HedgehogsGX/e-ink-dap/hardware/renders/pcb_top.png

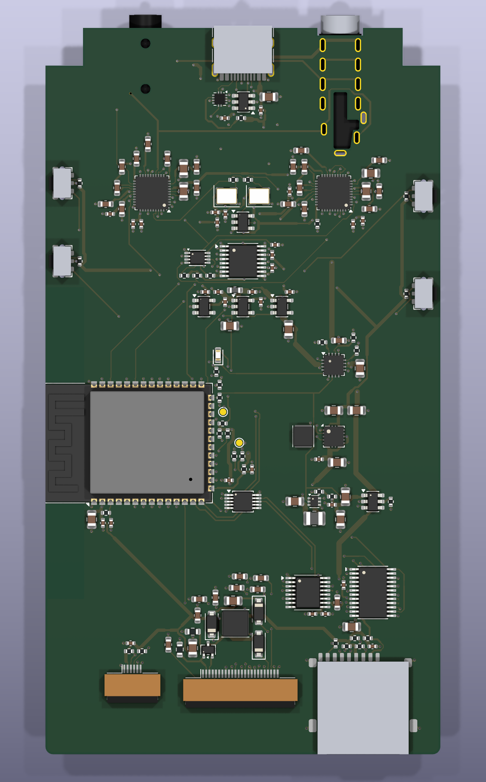
hardware/renders/pcb_top.png
