HedgehogsGX/e-ink-dap/hardware/renders/pcb_angle.png

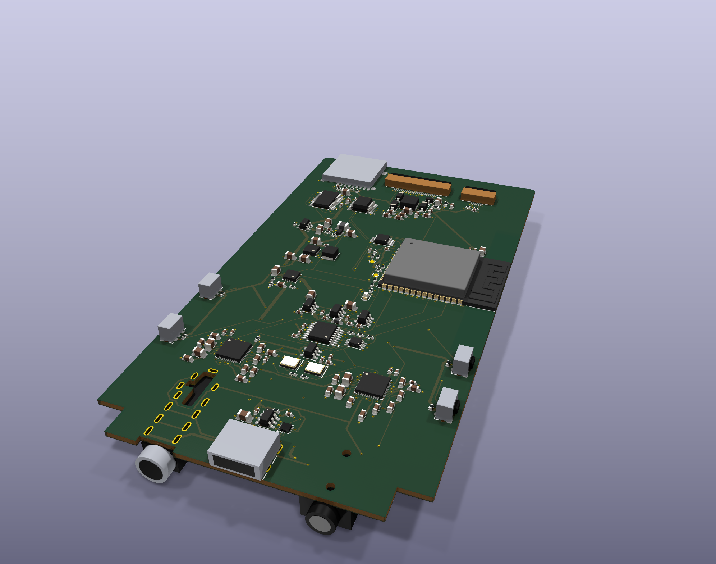
hardware/renders/pcb_angle.png
