HedgehogsGX/e-ink-dap/README.md

# e-ink-dap
DIY ESP32-S3 e-paper music player (DAP): firmware, bring-up tests and notes
