HedgehogsGX/e-ink-dap/case/renders/back.png

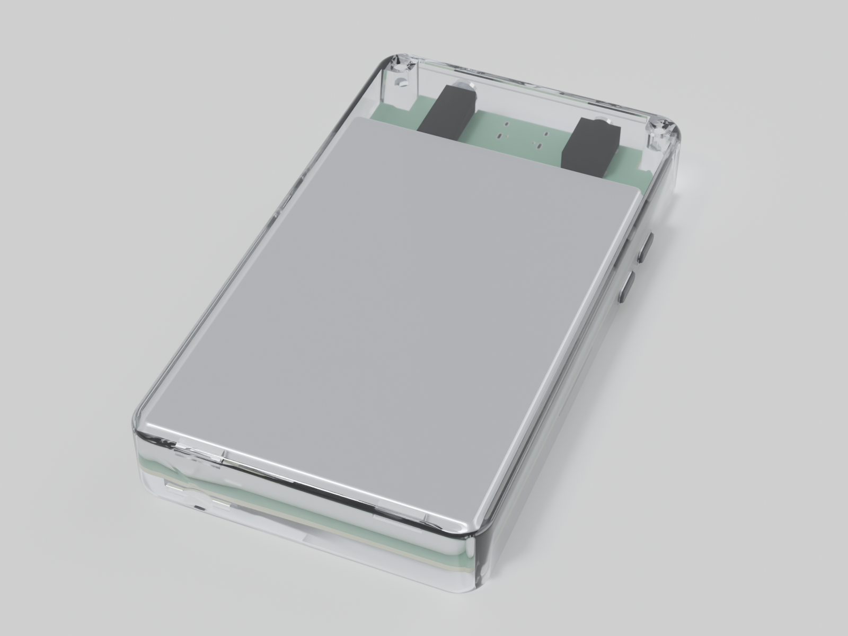
case/renders/back.png
