HedgehogsGX/e-ink-dap/case/renders/exploded.png

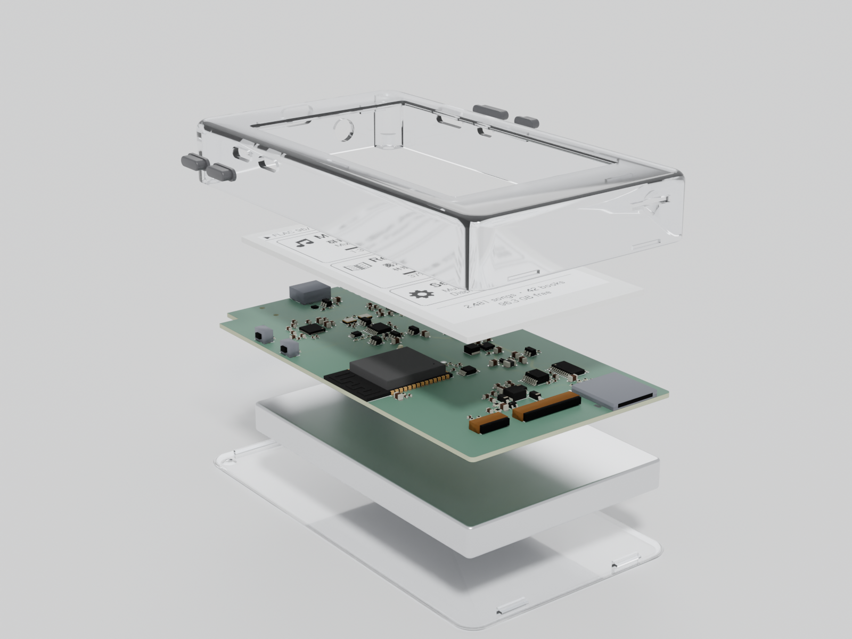
case/renders/exploded.png
