HedgehogsGX/e-ink-dap/case/renders/front.png

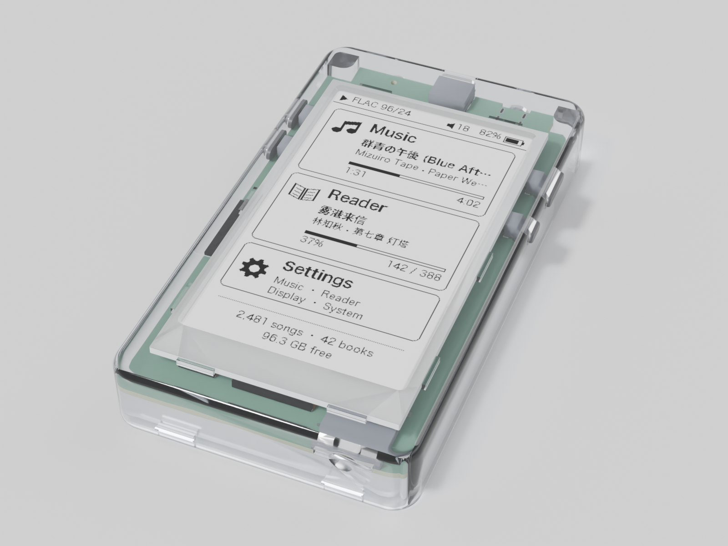
case/renders/front.png
