HedgehogsGX/e-ink-dap/case/renders/inside.png

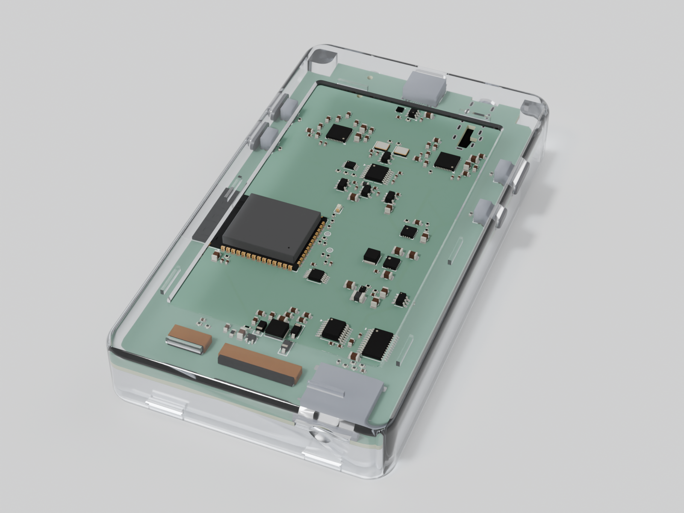
case/renders/inside.png
