HedgehogsGX/e-ink-dap/case/renders/ports.png

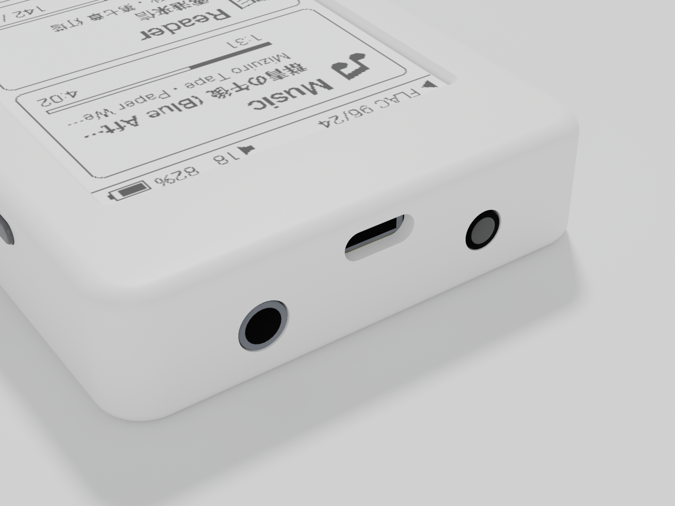
case/renders/ports.png
