HedgehogsGX/e-ink-dap/case/renders/side_left.png

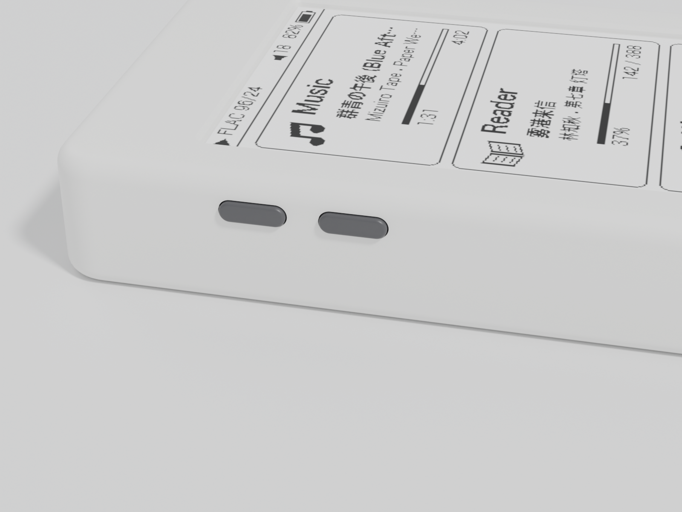
case/renders/side_left.png
