HedgehogsGX/e-ink-dap/case/renders/side_right.png

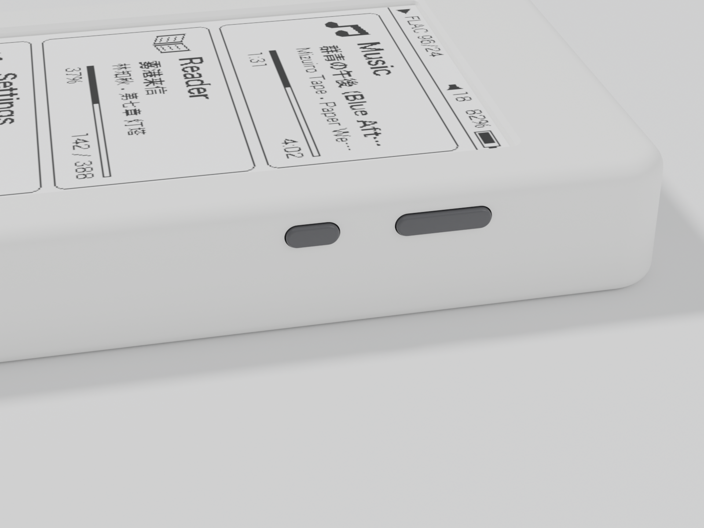
case/renders/side_right.png
