HedgehogsGX/e-ink-dap/docs/previews/eink_look.jpg

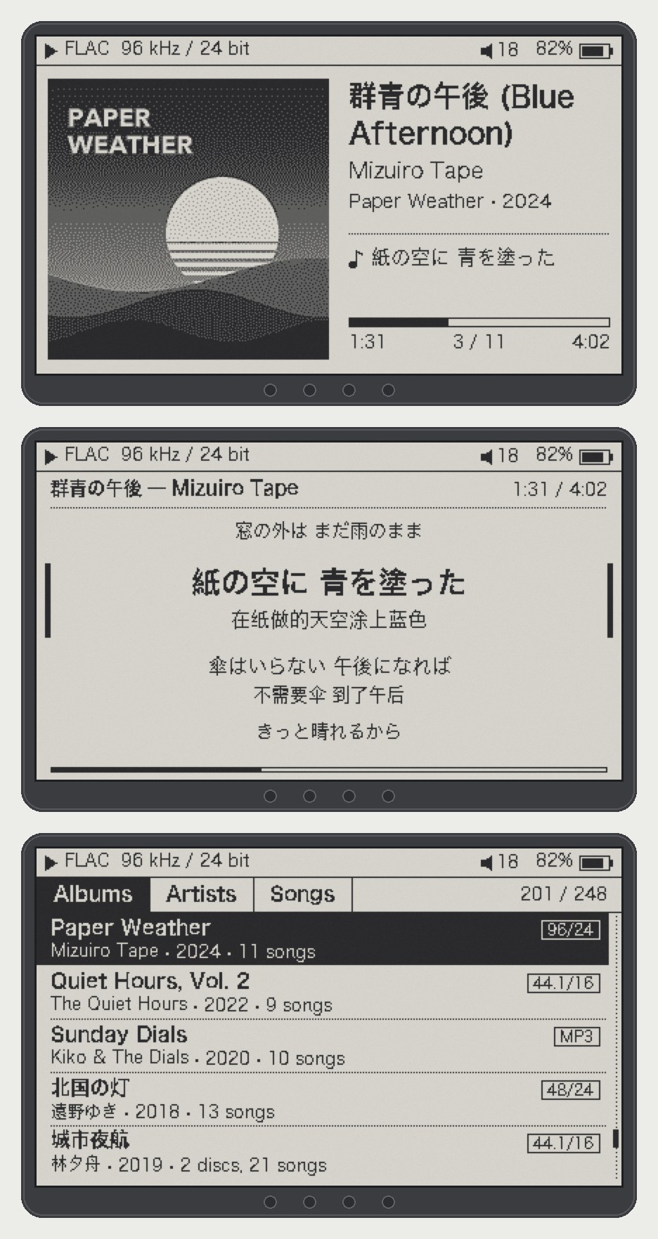
docs/previews/eink_look.jpg
