HedgehogsGX/e-ink-dap/docs/previews/eink_look_apps.jpg

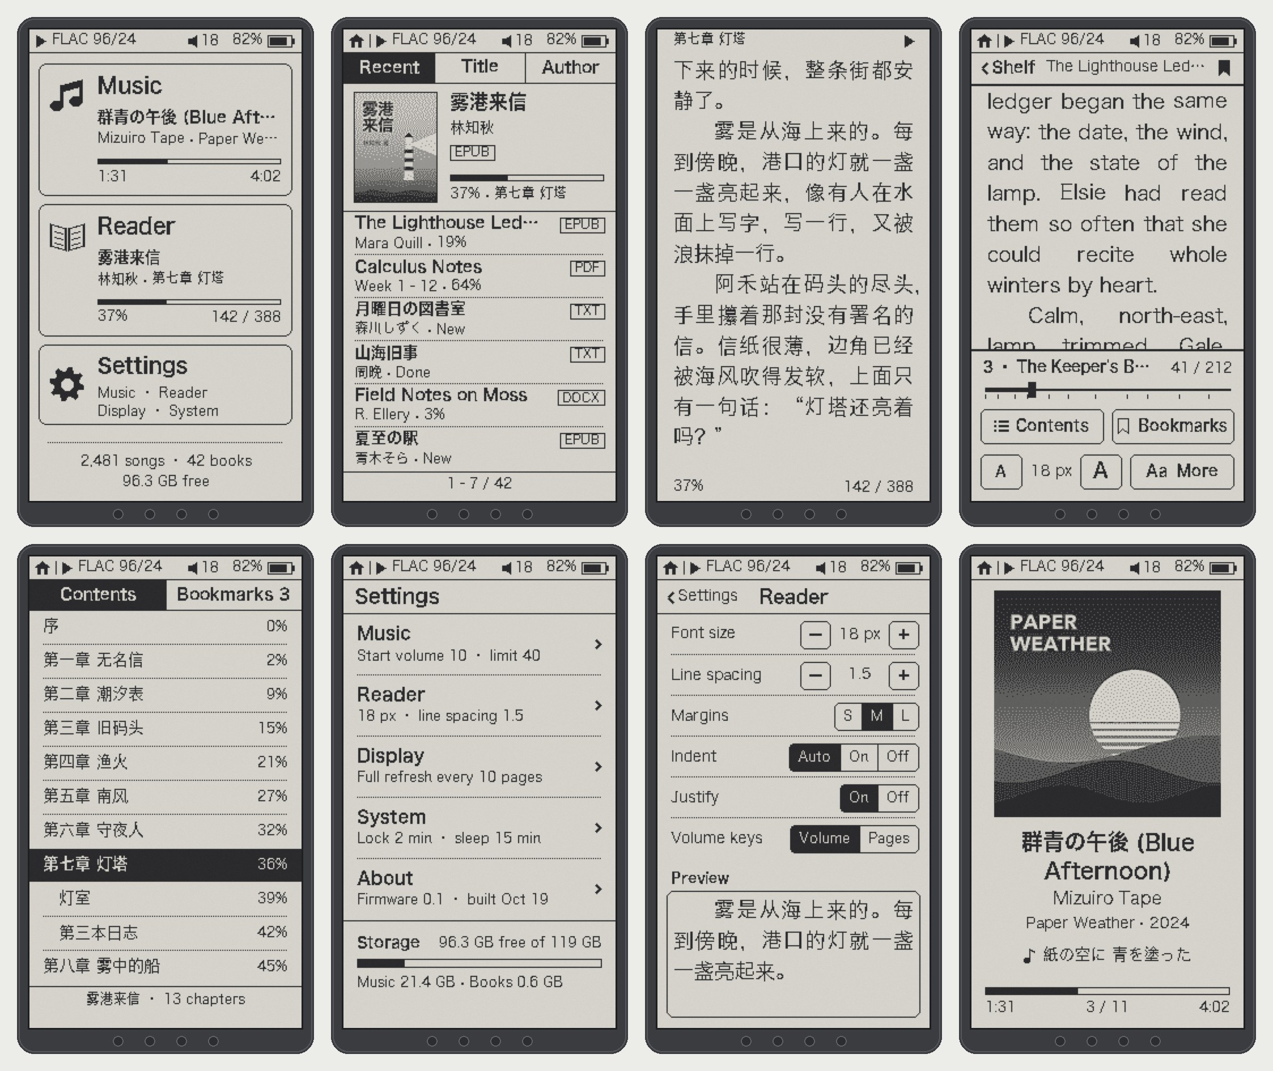
docs/previews/eink_look_apps.jpg
