HedgehogsGX/e-ink-dap/docs/previews/eink_look_portrait.jpg

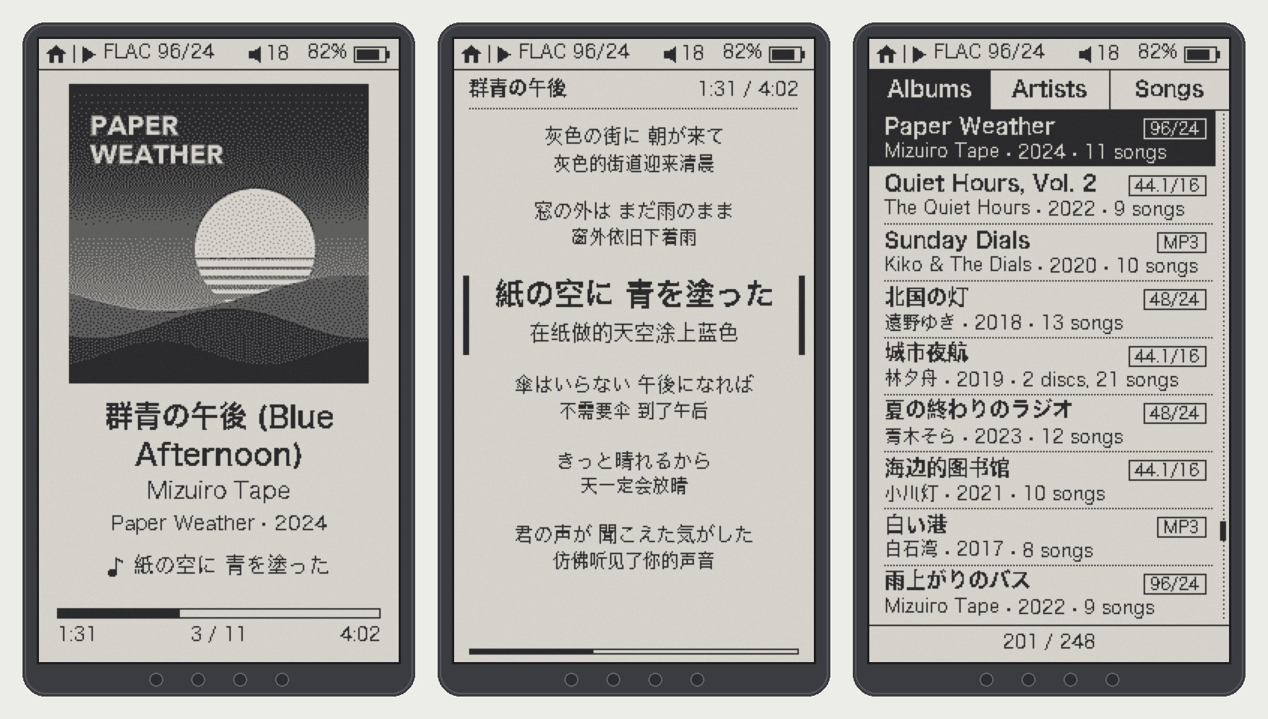
docs/previews/eink_look_portrait.jpg
