HedgehogsGX/e-ink-dap/docs/previews/home.png

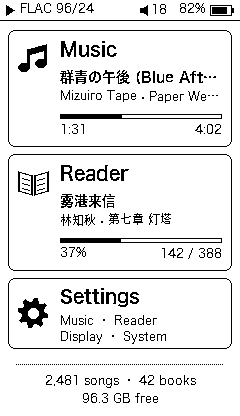
docs/previews/home.png
