HedgehogsGX/e-ink-dap/docs/previews/library.png

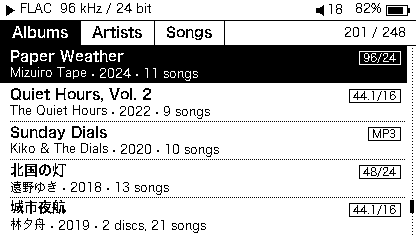
docs/previews/library.png
