HedgehogsGX/e-ink-dap/docs/previews/library_portrait.png

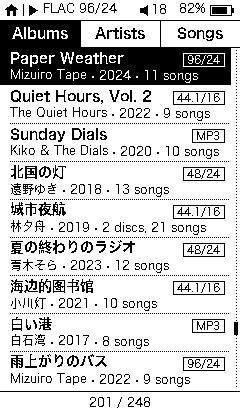
docs/previews/library_portrait.png
