HedgehogsGX/e-ink-dap/docs/previews/lyrics.png

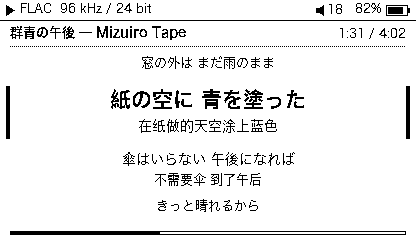
docs/previews/lyrics.png
