HedgehogsGX/e-ink-dap/docs/previews/lyrics_portrait.png

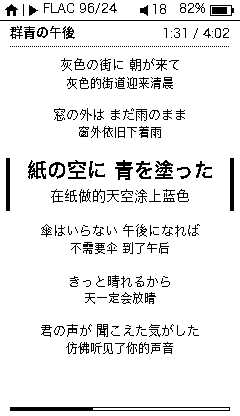
docs/previews/lyrics_portrait.png
