HedgehogsGX/e-ink-dap/docs/previews/now_playing.png

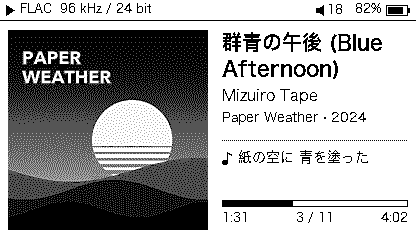
docs/previews/now_playing.png
