HedgehogsGX/e-ink-dap/docs/previews/now_playing_portrait.png

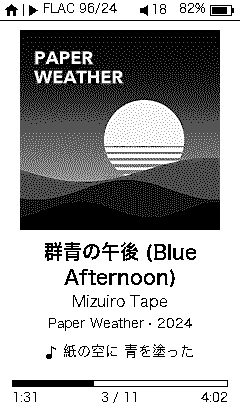
docs/previews/now_playing_portrait.png
