HedgehogsGX/e-ink-dap/docs/previews/orientations.jpg

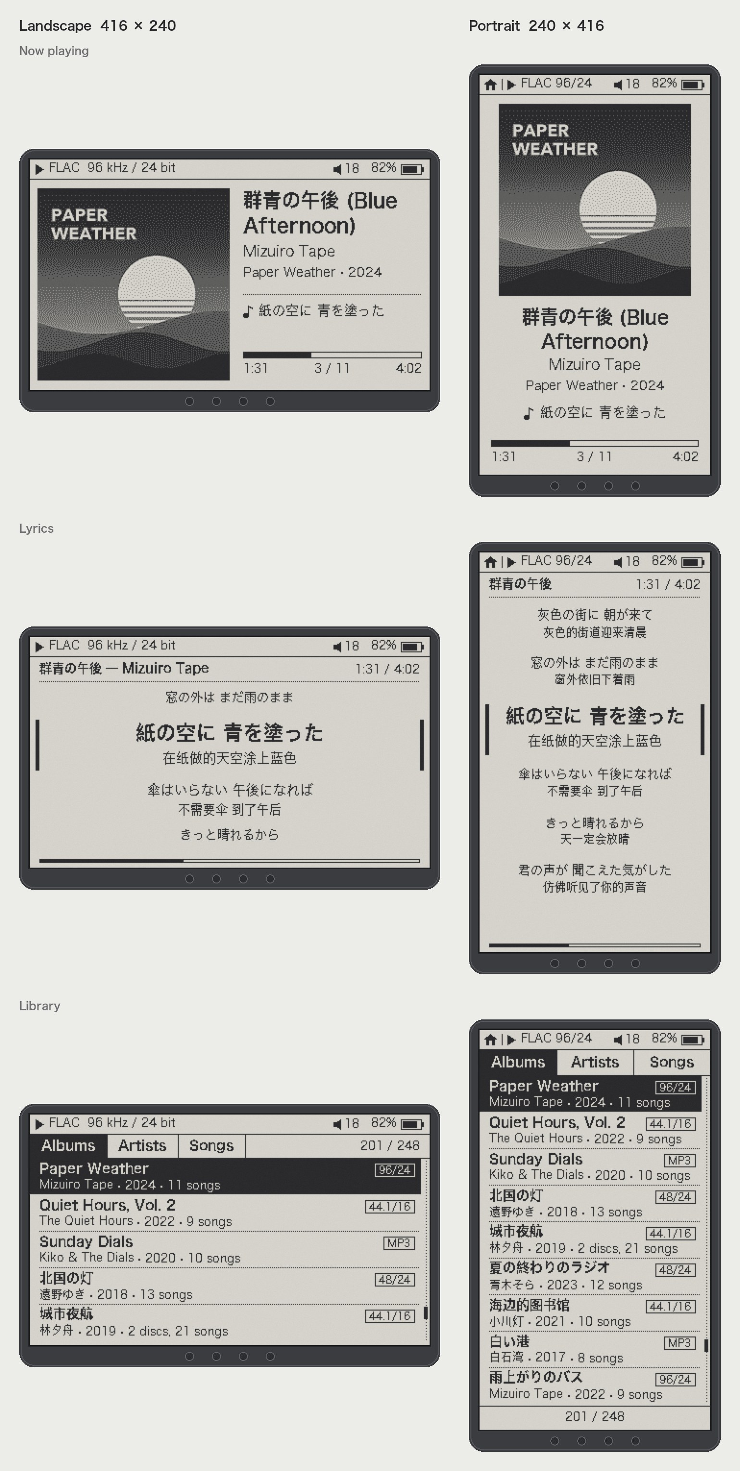
docs/previews/orientations.jpg
