HedgehogsGX/e-ink-dap/docs/previews/overview_x2.png

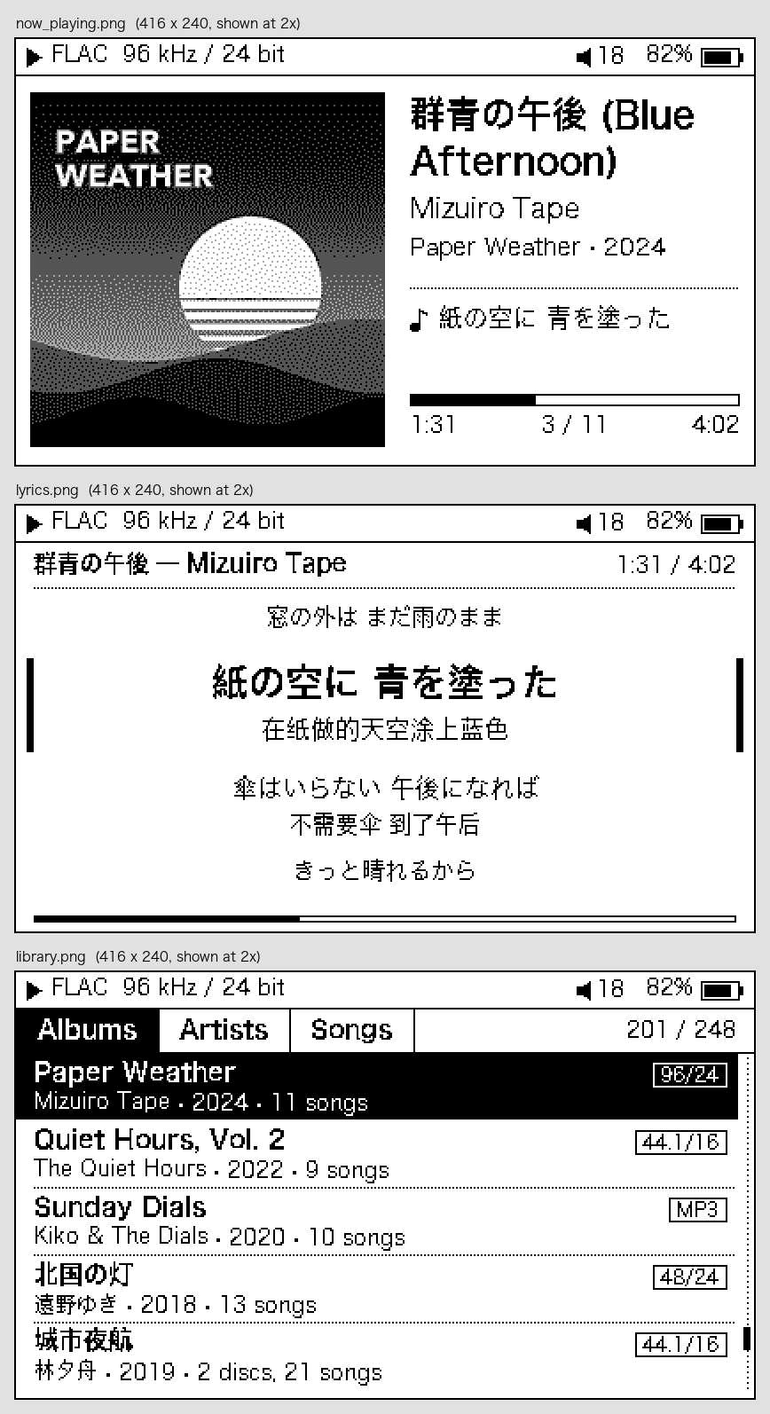
docs/previews/overview_x2.png
