HedgehogsGX/e-ink-dap/docs/previews/reader_contents.png

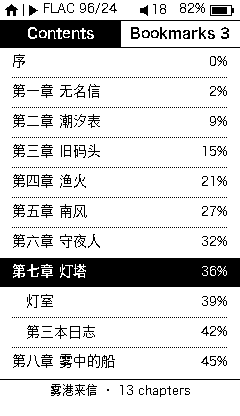
docs/previews/reader_contents.png
