HedgehogsGX/e-ink-dap/docs/previews/reader_menu.png

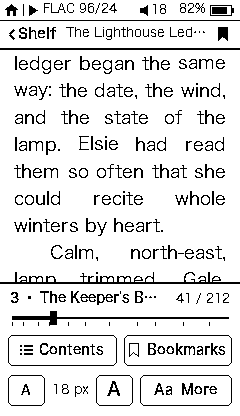
docs/previews/reader_menu.png
