HedgehogsGX/e-ink-dap/docs/previews/reader_page.png

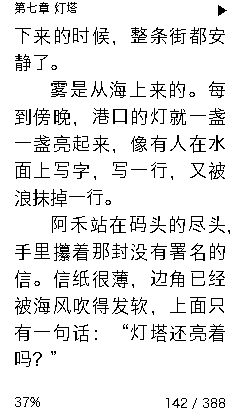
docs/previews/reader_page.png
