HedgehogsGX/e-ink-dap/docs/previews/settings.png

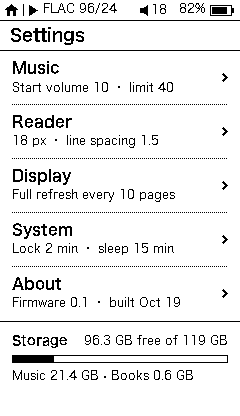
docs/previews/settings.png
