HedgehogsGX/e-ink-dap/docs/previews/settings_reader.png

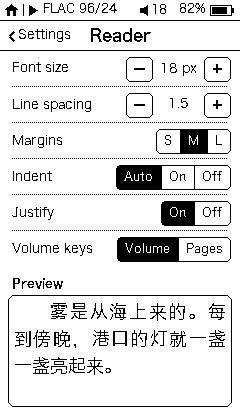
docs/previews/settings_reader.png
