HedgehogsGX/e-ink-dap/docs/previews/shelf.png

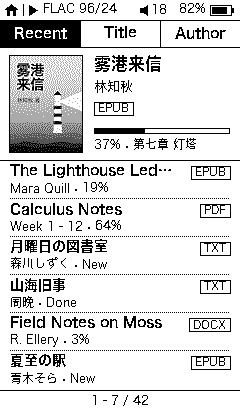
docs/previews/shelf.png
