HedgehogsGX/e-ink-dap/hardware/renders/pcb_bottom.png

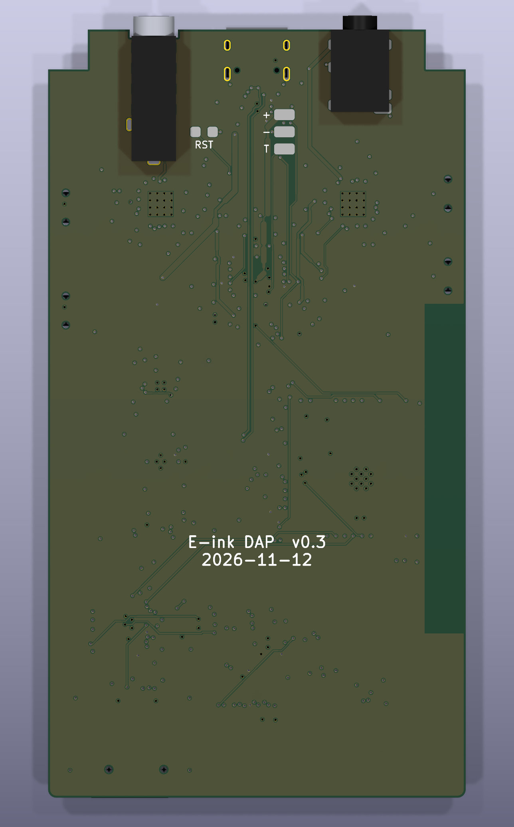
hardware/renders/pcb_bottom.png
