HedgehogsGX/e-ink-dap/hardware/jlcpcb/dap-bom-cn.csv

Comment | Designator | Footprint | 商品编号
1uF | C1 | 0603 | C15849
10uF | C2,C3,C4,C14,C15,C19,C34,C42 | 0805 | C15850
100nF | C5,C18,C20,C22,C35,C36,C37,C40,C41,C43,C44,C45,C46,C47,C48,C49,C50,C51,C52,C64,C65,C66 | 0402 | C1525
22uF | C6,C7,C16,C17,C55,C56,C69,C70 | 0805 | C45783
1uF | C8,C9,C10,C11,C12,C13,C21,C33,C39 | 0402 | C52923
4.7uF/50V | C23,C24 | 0805 | C98192
1uF/50V | C25,C26,C27,C28,C29,C30,C31,C32 | 0603 | C15849
4.7uF | C38,C53,C67 | 0603 | C19666
2.2uF | C54,C57,C58,C59,C60,C61,C62,C63,C68,C71,C72,C73,C74,C75,C76,C77 | 0603 | C23630
green | D1 | 0603 | C72043
MBR0530 | D2,D3,D4 | D_SOD-123 | C77336
600R@100MHz | FB1 | 0603 | C85833
E-paper FPC | J2 | Jushuo_AFC07-S24FCA-00_1x24-1MP_P0.50_Horizontal | C262567
Touch FPC | J3 | Jushuo_AFC07-S06FCA-00_1x6-1MP_P0.50_Horizontal | C262553
USB-C | J4 | USB_C_Receptacle_HRO_TYPE-C-31-M-12 | C165948
microSD | J5 | microSD_TF-01A | C91145
2.2uH | L1 | L_Cenker_CKCS3015 | C354563
1uH | L2 | 1008 | C435392
10uH | L3 | L_Changjiang_FNR4020S | C98364
Si1308EDL | Q1 | SOT-323_SC-70 | C469327
1.1k | R1 | 0402 | C25860
1.62k | R2 | 0402 | C61897
68k | R3 | 0402 | C36871
768k | R4 | 0402 | C27017
100k | R5,R8,R9,R10,R11,R13,R14,R15 | 0402 | C25741
47k | R6 | 0402 | C25792
10k | R7,R12,R23,R24,R26,R27,R28,R29,R30 | 0402 | C25744
1M | R16,R17 | 0402 | C26083
4.7k | R18,R19,R32,R33 | 0402 | C25900
1k | R20 | 0402 | C11702
1M | R21 | 0603 | C22935
0.47 | R22 | 0603 | C23411
887k | R25 | 0402 | C423127
200k | R31 | 0402 | C25764
22 | R34,R35 | 0402 | C25092
4.99k | R36 | 0402 | C25903
Play | SW1 | SW_Push_1P1T-MP_NO_Horizontal_Alps_SKRTLAE010 | C110293
Power | SW2 | SW_Push_1P1T-MP_NO_Horizontal_Alps_SKRTLAE010 | C110293
Vol+ | SW3 | SW_Push_1P1T-MP_NO_Horizontal_Alps_SKRTLAE010 | C110293
Vol- | SW4 | SW_Push_1P1T-MP_NO_Horizontal_Alps_SKRTLAE010 | C110293
BQ24073RGTR | U1 | VQFN-16-1EP_3x3mm_P0.5mm_EP1.6x1.6mm | C15220
TPS63001DRCR | U2 | Texas_DRC0010J_ThermalVias | C28060
LP5907MFX-1.8 | U3,U4,U5 | SOT-23-5 | C92498
TPS61023DRLR | U6 | SOT-563 | C919459
TPS2553DBVR | U7 | SOT-23-6 | C55266
ESP32-S3-WROOM-1-N16R8 | U8 | ESP32-S3-WROOM-1 | C2913202
USBLC6-2SC6 | U9 | SOT-23-6 | C7519
TUSB320LIRWBR | U10 | Texas_X2QFN-12_1.6x1.6mm_P0.4mm | C2836598
FSUSB42MUX | U11 | MSOP-10_3x3mm_P0.5mm | C11355
GL823K-HCY04 | U12 | SSOP-16_3.9x4.9mm_P0.635mm | C284879
TS3A27518EPWR | U13 | TSSOP-24_4.4x7.8mm_P0.65mm | C443721
SN74AVC4T774PWR | U14 | TSSOP-16_4.4x5mm_P0.65mm | C129363
PCA9306DCUR | U15 | VSSOP-8_2.3x2mm_P0.5mm | C33196
74LVC1G04 | U16 | SOT-23-5 | C33962550
CS43131-CNZR | U17,U18 | QFN-40-1EP_5x5mm_P0.4mm_EP3.6x3.6mm_ThermalVias | C965907
22.5792MHz | Y1 | Oscillator_SMD_Abracon_ASE-4Pin_3.2x2.5mm | C2901572
24.576MHz | Y2 | Oscillator_SMD_Abracon_ASE-4Pin_3.2x2.5mm | C2901574
