HedgehogsGX/e-ink-dap/case/stl/volume_key.stl

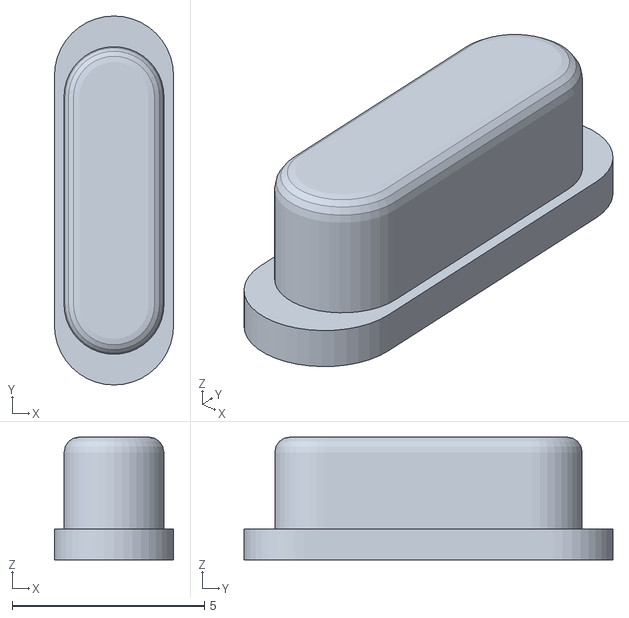
[picture p31: CAD file, 2026-10-31]
case/stl/volume_key.stl
3.10 x 9.60 x 3.20
