HedgehogsGX/e-ink-dap/case/stl/back_cover.stl

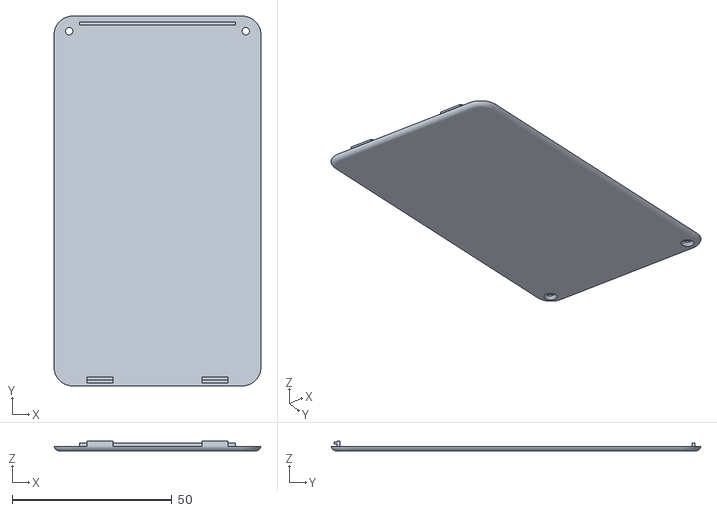
[picture p32: CAD file, 2026-10-31]
case/stl/back_cover.stl
64.8 x 115.8 x 3.20
