HedgehogsGX/e-ink-dap/case/stl/front_shell.stl

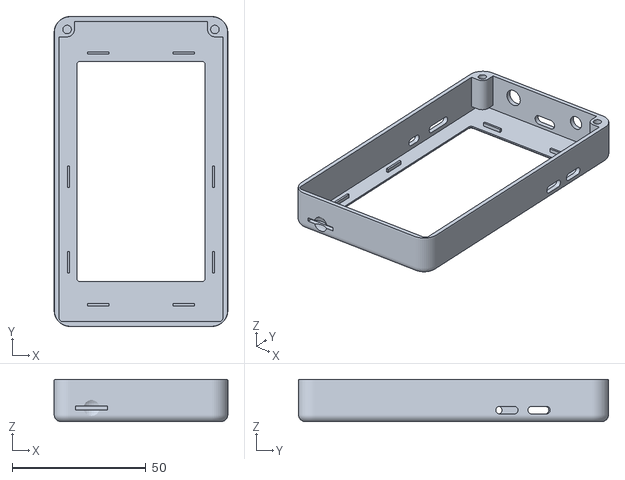
[picture p33: CAD file, 2026-10-31]
case/stl/front_shell.stl
65.0 x 116.0 x 15.8
