HedgehogsGX/e-ink-dap/case/stl/play_key.stl

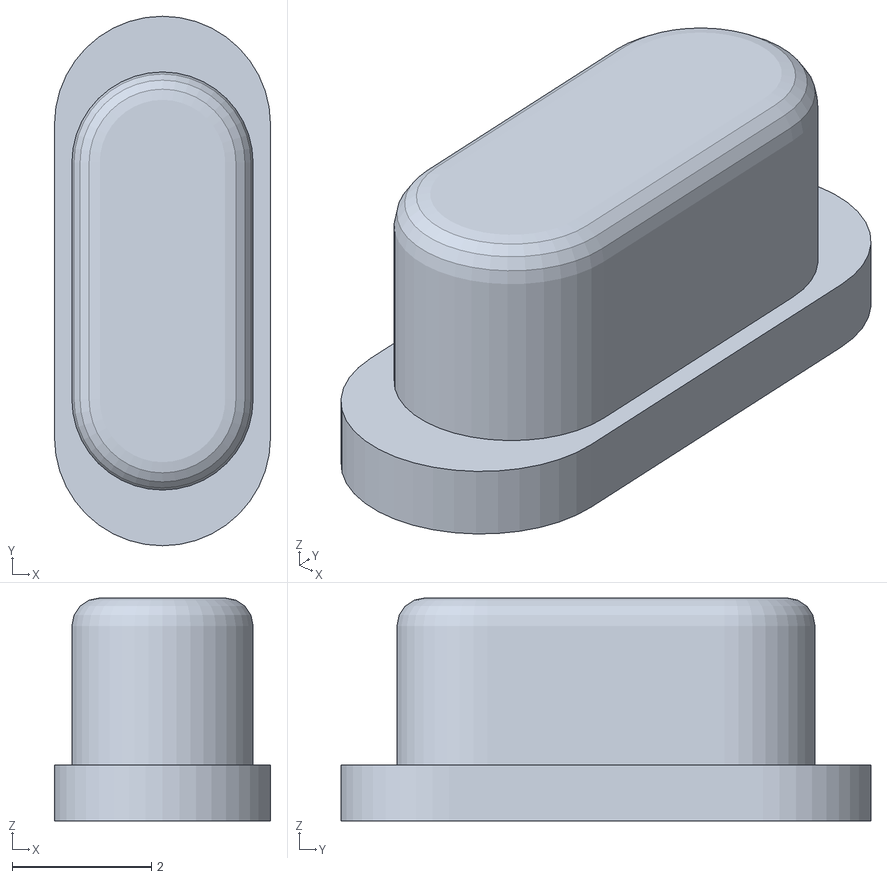
[picture p34: CAD file, 2026-10-24]
case/stl/play_key.stl
3.10 x 7.60 x 3.20
