HedgehogsGX/e-ink-dap/case/stl/power_key.stl

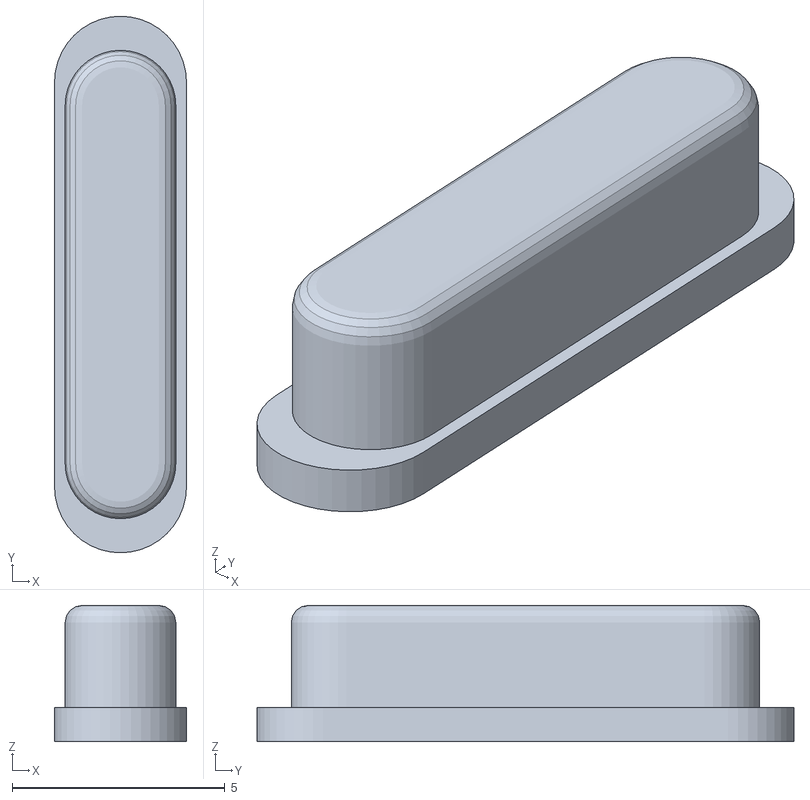
[picture p35: CAD file, 2026-10-24]
case/stl/power_key.stl
3.10 x 12.6 x 3.20
