HedgehogsGX/e-ink-dap/(list of files, cad)

Other CAD files:
case/dap_case.blend
