HedgehogsGX/e-ink-dap/hardware/dap.kicad_pcb

## KiCad design hardware/dap.kicad_pcb (2026-11-13)

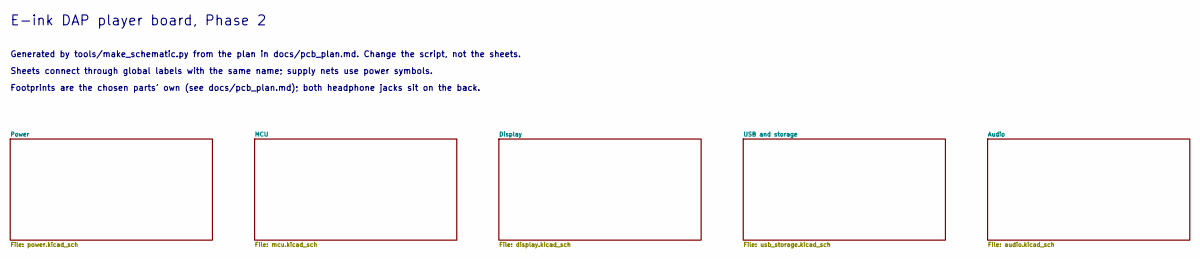
[picture p42: schematic dap.kicad_sch]

Notes on the sheet:
E-ink DAP player board, Phase 2
Generated by tools/make_schematic.py from the plan in docs/pcb_plan.md. Change the script, not the sheets.
Sheets connect through global labels with the same name; supply nets use power symbols.
Footprints are the chosen parts' own (see docs/pcb_plan.md); both headphone jacks sit on the back.

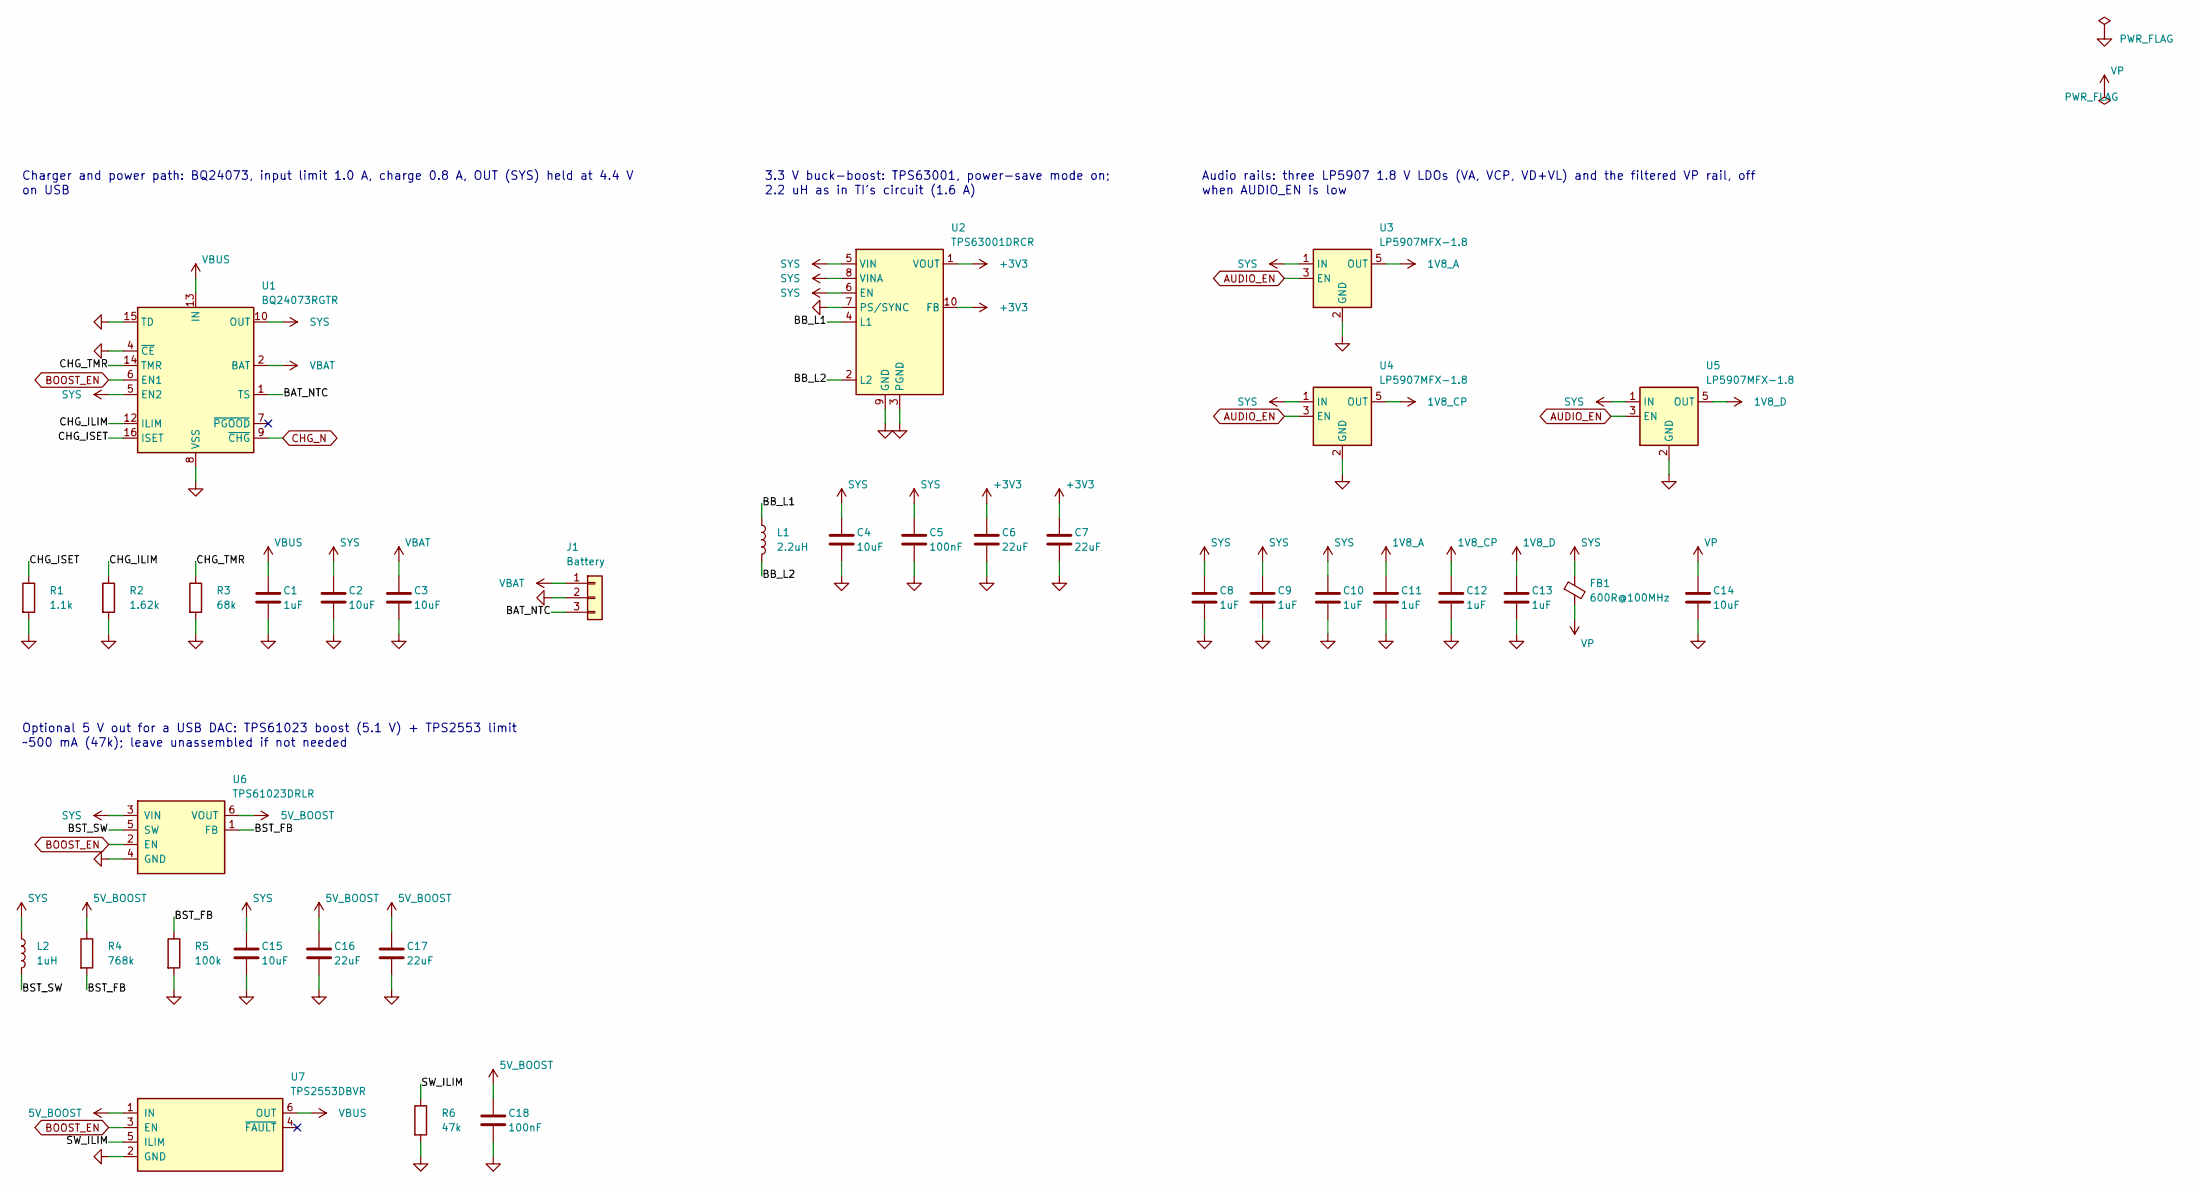
[picture p43: schematic power.kicad_sch]

Parts:
C1: 1uF; C_0603_1608Metric; LCSC C15849
C2, C3, C4, C14, C15: 10uF; C_0805_2012Metric; LCSC C15850
C5, C18: 100nF; C_0402_1005Metric; LCSC C1525
C6, C7, C16, C17: 22uF; C_0805_2012Metric; LCSC C45783
C8, C9, C10, C11, C12, C13: 1uF; C_0402_1005Metric; LCSC C52923
FB1: 600R@100MHz; L_0603_1608Metric; LCSC C85833
J1: Battery; Battery_Pads_1x03
L1: 2.2uH; L_Cenker_CKCS3015; LCSC C354563
L2: 1uH; L_1008_2520Metric; LCSC C435392
R1: 1.1k; R_0402_1005Metric; LCSC C25860
R2: 1.62k; R_0402_1005Metric; LCSC C61897
R3: 68k; R_0402_1005Metric; LCSC C36871
R4: 768k; R_0402_1005Metric; LCSC C27017
R5: 100k; R_0402_1005Metric; LCSC C25741
R6: 47k; R_0402_1005Metric; LCSC C25792
U1: BQ24073RGTR; VQFN-16-1EP_3x3mm_P0.5mm_EP1.6x1.6mm; LCSC C15220
U2: TPS63001DRCR; Texas_DRC0010J_ThermalVias; LCSC C28060
U3, U4, U5: LP5907MFX-1.8; SOT-23-5; LCSC C92498
U6: TPS61023DRLR; SOT-563; LCSC C919459
U7: TPS2553DBVR; SOT-23-6; LCSC C55266

Connections:
1V8_A: C11.1, U3.5 (OUT); also elsewhere on the board
1V8_CP: C12.1, U4.5 (OUT); also elsewhere on the board
1V8_D: C13.1, U5.5 (OUT); also elsewhere on the board
5V_BOOST: C16.1, C17.1, C18.1, R4.1, U6.6 (VOUT), U7.1 (IN)
+3V3: C6.1, C7.1, U2.1 (VOUT), U2.10 (FB); also elsewhere on the board
/Power/BAT_NTC: J1.3, U1.1 (TS)
/Power/BB_L1: L1.1, U2.4 (L1)
/Power/BB_L2: L1.2, U2.2 (L2)
/Power/BST_FB: R4.2, R5.1, U6.1 (FB)
/Power/BST_SW: L2.2, U6.5 (SW)
/Power/CHG_ILIM: R2.1, U1.12 (ILIM)
/Power/CHG_ISET: R1.1, U1.16 (ISET)
/Power/CHG_TMR: R3.1, U1.14 (TMR)
/Power/SW_ILIM: R6.1, U7.5 (ILIM)
AUDIO_EN: U3.3 (EN), U4.3 (EN), U5.3 (EN); also elsewhere on the board
BOOST_EN: U1.6 (EN1), U6.2 (EN), U7.3 (EN); also elsewhere on the board
CHG_N: U1.9 (~CHG); also elsewhere on the board
GND: C1.2, C2.2, C3.2, C4.2, C5.2, C6.2, C7.2, C8.2, C9.2, C10.2, C11.2, C12.2, C13.2, C14.2, C15.2, C16.2, C17.2, C18.2, J1.2, R1.2, R2.2, R3.2, R5.2, R6.2, U1.4 (~CE), U1.8 (VSS), U1.15 (TD), U1.17 (VSS), U2.3 (PGND), U2.7 (PS/SYNC), U2.9 (GND), U2.11 (PGND), U3.2 (GND), U4.2 (GND), U5.2 (GND), U6.4 (GND), U7.2 (GND); also elsewhere on the board
SYS: C2.1, C4.1, C5.1, C8.1, C9.1, C10.1, C15.1, FB1.1, L2.1, U1.5 (EN2), U1.10 (OUT), U1.11 (OUT), U2.5 (VIN), U2.6 (EN), U2.8 (VINA), U3.1 (IN), U4.1 (IN), U5.1 (IN), U6.3 (VIN)
VBAT: C3.1, J1.1, U1.2 (BAT), U1.3 (BAT); also elsewhere on the board
VBUS: C1.1, U1.13 (IN), U7.6 (OUT); also elsewhere on the board
VP: C14.1, FB1.2; also elsewhere on the board

Notes on the sheet:
Charger and power path: BQ24073, input limit 1.0 A, charge 0.8 A, OUT (SYS) held at 4.4 V
on USB
3.3 V buck-boost: TPS63001, power-save mode on;
2.2 uH as in TI's circuit (1.6 A)
Audio rails: three LP5907 1.8 V LDOs (VA, VCP, VD+VL) and the filtered VP rail, off
when AUDIO_EN is low
Optional 5 V out for a USB DAC: TPS61023 boost (5.1 V) + TPS2553 limit
~500 mA (47k); leave unassembled if not needed

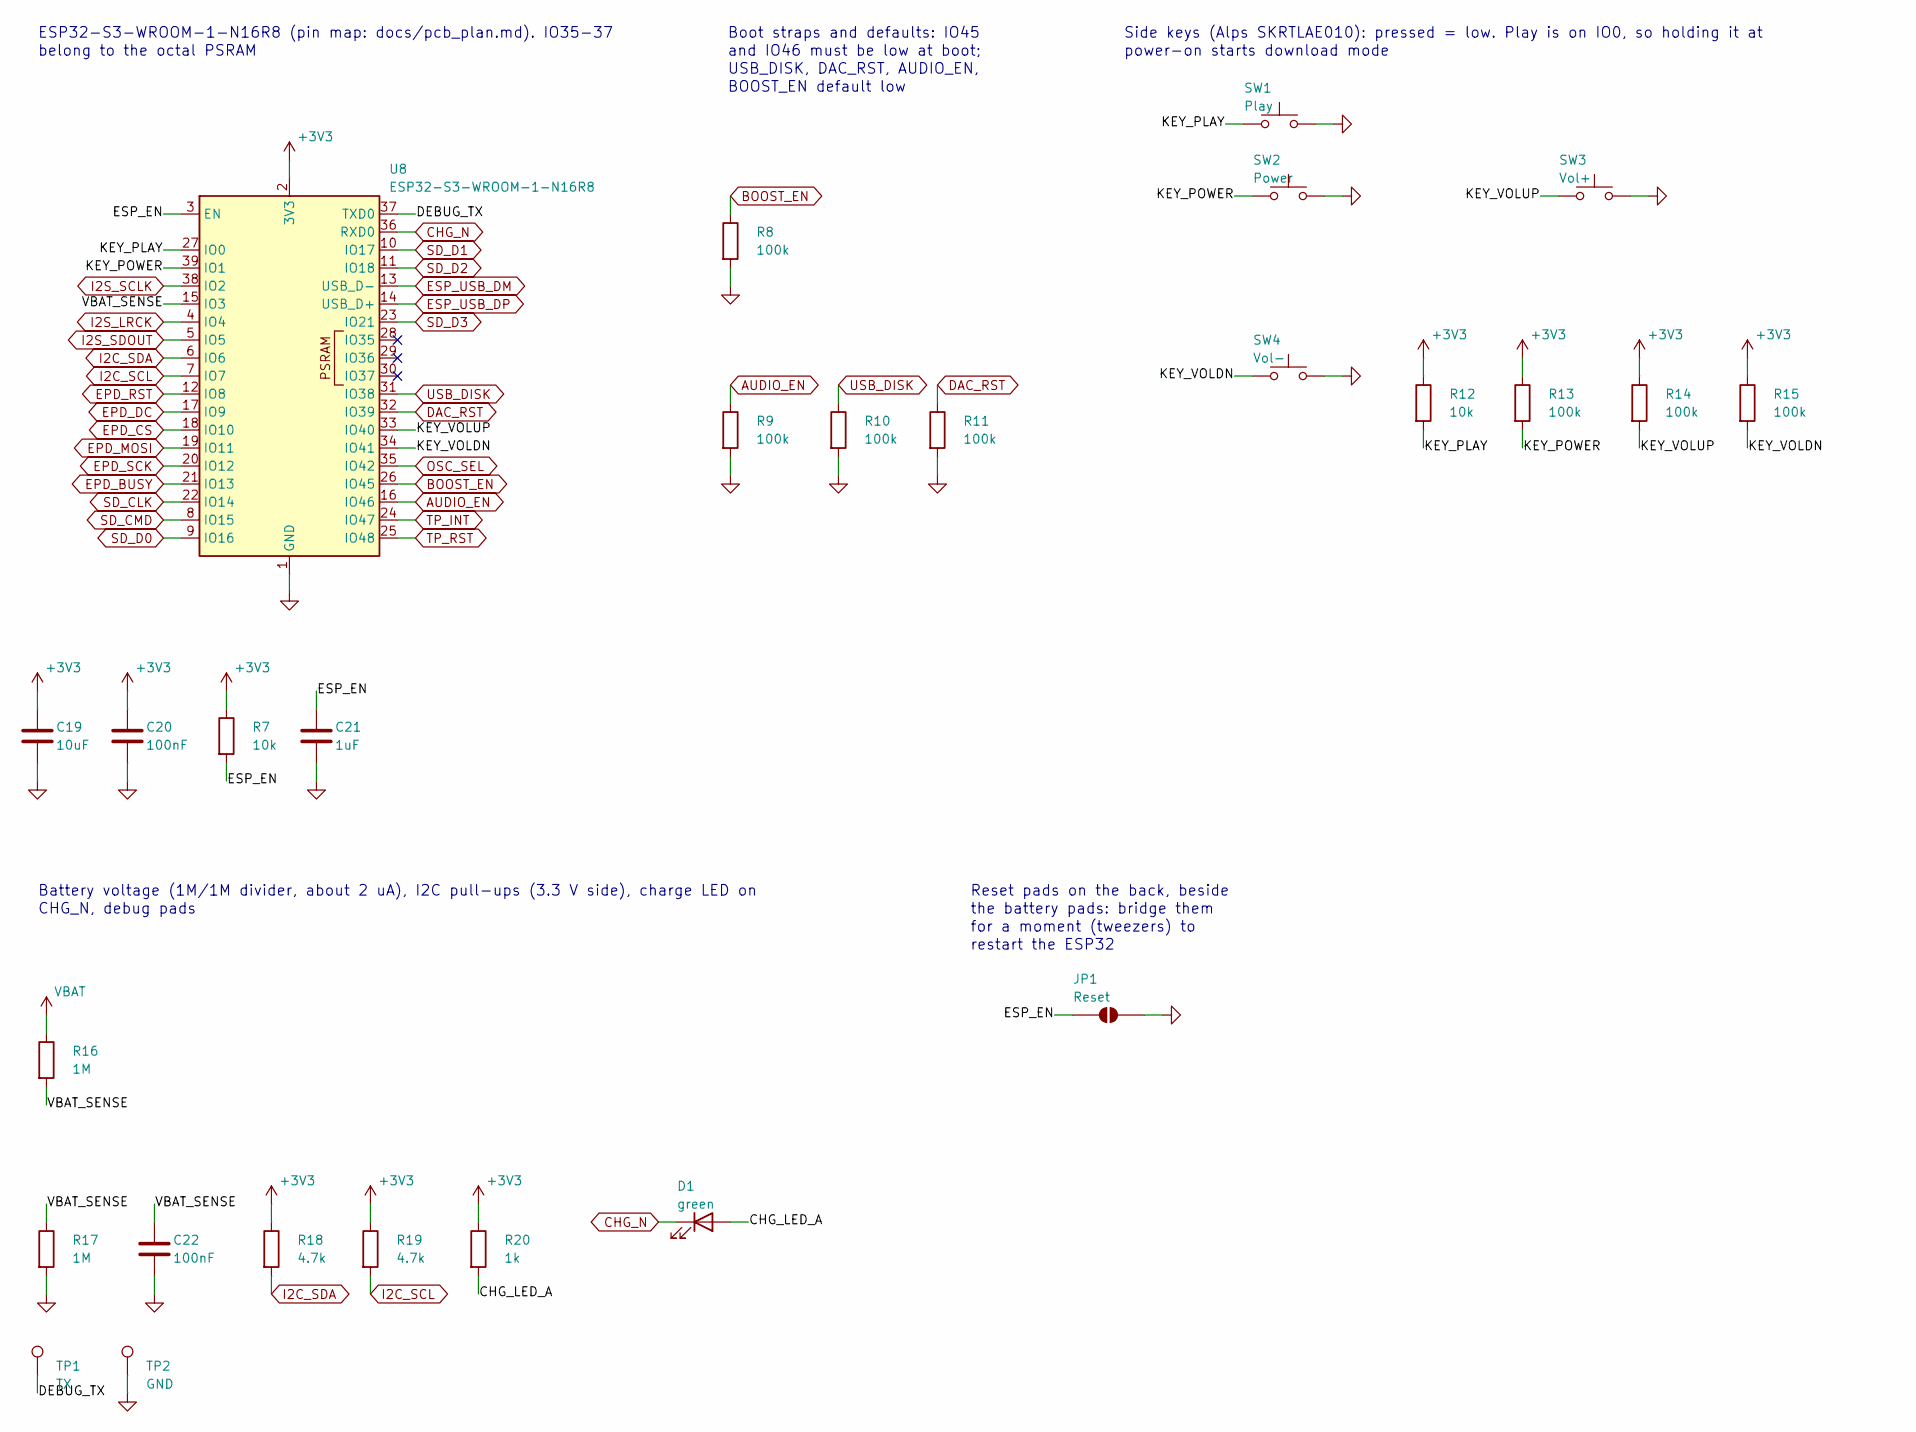
[picture p44: schematic mcu.kicad_sch]

Parts:
C19: 10uF; C_0805_2012Metric; LCSC C15850
C20, C22: 100nF; C_0402_1005Metric; LCSC C1525
C21: 1uF; C_0402_1005Metric; LCSC C52923
D1: green; LED_0603_1608Metric; LCSC C72043
JP1: Reset; Reset_Pads_1x02
R7, R12: 10k; R_0402_1005Metric; LCSC C25744
R8, R9, R10, R11, R13, R14, R15: 100k; R_0402_1005Metric; LCSC C25741
R16, R17: 1M; R_0402_1005Metric; LCSC C26083
R18, R19: 4.7k; R_0402_1005Metric; LCSC C25900
R20: 1k; R_0402_1005Metric; LCSC C11702
SW1: Play; SW_Push_1P1T-MP_NO_Horizontal_Alps_SKRTLAE010; LCSC C110293
SW2: Power; SW_Push_1P1T-MP_NO_Horizontal_Alps_SKRTLAE010; LCSC C110293
SW3: Vol+; SW_Push_1P1T-MP_NO_Horizontal_Alps_SKRTLAE010; LCSC C110293
SW4: Vol-; SW_Push_1P1T-MP_NO_Horizontal_Alps_SKRTLAE010; LCSC C110293
TP1: TX; TestPoint_Pad_D1.0mm
TP2: GND; TestPoint_Pad_D1.0mm
U8: ESP32-S3-WROOM-1-N16R8; ESP32-S3-WROOM-1; LCSC C2913202

Connections:
+3V3: C19.1, C20.1, R7.1, R12.1, R13.1, R14.1, R15.1, R18.1, R19.1, R20.1, U8.2 (3V3); also elsewhere on the board
/MCU/CHG_LED_A: D1.2 (A), R20.2
/MCU/DEBUG_TX: TP1.1, U8.37 (TXD0)
/MCU/ESP_EN: C21.1, JP1.1 (A), R7.2, U8.3 (EN)
/MCU/KEY_PLAY: R12.2, SW1.1, U8.27 (IO0)
/MCU/KEY_POWER: R13.2, SW2.1, U8.39 (IO1)
/MCU/KEY_VOLDN: R15.2, SW4.1, U8.34 (IO41)
/MCU/KEY_VOLUP: R14.2, SW3.1, U8.33 (IO40)
/MCU/VBAT_SENSE: C22.1, R16.2, R17.1, U8.15 (IO3)
AUDIO_EN: R9.1, U8.16 (IO46); also elsewhere on the board
BOOST_EN: R8.1, U8.26 (IO45); also elsewhere on the board
CHG_N: D1.1 (K), U8.36 (RXD0); also elsewhere on the board
DAC_RST: R11.1, U8.32 (IO39); also elsewhere on the board
EPD_BUSY: U8.21 (IO13); also elsewhere on the board
EPD_CS: U8.18 (IO10); also elsewhere on the board
EPD_DC: U8.17 (IO9); also elsewhere on the board
EPD_MOSI: U8.19 (IO11); also elsewhere on the board
EPD_RST: U8.12 (IO8); also elsewhere on the board
EPD_SCK: U8.20 (IO12); also elsewhere on the board
ESP_USB_DM: U8.13 (USB_D-); also elsewhere on the board
ESP_USB_DP: U8.14 (USB_D+); also elsewhere on the board
GND: C19.2, C20.2, C21.2, C22.2, JP1.2 (B), R8.2, R9.2, R10.2, R11.2, R17.2, SW1.2, SW2.2, SW3.2, SW4.2, TP2.1, U8.1 (GND), U8.40 (GND), U8.41 (GND); also elsewhere on the board
I2C_SCL: R19.2, U8.7 (IO7); also elsewhere on the board
I2C_SDA: R18.2, U8.6 (IO6); also elsewhere on the board
I2S_LRCK: U8.4 (IO4); also elsewhere on the board
I2S_SCLK: U8.38 (IO2); also elsewhere on the board
I2S_SDOUT: U8.5 (IO5); also elsewhere on the board
OSC_SEL: U8.35 (IO42); also elsewhere on the board
SD_CLK: U8.22 (IO14); also elsewhere on the board
SD_CMD: U8.8 (IO15); also elsewhere on the board
SD_D0: U8.9 (IO16); also elsewhere on the board
SD_D1: U8.10 (IO17); also elsewhere on the board
SD_D2: U8.11 (IO18); also elsewhere on the board
SD_D3: U8.23 (IO21); also elsewhere on the board
TP_INT: U8.24 (IO47); also elsewhere on the board
TP_RST: U8.25 (IO48); also elsewhere on the board
USB_DISK: R10.1, U8.31 (IO38); also elsewhere on the board
VBAT: R16.1; also elsewhere on the board

Notes on the sheet:
ESP32-S3-WROOM-1-N16R8 (pin map: docs/pcb_plan.md). IO35-37
belong to the octal PSRAM
Boot straps and defaults: IO45
and IO46 must be low at boot;
USB_DISK, DAC_RST, AUDIO_EN,
BOOST_EN default low
Side keys (Alps SKRTLAE010): pressed = low. Play is on IO0, so holding it at
power-on starts download mode
Battery voltage (1M/1M divider, about 2 uA), I2C pull-ups (3.3 V side), charge LED on
CHG_N, debug pads
Reset pads on the back, beside
the battery pads: bridge them
for a moment (tweezers) to
restart the ESP32

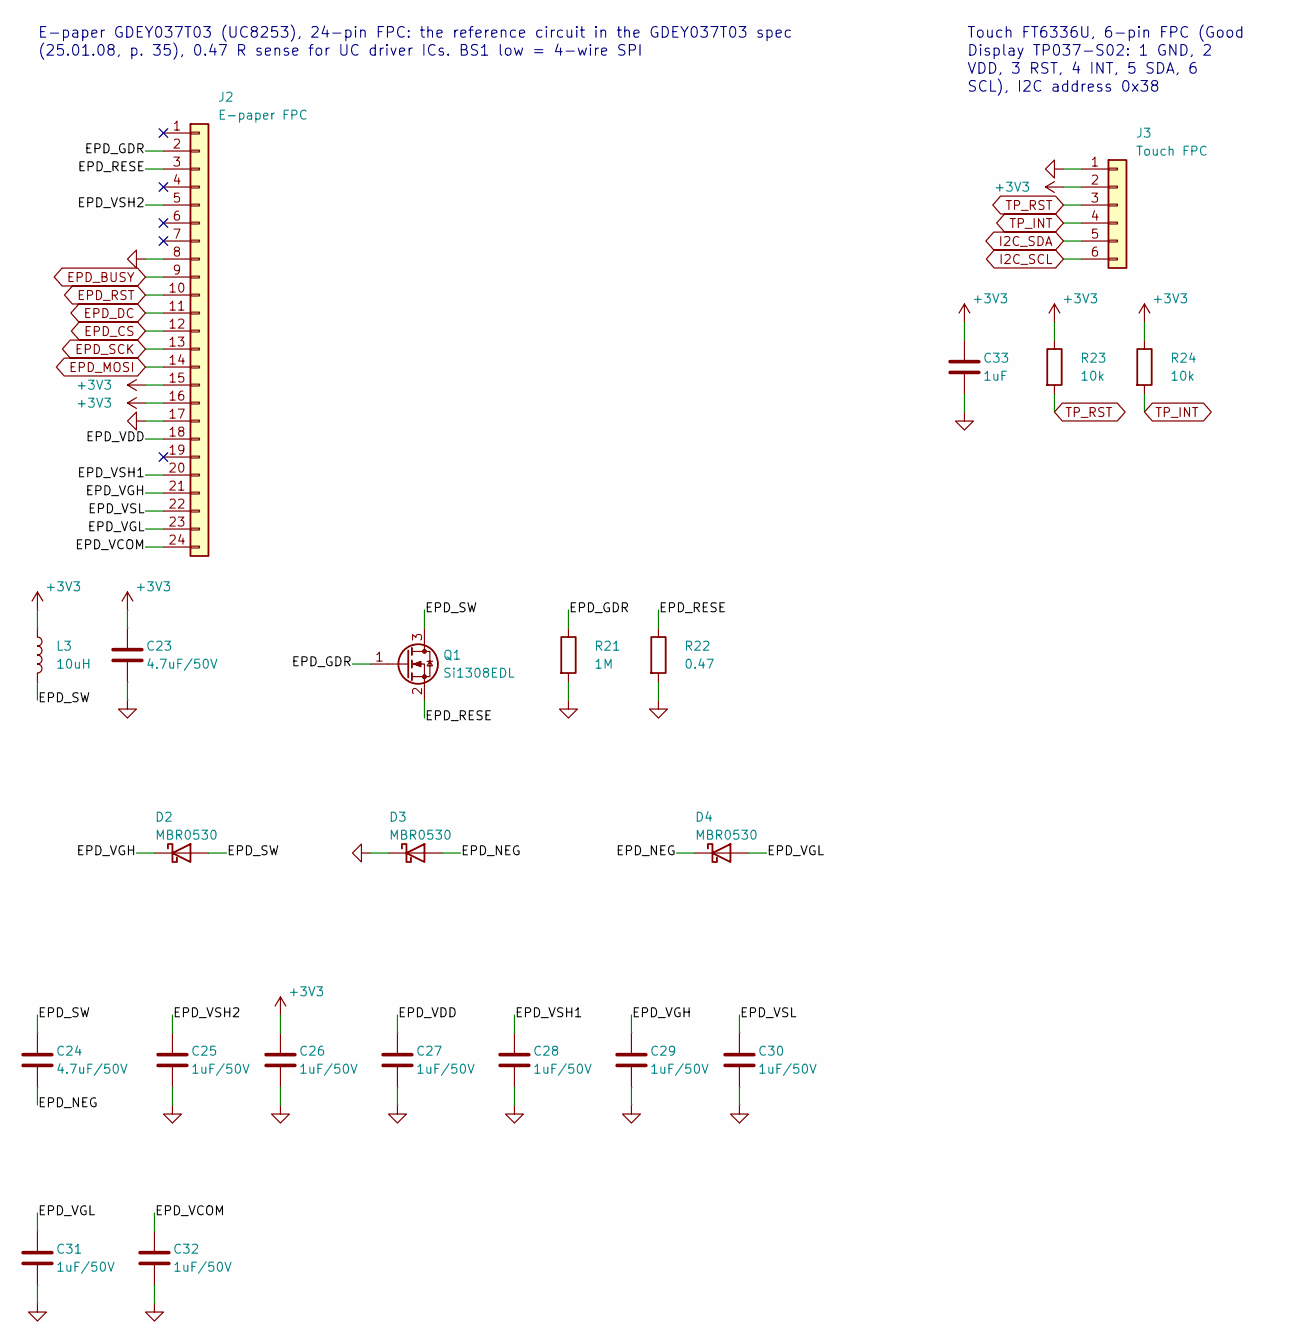
[picture p45: schematic display.kicad_sch]

Parts:
C23, C24: 4.7uF/50V; C_0805_2012Metric; LCSC C98192
C25, C26, C27, C28, C29, C30, C31, C32: 1uF/50V; C_0603_1608Metric; LCSC C15849
C33: 1uF; C_0402_1005Metric; LCSC C52923
D2, D3, D4: MBR0530; D_SOD-123; LCSC C77336
J2: E-paper FPC; Jushuo_AFC07-S24FCA-00_1x24-1MP_P0.50_Horizontal; LCSC C262567
J3: Touch FPC; Jushuo_AFC07-S06FCA-00_1x6-1MP_P0.50_Horizontal; LCSC C262553
L3: 10uH; L_Changjiang_FNR4020S; LCSC C98364
Q1: Si1308EDL; SOT-323_SC-70; LCSC C469327
R21: 1M; R_0603_1608Metric; LCSC C22935
R22: 0.47; R_0603_1608Metric; LCSC C23411
R23, R24: 10k; R_0402_1005Metric; LCSC C25744

Connections:
+3V3: C23.1, C26.1, C33.1, J2.15, J2.16, J3.2, L3.1, R23.1, R24.1; also elsewhere on the board
/Display/EPD_GDR: J2.2, Q1.1 (G), R21.1
/Display/EPD_NEG: C24.2, D3.2 (A), D4.1 (K)
/Display/EPD_RESE: J2.3, Q1.2 (S), R22.1
/Display/EPD_SW: C24.1, D2.2 (A), L3.2, Q1.3 (D)
/Display/EPD_VCOM: C32.1, J2.24
/Display/EPD_VDD: C27.1, J2.18
/Display/EPD_VGH: C29.1, D2.1 (K), J2.21
/Display/EPD_VGL: C31.1, D4.2 (A), J2.23
/Display/EPD_VSH1: C28.1, J2.20
/Display/EPD_VSH2: C25.1, J2.5
/Display/EPD_VSL: C30.1, J2.22
EPD_BUSY: J2.9; also elsewhere on the board
EPD_CS: J2.12; also elsewhere on the board
EPD_DC: J2.11; also elsewhere on the board
EPD_MOSI: J2.14; also elsewhere on the board
EPD_RST: J2.10; also elsewhere on the board
EPD_SCK: J2.13; also elsewhere on the board
GND: C23.2, C25.2, C26.2, C27.2, C28.2, C29.2, C30.2, C31.2, C32.2, C33.2, D3.1 (K), J2.8, J2.17, J3.1, R21.2, R22.2; also elsewhere on the board
I2C_SCL: J3.6; also elsewhere on the board
I2C_SDA: J3.5; also elsewhere on the board
TP_INT: J3.4, R24.2; also elsewhere on the board
TP_RST: J3.3, R23.2; also elsewhere on the board

Notes on the sheet:
E-paper GDEY037T03 (UC8253), 24-pin FPC: the reference circuit in the GDEY037T03 spec
(25.01.08, p. 35), 0.47 R sense for UC driver ICs. BS1 low = 4-wire SPI
Touch FT6336U, 6-pin FPC (Good
Display TP037-S02: 1 GND, 2
VDD, 3 RST, 4 INT, 5 SDA, 6
SCL), I2C address 0x38

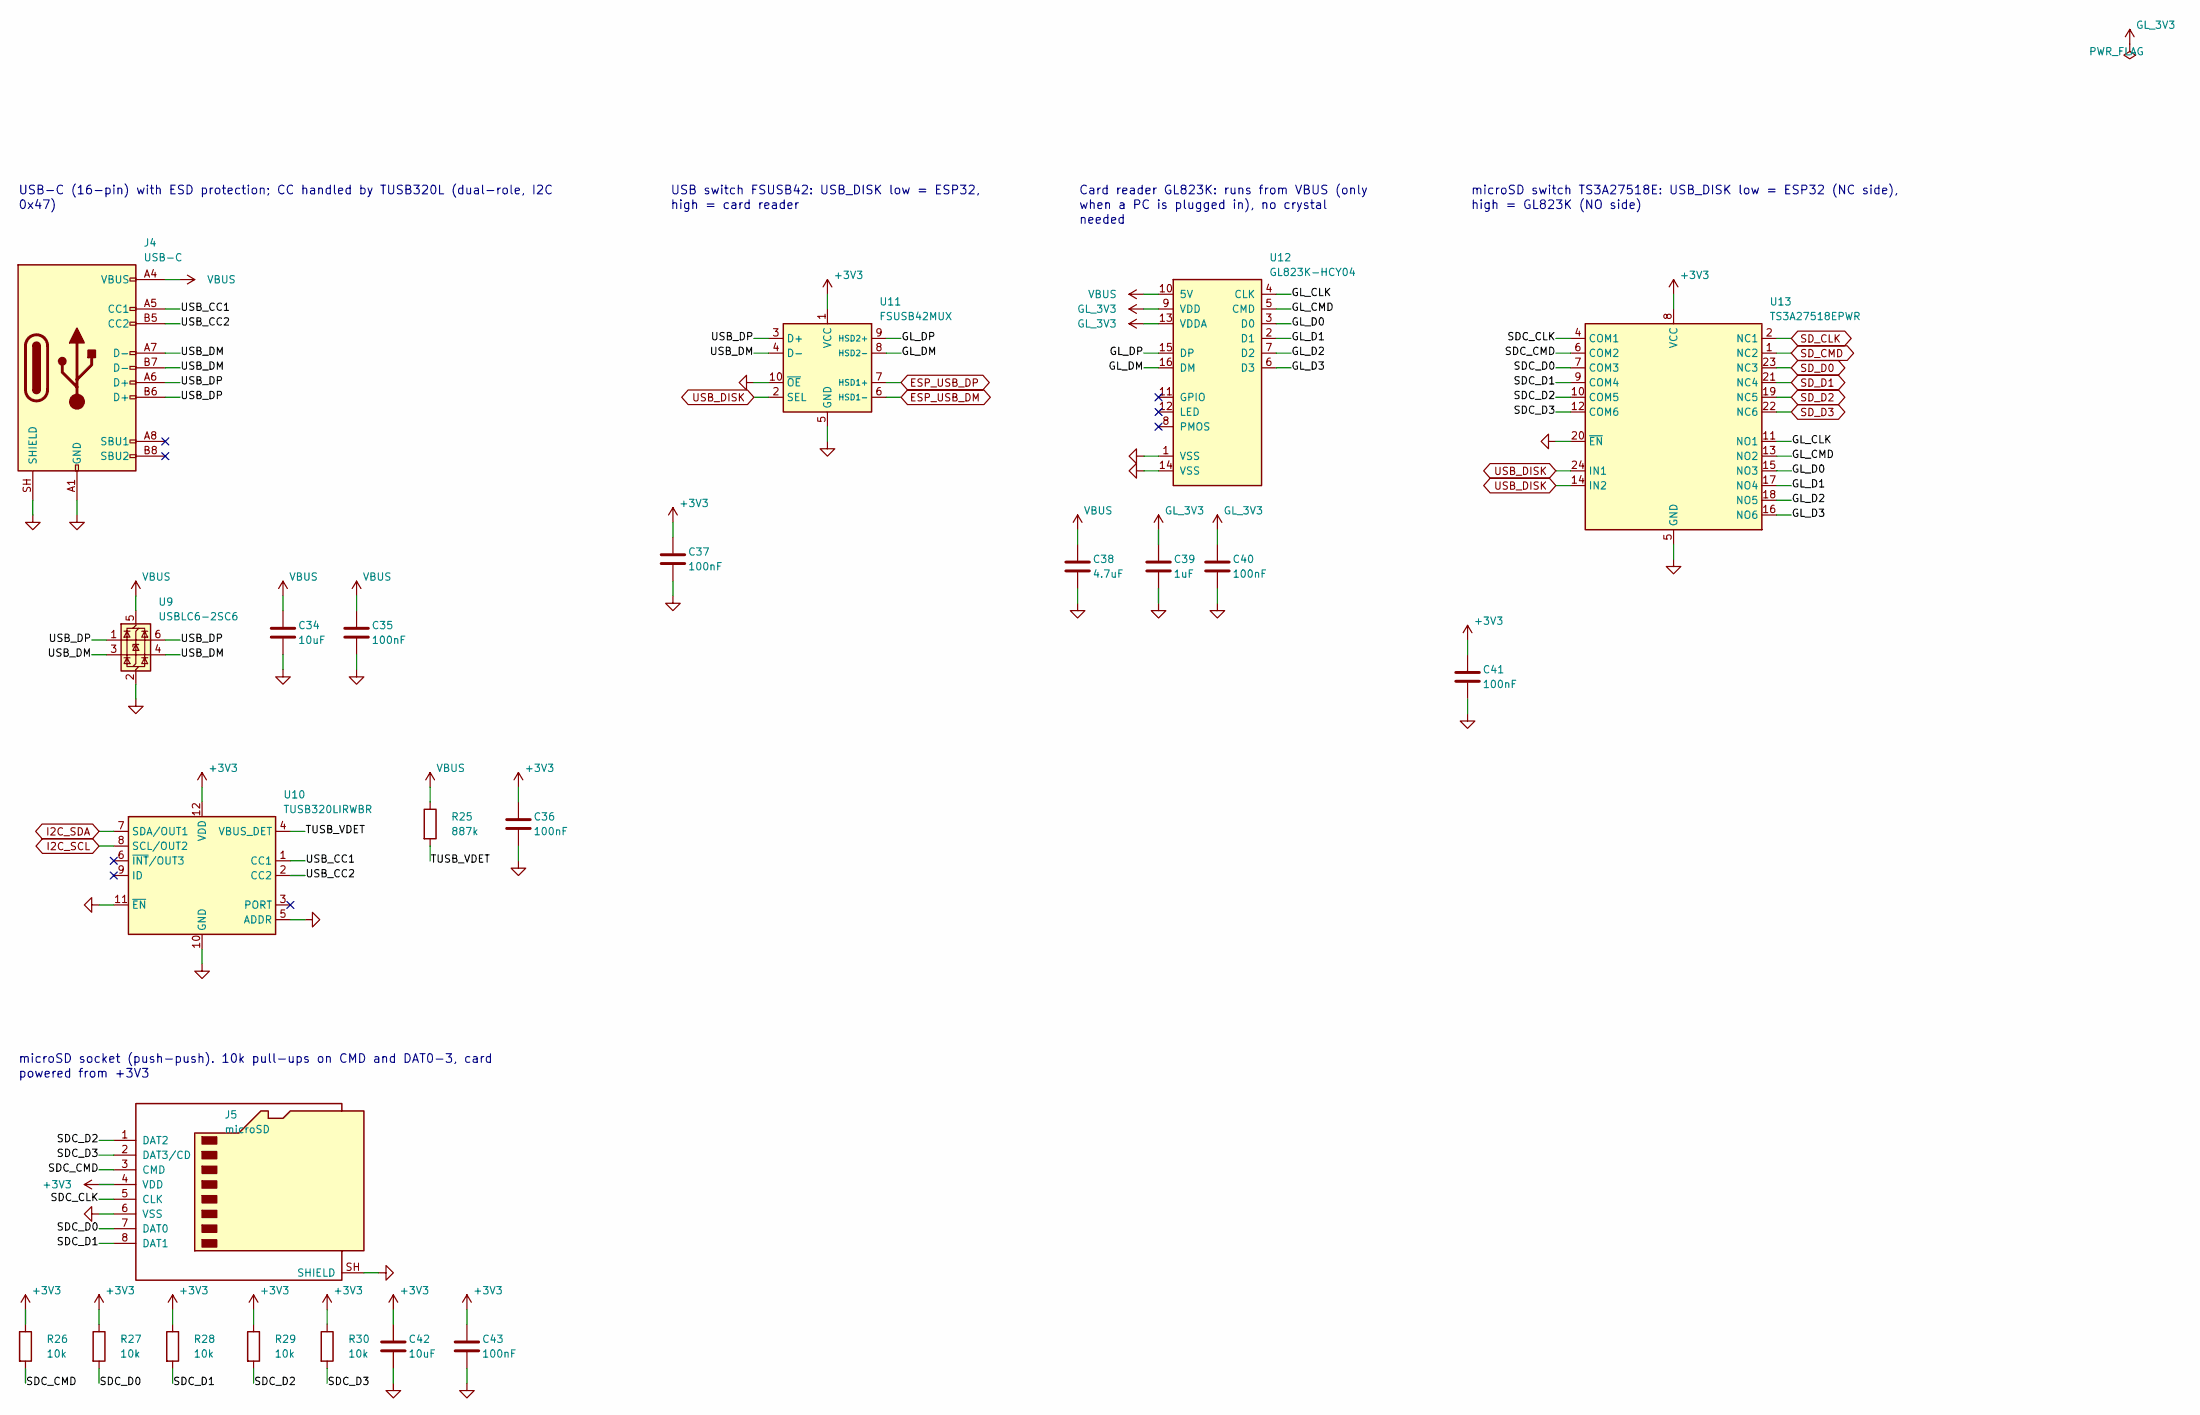
[picture p46: schematic usb_storage.kicad_sch]

Parts:
C34, C42: 10uF; C_0805_2012Metric; LCSC C15850
C35, C36, C37, C40, C41, C43: 100nF; C_0402_1005Metric; LCSC C1525
C38: 4.7uF; C_0603_1608Metric; LCSC C19666
C39: 1uF; C_0402_1005Metric; LCSC C52923
J4: USB-C; USB_C_Receptacle_HRO_TYPE-C-31-M-12; LCSC C165948
J5: microSD; microSD_TF-01A; LCSC C91145
R25: 887k; R_0402_1005Metric; LCSC C423127
R26, R27, R28, R29, R30: 10k; R_0402_1005Metric; LCSC C25744
U9: USBLC6-2SC6; SOT-23-6; LCSC C7519
U10: TUSB320LIRWBR; Texas_X2QFN-12_1.6x1.6mm_P0.4mm; LCSC C2836598
U11: FSUSB42MUX; MSOP-10_3x3mm_P0.5mm; LCSC C11355
U12: GL823K-HCY04; SSOP-16_3.9x4.9mm_P0.635mm; LCSC C284879
U13: TS3A27518EPWR; TSSOP-24_4.4x7.8mm_P0.65mm; LCSC C443721

Connections:
+3V3: C36.1, C37.1, C41.1, C42.1, C43.1, J5.4 (VDD), R26.1, R27.1, R28.1, R29.1, R30.1, U10.12 (VDD), U11.1 (VCC), U13.8 (VCC); also elsewhere on the board
/USB and storage/GL_CLK: U12.4 (CLK), U13.11 (NO1)
/USB and storage/GL_CMD: U12.5 (CMD), U13.13 (NO2)
/USB and storage/GL_D0: U12.3 (D0), U13.15 (NO3)
/USB and storage/GL_D1: U12.2 (D1), U13.17 (NO4)
/USB and storage/GL_D2: U12.7 (D2), U13.18 (NO5)
/USB and storage/GL_D3: U12.6 (D3), U13.16 (NO6)
/USB and storage/GL_DM: U11.8 (HSD2-), U12.16 (DM)
/USB and storage/GL_DP: U11.9 (HSD2+), U12.15 (DP)
/USB and storage/SDC_CLK: J5.5 (CLK), U13.4 (COM1)
/USB and storage/SDC_CMD: J5.3 (CMD), R26.2, U13.6 (COM2)
/USB and storage/SDC_D0: J5.7 (DAT0), R27.2, U13.7 (COM3)
/USB and storage/SDC_D1: J5.8 (DAT1), R28.2, U13.9 (COM4)
/USB and storage/SDC_D2: J5.1 (DAT2), R29.2, U13.10 (COM5)
/USB and storage/SDC_D3: J5.2 (DAT3/CD), R30.2, U13.12 (COM6)
/USB and storage/TUSB_VDET: R25.2, U10.4 (VBUS_DET)
/USB and storage/USB_CC1: J4.A5 (CC1), U10.1 (CC1)
/USB and storage/USB_CC2: J4.B5 (CC2), U10.2 (CC2)
/USB and storage/USB_DM: J4.A7 (D-), J4.B7 (D-), U9.3 (I/O2), U9.4 (I/O2), U11.4 (D-)
/USB and storage/USB_DP: J4.A6 (D+), J4.B6 (D+), U9.1 (I/O1), U9.6 (I/O1), U11.3 (D+)
ESP_USB_DM: U11.6 (HSD1-); also elsewhere on the board
ESP_USB_DP: U11.7 (HSD1+); also elsewhere on the board
GL_3V3: C39.1, C40.1, U12.9 (VDD), U12.13 (VDDA)
GND: C34.2, C35.2, C36.2, C37.2, C38.2, C39.2, C40.2, C41.2, C42.2, C43.2, J4.A1 (GND), J4.A12 (GND), J4.B1 (GND), J4.B12 (GND), J4.SH (SHIELD), J5.6 (VSS), J5.SH (SHIELD), U9.2 (GND), U10.5 (ADDR), U10.10 (GND), U10.11 (~EN), U11.5 (GND), U11.10 (~OE), U12.1 (VSS), U12.14 (VSS), U13.5 (GND), U13.20 (~EN); also elsewhere on the board
I2C_SCL: U10.8 (SCL/OUT2); also elsewhere on the board
I2C_SDA: U10.7 (SDA/OUT1); also elsewhere on the board
SD_CLK: U13.2 (NC1); also elsewhere on the board
SD_CMD: U13.1 (NC2); also elsewhere on the board
SD_D0: U13.23 (NC3); also elsewhere on the board
SD_D1: U13.21 (NC4); also elsewhere on the board
SD_D2: U13.19 (NC5); also elsewhere on the board
SD_D3: U13.22 (NC6); also elsewhere on the board
USB_DISK: U11.2 (SEL), U13.14 (IN2), U13.24 (IN1); also elsewhere on the board
VBUS: C34.1, C35.1, C38.1, J4.A4 (VBUS), J4.A9 (VBUS), J4.B4 (VBUS), J4.B9 (VBUS), R25.1, U9.5 (VBUS), U12.10 (5V); also elsewhere on the board

Notes on the sheet:
USB-C (16-pin) with ESD protection; CC handled by TUSB320L (dual-role, I2C
0x47)
USB switch FSUSB42: USB_DISK low = ESP32,
high = card reader
Card reader GL823K: runs from VBUS (only
when a PC is plugged in), no crystal
needed
microSD switch TS3A27518E: USB_DISK low = ESP32 (NC side),
high = GL823K (NO side)
microSD socket (push-push). 10k pull-ups on CMD and DAT0-3, card
powered from +3V3
