HedgehogsGX/e-ink-dap/hardware/dap.kicad_pcb

## KiCad design hardware/dap.kicad_pcb (continued)

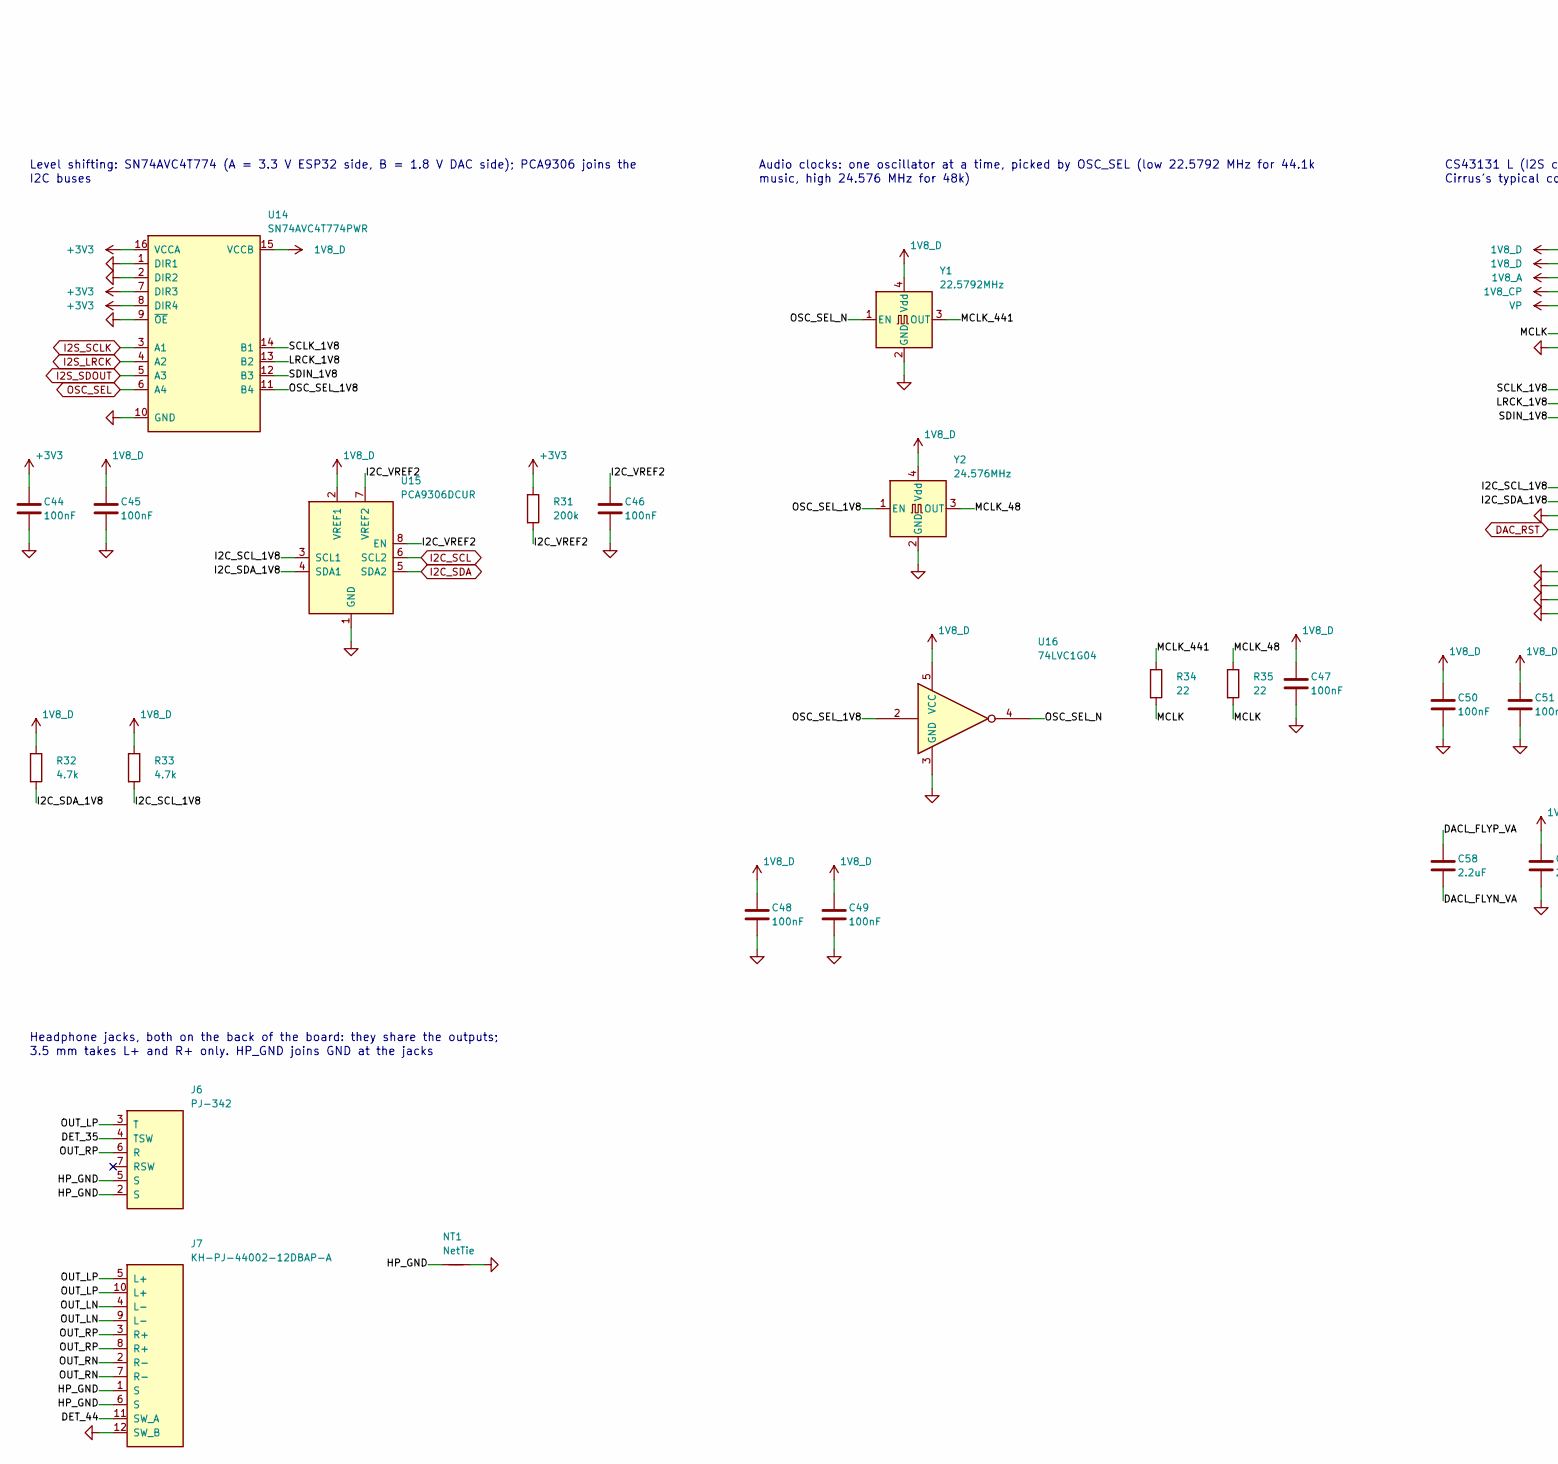
[picture p47: schematic audio.kicad_sch, part in row 1, column 1]

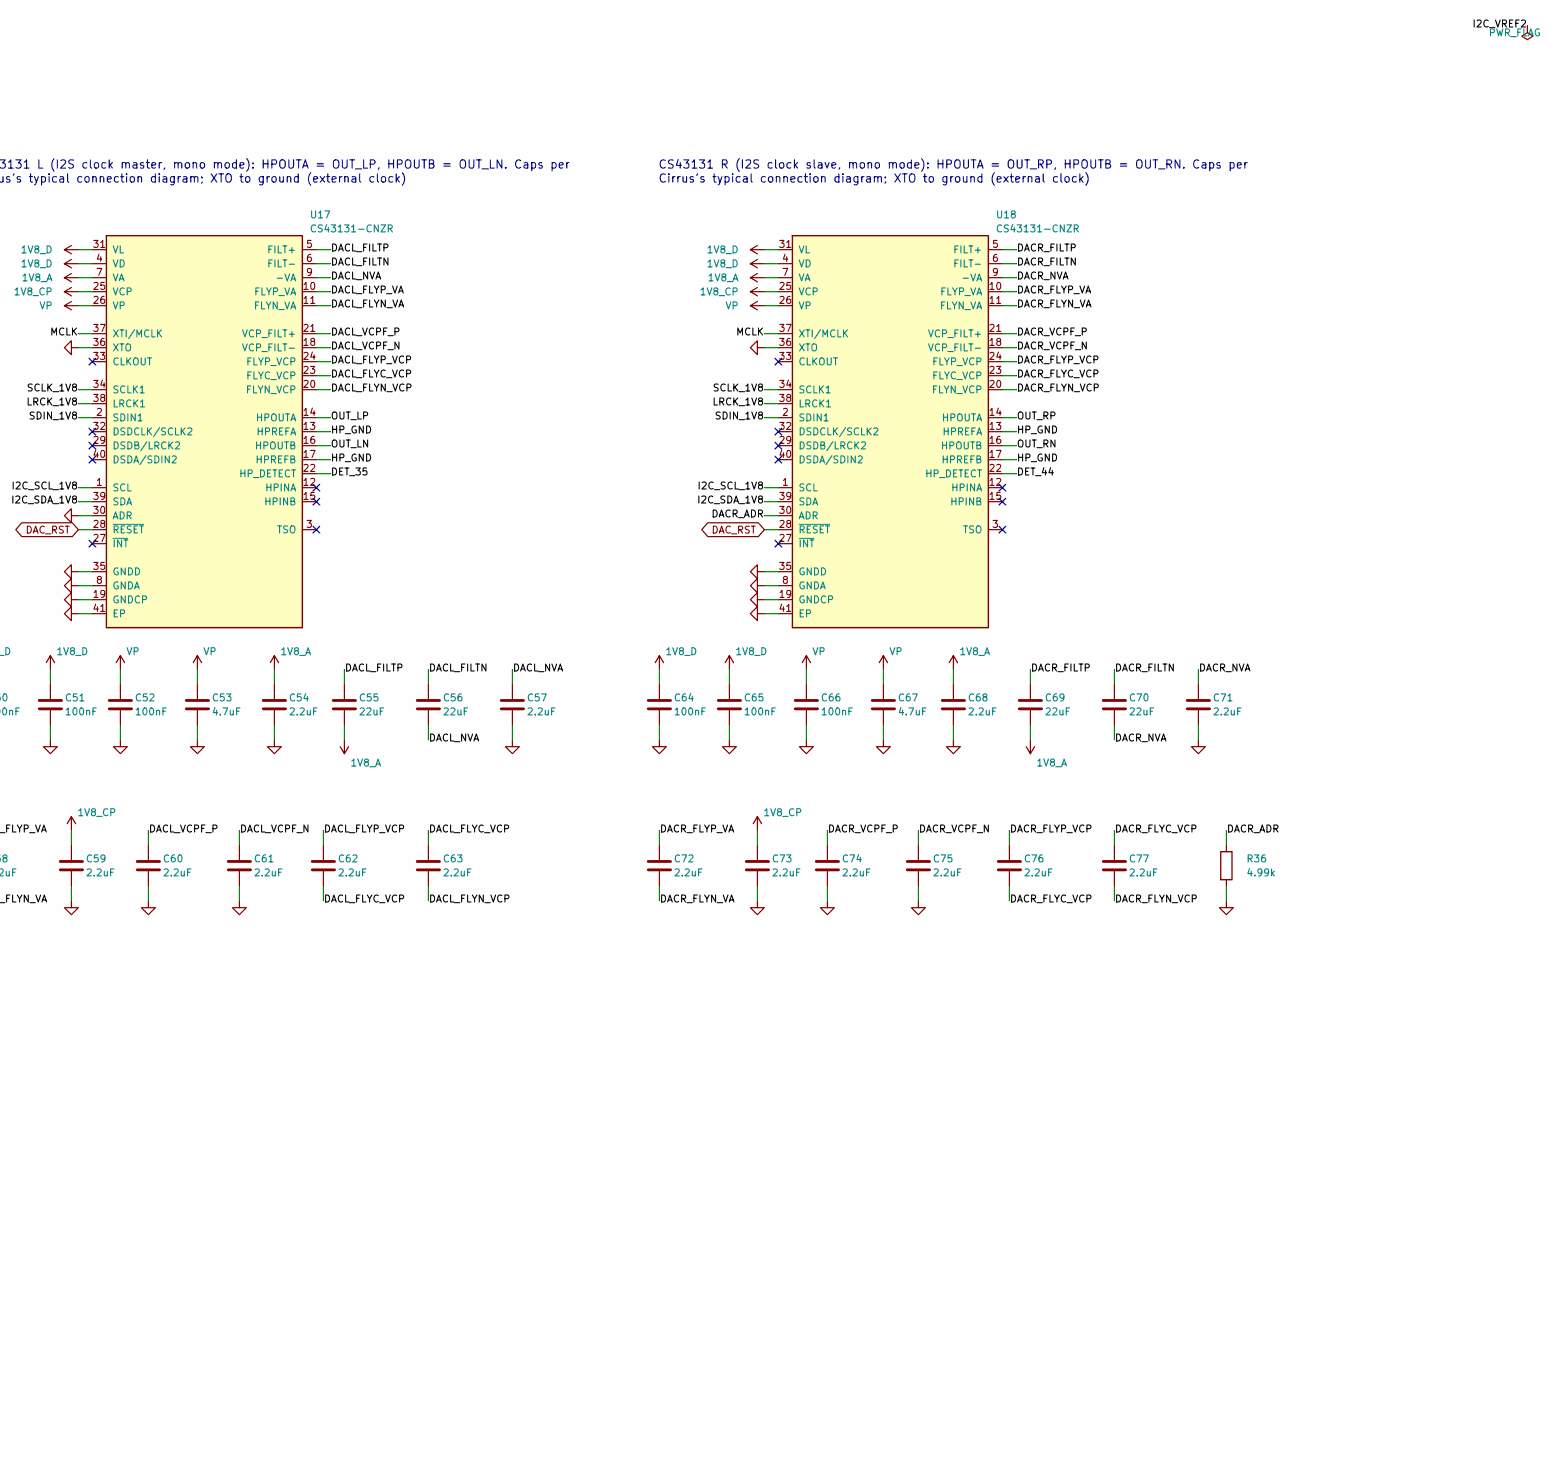
[picture p48: schematic audio.kicad_sch, part in row 1, column 2]

Parts:
C44, C45, C46, C47, C48, C49, C50, C51, C52, C64, C65, C66: 100nF; C_0402_1005Metric; LCSC C1525
C53, C67: 4.7uF; C_0603_1608Metric; LCSC C19666
C54, C57, C58, C59, C60, C61, C62, C63, C68, C71, C72, C73, C74, C75, C76, C77: 2.2uF; C_0603_1608Metric; LCSC C23630
C55, C56, C69, C70: 22uF; C_0805_2012Metric; LCSC C45783
J6: PJ-342; Jack_3.5mm_PJ-342; LCSC C668606
J7: KH-PJ-44002-12DBAP-A; Jack_4.4mm_KH-PJ-44002-12DBAP-A; LCSC C42396781
NT1: NetTie; NetTie-2_SMD_Pad0.5mm
R31: 200k; R_0402_1005Metric; LCSC C25764
R32, R33: 4.7k; R_0402_1005Metric; LCSC C25900
R34, R35: 22; R_0402_1005Metric; LCSC C25092
R36: 4.99k; R_0402_1005Metric; LCSC C25903
U14: SN74AVC4T774PWR; TSSOP-16_4.4x5mm_P0.65mm; LCSC C129363
U15: PCA9306DCUR; VSSOP-8_2.3x2mm_P0.5mm; LCSC C33196
U16: 74LVC1G04; SOT-23-5; LCSC C33962550
U17, U18: CS43131-CNZR; QFN-40-1EP_5x5mm_P0.4mm_EP3.6x3.6mm_ThermalVias; LCSC C965907
Y1: 22.5792MHz; Oscillator_SMD_Abracon_ASE-4Pin_3.2x2.5mm; LCSC C2901572
Y2: 24.576MHz; Oscillator_SMD_Abracon_ASE-4Pin_3.2x2.5mm; LCSC C2901574

Connections:
1V8_A: C54.1, C55.2, C68.1, C69.2, U17.7 (VA), U18.7 (VA); also elsewhere on the board
1V8_CP: C59.1, C73.1, U17.25 (VCP), U18.25 (VCP); also elsewhere on the board
1V8_D: C45.1, C47.1, C48.1, C49.1, C50.1, C51.1, C64.1, C65.1, R32.1, R33.1, U14.15 (VCCB), U15.2 (VREF1), U16.5 (VCC), U17.4 (VD), U17.31 (VL), U18.4 (VD), U18.31 (VL), Y1.4 (Vdd), Y2.4 (Vdd); also elsewhere on the board
+3V3: C44.1, R31.1, U14.7 (DIR3), U14.8 (DIR4), U14.16 (VCCA); also elsewhere on the board
/Audio/DACL_FILTN: C56.1, U17.6 (FILT-)
/Audio/DACL_FILTP: C55.1, U17.5 (FILT+)
/Audio/DACL_FLYC_VCP: C62.2, C63.1, U17.23 (FLYC_VCP)
/Audio/DACL_FLYN_VA: C58.2, U17.11 (FLYN_VA)
/Audio/DACL_FLYN_VCP: C63.2, U17.20 (FLYN_VCP)
/Audio/DACL_FLYP_VA: C58.1, U17.10 (FLYP_VA)
/Audio/DACL_FLYP_VCP: C62.1, U17.24 (FLYP_VCP)
/Audio/DACL_NVA: C56.2, C57.1, U17.9 (-VA)
/Audio/DACL_VCPF_N: C61.1, U17.18 (VCP_FILT-)
/Audio/DACL_VCPF_P: C60.1, U17.21 (VCP_FILT+)
/Audio/DACR_ADR: R36.1, U18.30 (ADR)
/Audio/DACR_FILTN: C70.1, U18.6 (FILT-)
/Audio/DACR_FILTP: C69.1, U18.5 (FILT+)
/Audio/DACR_FLYC_VCP: C76.2, C77.1, U18.23 (FLYC_VCP)
/Audio/DACR_FLYN_VA: C72.2, U18.11 (FLYN_VA)
/Audio/DACR_FLYN_VCP: C77.2, U18.20 (FLYN_VCP)
/Audio/DACR_FLYP_VA: C72.1, U18.10 (FLYP_VA)
/Audio/DACR_FLYP_VCP: C76.1, U18.24 (FLYP_VCP)
/Audio/DACR_NVA: C70.2, C71.1, U18.9 (-VA)
/Audio/DACR_VCPF_N: C75.1, U18.18 (VCP_FILT-)
/Audio/DACR_VCPF_P: C74.1, U18.21 (VCP_FILT+)
/Audio/DET_35: J6.4 (TSW), U17.22 (HP_DETECT)
/Audio/DET_44: J7.11 (SW_A), U18.22 (HP_DETECT)
/Audio/HP_GND: J6.2 (S), J6.5 (S), J7.1 (S), J7.6 (S), NT1.1, U17.13 (HPREFA), U17.17 (HPREFB), U18.13 (HPREFA), U18.17 (HPREFB)
/Audio/I2C_SCL_1V8: R33.2, U15.3 (SCL1), U17.1 (SCL), U18.1 (SCL)
/Audio/I2C_SDA_1V8: R32.2, U15.4 (SDA1), U17.39 (SDA), U18.39 (SDA)
/Audio/I2C_VREF2: C46.1, R31.2, U15.7 (VREF2), U15.8 (EN)
/Audio/LRCK_1V8: U14.13 (B2), U17.38 (LRCK1), U18.38 (LRCK1)
/Audio/MCLK: R34.2, R35.2, U17.37 (XTI/MCLK), U18.37 (XTI/MCLK)
/Audio/MCLK_48: R35.1, Y2.3 (OUT)
/Audio/MCLK_441: R34.1, Y1.3 (OUT)
/Audio/OSC_SEL_1V8: U14.11 (B4), U16.2, Y2.1 (EN)
/Audio/OSC_SEL_N: U16.4, Y1.1 (EN)
/Audio/OUT_LN: J7.4 (L-), J7.9 (L-), U17.16 (HPOUTB)
/Audio/OUT_LP: J6.3 (T), J7.5 (L+), J7.10 (L+), U17.14 (HPOUTA)
/Audio/OUT_RN: J7.2 (R-), J7.7 (R-), U18.16 (HPOUTB)
/Audio/OUT_RP: J6.6 (R), J7.3 (R+), J7.8 (R+), U18.14 (HPOUTA)
/Audio/SCLK_1V8: U14.14 (B1), U17.34 (SCLK1), U18.34 (SCLK1)
/Audio/SDIN_1V8: U14.12 (B3), U17.2 (SDIN1), U18.2 (SDIN1)
DAC_RST: U17.28 (~RESET), U18.28 (~RESET); also elsewhere on the board
GND: C44.2, C45.2, C46.2, C47.2, C48.2, C49.2, C50.2, C51.2, C52.2, C53.2, C54.2, C57.2, C59.2, C60.2, C61.2, C64.2, C65.2, C66.2, C67.2, C68.2, C71.2, C73.2, C74.2, C75.2, J7.12 (SW_B), NT1.2, R36.2, U14.1 (DIR1), U14.2 (DIR2), U14.9 (~OE), U14.10 (GND), U15.1 (GND), U16.3 (GND), U17.8 (GNDA), U17.19 (GNDCP), U17.30 (ADR), U17.35 (GNDD), U17.36 (XTO), U17.41 (EP), U18.8 (GNDA), U18.19 (GNDCP), U18.35 (GNDD), U18.36 (XTO), U18.41 (EP), Y1.2 (GND), Y2.2 (GND); also elsewhere on the board
I2C_SCL: U15.6 (SCL2); also elsewhere on the board
I2C_SDA: U15.5 (SDA2); also elsewhere on the board
I2S_LRCK: U14.4 (A2); also elsewhere on the board
I2S_SCLK: U14.3 (A1); also elsewhere on the board
I2S_SDOUT: U14.5 (A3); also elsewhere on the board
OSC_SEL: U14.6 (A4); also elsewhere on the board
VP: C52.1, C53.1, C66.1, C67.1, U17.26 (VP), U18.26 (VP); also elsewhere on the board

Notes on the sheet:
Level shifting: SN74AVC4T774 (A = 3.3 V ESP32 side, B = 1.8 V DAC side); PCA9306 joins the
I2C buses
Audio clocks: one oscillator at a time, picked by OSC_SEL (low 22.5792 MHz for 44.1k
music, high 24.576 MHz for 48k)
CS43131 L (I2S clock master, mono mode): HPOUTA = OUT_LP, HPOUTB = OUT_LN. Caps per
Cirrus's typical connection diagram; XTO to ground (external clock)
CS43131 R (I2S clock slave, mono mode): HPOUTA = OUT_RP, HPOUTB = OUT_RN. Caps per
Headphone jacks, both on the back of the board: they share the outputs;
3.5 mm takes L+ and R+ only. HP_GND joins GND at the jacks

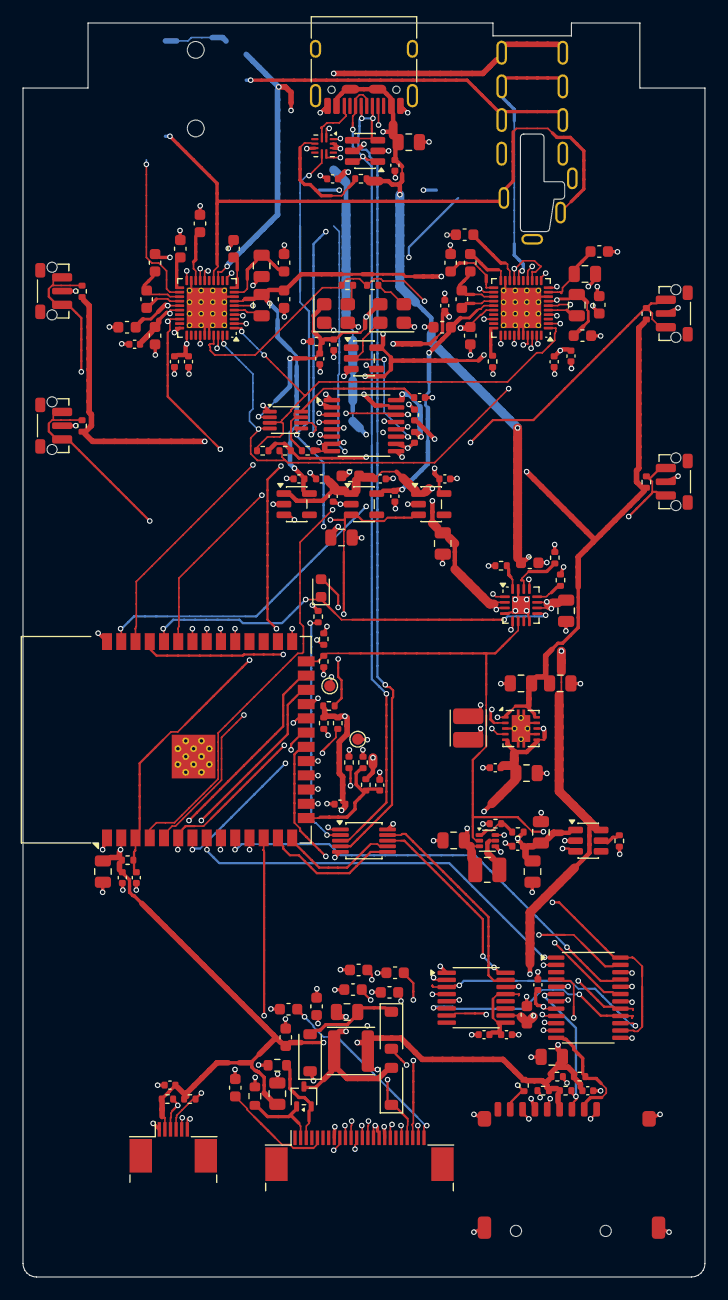
[picture p49: board dap.kicad_pcb from above]

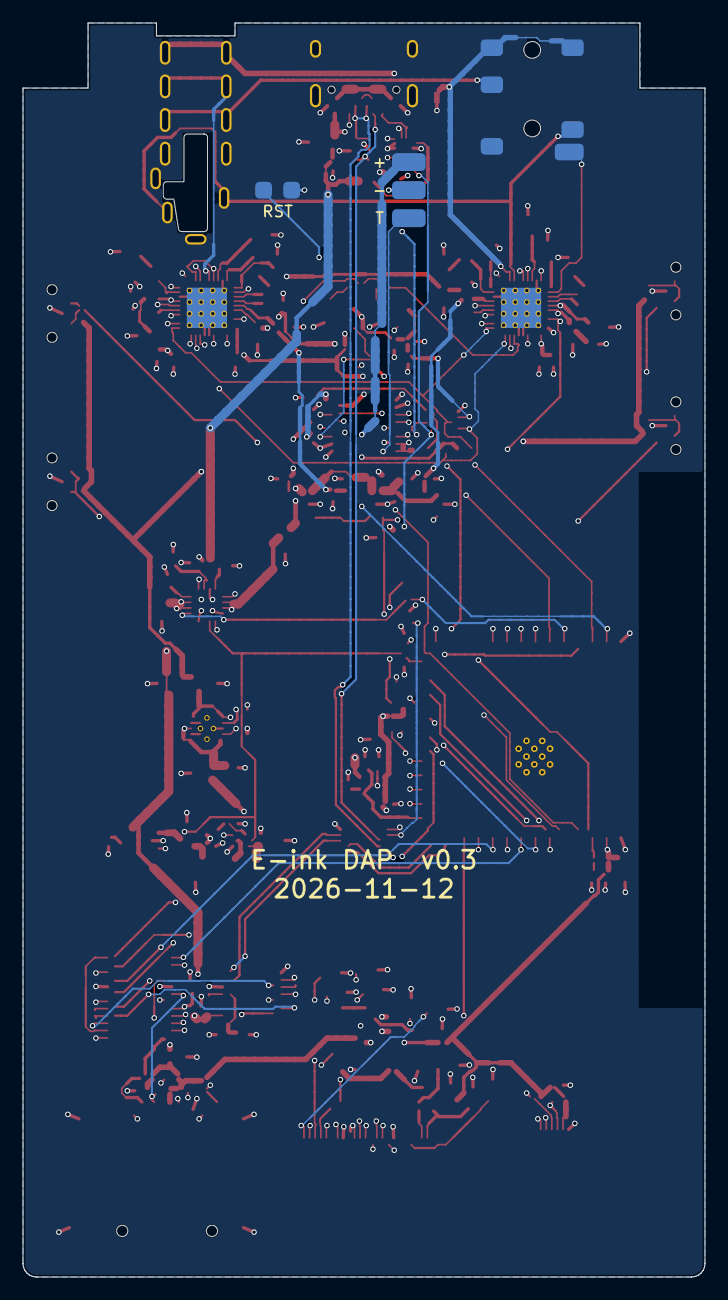
[picture p50: board dap.kicad_pcb from below]

Board: 6 copper layers, 60.8 x 111.8 mm, 157 parts (4 on the bottom side), 124 nets.
