HedgehogsGX/e-ink-dap/src/decode_bench/dr_impl.c

// Single compilation unit for the header-only dr_libs decoders.
#define DR_FLAC_IMPLEMENTATION
#define DR_FLAC_NO_STDIO
#include "dr_flac.h"

#define DR_MP3_IMPLEMENTATION
#define DR_MP3_NO_STDIO
#include "dr_mp3.h"
