HedgehogsGX/e-ink-dap/tools/make_pcb.py

#!/usr/bin/env python3
"""Places the player board's parts (Phase 2, stage 3) on a board shaped like the case's PCB,
routes it, then renders it in 3D. Run with KiCad's own Python, which has pcbnew:

    /Applications/KiCad/KiCad.app/Contents/Frameworks/Python.framework/Versions/3.9/bin/python3 tools/make_pcb.py

Run tools/make_schematic.py first: parts, footprints and nets come from the schematic's
netlist. Pass --no-render to skip the pictures, --no-route to only place the parts (a quick
look at the placement; the board file then has no tracks), --repair to only run the repair
step on the saved board, --freerouting to hand what ours couldn't join to Freerouting.

- hardware/dap.kicad_pcb: 6 layers, 1.2 mm thick, outline and notch from tools/make_case.py,
  every part placed and routed (see Routing). Layers: 1 top (parts), 2 ground, 3 and 4
  signals, 5 ground, 6 bottom
- hardware/dap.pretty: footprints KiCad doesn't have (the two jacks, the microSD socket,
  battery pads, reset pads), from the parts' drawings
- hardware/3d: simple 3D models for those, and for parts whose models KiCad doesn't ship
- hardware/renders/pcb_*.png: top, bottom and angled views (kicad-cli pcb render)
- case/pcb.glb: the board as a 3D model, which tools/make_case.py puts into the case

Placement: connectors, keys and ICs sit where PLACE puts them, in the case's frame (mm,
origin at the board's centre, +y towards the top edge, seen from the screen side). The
small parts of each schematic group are then packed around them, each as close as it can
get to the pins it shares a net with, inside the group's area in AREA; parts between two
pins of their chip first.

Routing: tools/pcb_router.py gives every ground pad a via to the ground planes (layers 2
and 5) and every fine-pitch pin (and every pin of STUB_PARTS) a short escape stub, routes
the nets of FIRST (the DACs' flying capacitors, which a neighbour's via would wall in), gives
each stubbed pin a via of its own (so no track can box it in), then routes the short local
nets, ROUTES, POWER_ROUTES and the other nets in order on the four signal layers (the USB
pairs on the top and bottom only), with trial rip-ups that are undone unless they help.
With --freerouting, anything ours couldn't join goes to Freerouting (FREEROUTING, a Java
program downloaded separately; skipped if it isn't there or nothing is left), with all of
ours as fixed wiring, track widths from NETCLASSES. Layers 3 and 4 are filled with ground
and the bottom layer's free area with 3.3 V, around the tracks. tidy() then removes dead
ends, and whatever KiCad still finds open gets one more try with ours (repair). A full run
takes 10-20 minutes (Freerouting's log, input and output, when it runs:
tools/freerouting.nosync/last-run.*).
"""
import json
import math
import os
import subprocess
import sys
import tempfile

import pcbnew

sys.path.insert(0, os.path.dirname(os.path.abspath(__file__)))
import kicad_sch as K  # noqa: E402
import make_schematic as M  # noqa: E402

ROOT = os.path.dirname(os.path.dirname(os.path.abspath(__file__)))
HW = os.path.join(ROOT, "hardware")
BOARD_FILE = os.path.join(HW, "dap.kicad_pcb")
FP_LIB = os.path.join(HW, "dap.pretty")
MODELS_3D = "/Applications/KiCad/KiCad.app/Contents/SharedSupport/3dmodels"
RENDER = "--no-render" not in sys.argv
ROUTE = "--no-route" not in sys.argv
# Freerouting only when asked for: on this board its fan-out stage adds some 1,000 stubs and
# vias of its own and it still left the connections ours had left (2026-11-11, twice)
FREEROUTE = "--freerouting" in sys.argv

# ---- Board shape and heights, from tools/make_case.py (keep in step with it)
W, L, WALL, GAP, R_INNER, PCB_T = 65.0, 116.0, 1.8, 0.3, 1.5, 1.2
AA_L, AA_TOP, PANEL_L = 81.54, 2.98, 92.99
X_35, X_USB, X_44 = -15.0, 0.0, 15.0
BOSS_R = 2.75
SD_X = 18.5
KEYS = {"SW3": (-1, 32.0), "SW4": (-1, 20.0), "SW2": (1, 30.0), "SW1": (1, 15.0)}  # Vol+, Vol-, Power, Play
FLANGE_T = 0.8

IX, IY = W / 2 - WALL, L / 2 - WALL   # inside of the walls
HX, HY = IX - GAP, IY - GAP           # board half-size: 60.8 x 111.8 mm
R_CORNER = R_INNER - GAP
BOSS_X, BOSS_Y = IX - BOSS_R - GAP, IY - BOSS_R - GAP
PANEL_BOTTOM = AA_L / 2 + AA_TOP - PANEL_L
# Both headphone jacks hang under the board, noses through the top wall, each ending 0.1-0.2 mm
# inside the case's face. The 4.4 mm jack's 2.8 mm nose needs its front face 0.9 mm in from
# the board edge: it overhangs the edge of a shallow notch by 0.25 mm, as its drawing asks.
FACE_35 = HY                          # PJ-342 front face (2.0 mm nose)
FACE_44 = L / 2 - 0.2 - 2.8           # KH-PJ-44002 front face (2.8 mm nose)
NOTCHES = [(X_44 - 3.5, X_44 + 3.5, FACE_44 - 0.25)]   # (x0, x1, bottom); open to the top edge
BOSS_NOTCH = (BOSS_X - BOSS_R - 0.3, BOSS_Y - BOSS_R - 0.3)   # corner cut-outs: |x| >= , y >=

OX, OY = 148.5, 105.0                 # board centre on the A4 sheet

# ---- Where things go. (x, y, rotation in degrees counter-clockwise, side)
KEY_X = IX - FLANGE_T - 0.05 - 2.04   # plunger tip at the key; 2.04 = tip to switch origin
PLACE = {
    "J6": (X_35, FACE_35, 0, "B"), "J7": (X_44, FACE_44, 0, "B"),   # headphone jacks, under the board
    "J4": (X_USB, IY - 3.65, 180),                     # USB-C front 0.3 mm past the board edge
    "J1": (-4.0, 41.0, 0, "B"),                        # battery wires, back side, past the battery's end
    "JP1": (7.7, 41.0, 0, "B"),                        # reset pads, back side, between the battery pads and
                                                       # the 4.4 mm jack: reached with the back cover off
    "J2": (-0.4, PANEL_BOTTOM + 0.5 + 3.65, 0),        # e-paper FPC: mouth just inside the panel's edge,
                                                       # centred on the ribbon (0.4 mm left of the panel's centre)
    "J3": (-17.0, PANEL_BOTTOM + 0.5 + 4.4, 0),        # touch FPC
    "J5": (SD_X, -HY + 9.675, 0),                      # microSD, card mouth at the bottom edge
    "U17": (-14.0, 30.5, 180), "U18": (14.0, 30.5, 180),   # CS43131 L / R, outputs facing the jacks
    # Between the two DACs, everything both of them use: the clocks, then the I2S and I2C
    # level shifters, then the three 1.8 V regulators, so each bus and rail fans out both ways
    "Y1": (-2.5, 30.0, 0), "Y2": (2.5, 30.0, 0), "U16": (0.0, 26.0, 0),
    "U14": (0.0, 20.0, 0), "U15": (-7.0, 20.5, 0),
    "U3": (-6.0, 13.0, 0), "U4": (0.0, 13.0, 0), "U5": (6.0, 13.0, 0),
    "U8": (-HX + 12.75, -8.0, 90),                     # ESP32 module, antenna at the left edge;
                                                       # its keep-out strip ends below the Vol- key
    "U1": (14.0, 4.0, 0), "U2": (14.0, -7.0, 0), "U6": (11.0, -17.0, 0), "U7": (20.0, -17.0, 0),
    "U11": (0.0, -17.0, 0),
    "U12": (10.0, -31.0, 0), "U13": (20.0, -31.0, 0),
}
for ref, (side, y) in KEYS.items():
    PLACE[ref] = (side * KEY_X, y, 90 * side)
# Small parts in the column right of the ESP32, kept where the 2026-10-31 board had them. The
# ESP32's own capacitors left this column on 2026-11-11 (now at its pin 2); packed afresh, the
# I2C pull-ups landed against the module's pins and two connections could not be routed
PLACE.update({
    "R18": (-3.585, -6.525, 270), "R19": (-2.335, -6.525, 270),   # I2C pull-ups
    "R20": (-3.125, -4.985, 0), "TP2": (-0.555, -7.9537, 180),    # charge LED resistor, ground test pad
    "R9": (-1.335, -10.025, 90), "R17": (-0.085, -10.025, 90),    # AUDIO_EN pull-down, battery divider
    "R16": (0.165, -12.025, 270), "C22": (1.405, -12.045, 90),
})

# Area each schematic group's small parts are packed into (x0, y0, x1, y1), by the group's
# first part; groups not listed pack within 12 mm of their pins. Packed in this order.
AREA = [
    ("J6", (-10.5, 44.0, -5.5, 50.0)),                 # net tie by the jacks' ground pins
    ("SW1", None),                                     # key pull-ups, each beside its key
    ("U17", (-25.4, 17.0, -5.2, 42.0)),
    ("U18", (5.2, 17.0, 25.4, 38.5)),
    ("Y1", (-5.2, 23.5, 5.2, 36.0)),
    ("J4", (-8.0, 34.0, 8.0, 47.0)),
    ("U14", (-10.5, 16.5, 10.5, 23.5)),
    ("U3", (-9.5, 8.5, 9.5, 16.5)),
    ("U8", (-24.3, -24.5, -19.6, -18.0)),              # its capacitors and the EN parts right below pins
                                                       # 2 (3.3 V) and 3 (EN), clear of the antenna keep-out
    ("R8", (-4.6, -13.0, 4.6, 7.5)),
    ("R16", (-4.6, -13.0, 4.6, 7.5)),
    ("U1", (5.0, -1.5, 27.0, 11.5)),
    ("U2", (5.0, -12.5, 27.0, -1.5)),
    ("U6", (5.0, -24.0, 27.0, -12.5)),
    ("U11", (-4.6, -21.0, 4.6, -13.0)),
    ("J3", (-26.0, -41.3, -10.0, -35.0)),
    ("J2", (-26.0, -42.3, 4.5, -21.0)),
    ("U12", (4.5, -39.8, 27.0, -23.0)),
    ("U13", (4.5, -39.8, 27.0, -23.0)),
    ("J5", (4.5, -39.8, 27.0, -23.0)),
]
TARGETS = {"R8": ["U8"], "R16": ["U8"],   # groups with no IC of their own sit by the ESP32
           # each key's pull-up by its own key. Aimed at the group's placed parts, the Vol keys'
           # pull-ups went for the other pull-ups' +3V3 pads too and landed mid-board (until 2026-11-12)
           "SW1": ["SW1", "SW2", "SW3", "SW4"]}
# Strips beside a chip kept free of small parts, where its routed pins leave: (x0, y0, x1, y1)
# from the chip's centre. CS43131 (turned 180 degrees): headphone pins on top, I2S and clock
# below. Its sides are left to the charge-pump and filter capacitors.
DAC_TOP, DAC_BOTTOM = (-0.85, 2.9, 1.4, 6.0), (-1.0, -6.0, 2.4, -2.9)
# and in front of the charge-pump pins 22-26, where five pins' tracks and vias leave side by side
DAC_PUMP = (-4.4, -0.5, -2.9, 1.3)
KEEP_CLEAR = {ref: [DAC_TOP, DAC_BOTTOM, DAC_PUMP] for ref in ("U17", "U18")}
KEEP_CLEAR["J2"] = [(-2.2, 2.6, 1.2, 7.0)]   # e-paper FPC: in front of its signal pins 9-14, towards the ESP32
STEP = 0.25
FANOUT = 0.8   # small parts keep this far beyond the outline of a chip with 0.5 mm pitch or finer
FANOUT_BY_REF = {"U17": 0.6, "U18": 0.6}   # the DACs: capacitors close to their pins, the
                                           # signal and supply pins' own vias between them

# ---- Routing, in this order: (nets, settings). USB first, since its socket pins leave no
# room to spare. Widths in mm; full_width = widened where there is room. A USB pair: the +
# track keeps a 1 mm corridor free, the - track runs beside it 0.4 mm apart (0.2 mm tracks,
# 0.2 mm gap: about 90 ohm over the ground plane 0.1 mm below), on the top and bottom layers
# only, each over its own ground plane (layers 2 and 5).
ROUTING_LAYERS = [pcbnew.F_Cu, pcbnew.In2_Cu, pcbnew.In3_Cu, pcbnew.B_Cu]
OUTER = [pcbnew.F_Cu, pcbnew.B_Cu]
ROUTES = [
    (["USB_DP"], dict(order=["J4:A6"], width=0.2, corridor=1.0, layers=OUTER)),
    (["USB_DM"], dict(order=["J4:A7"], width=0.2, partner="USB_DP", pair_pitch=0.4, layers=OUTER)),
    (["USB_CC1", "USB_CC2"], {}),
    (["GL_DP"], dict(width=0.2, corridor=1.0, layers=OUTER)),
    (["GL_DM"], dict(width=0.2, partner="GL_DP", pair_pitch=0.4, layers=OUTER)),
    (["ESP_USB_DP"], dict(width=0.2, corridor=1.0, layers=OUTER)),
    (["ESP_USB_DM"], dict(width=0.2, partner="ESP_USB_DP", pair_pitch=0.4, layers=OUTER)),
    (["MCLK_441", "MCLK_48", "MCLK"], dict(clearance=0.2)),
    (["OUT_LP"], dict(order=["U17:14"], full_width=0.3, clearance=0.15)),
    (["OUT_RP"], dict(order=["U18:14"], full_width=0.3, clearance=0.15)),
    (["OUT_LN"], dict(order=["U17:16"], full_width=0.3, clearance=0.15)),
    (["OUT_RN"], dict(order=["U18:16"], full_width=0.3, clearance=0.15)),
    (["HP_GND"], dict(order=["NT1:1"], full_width=0.5)),
    (["DET_35", "DET_44"], {}),
    (["SCLK_1V8", "LRCK_1V8", "SDIN_1V8", "I2C_SCL_1V8", "I2C_SDA_1V8", "OSC_SEL_1V8", "OSC_SEL_N"], {}),
    (["I2S_SCLK", "I2S_LRCK", "I2S_SDOUT", "OSC_SEL"], {}),
]
# Power, after the signals: switching nodes first (short, tight loops), then each rail from
# its source. Widths: start, widened where there is room, narrowest allowed in a squeeze.
POWER_ROUTES = [
    (["BB_L1", "BB_L2"], dict(order=["U2"], width=0.4, full_width=0.6, min_width=0.25)),
    (["BST_SW"], dict(order=["U6"], width=0.4, full_width=0.6, min_width=0.25)),
    (["EPD_SW"], dict(order=["L3"], width=0.3, full_width=0.5, min_width=0.2)),
    (["VBAT"], dict(order=["J1"], width=0.4, full_width=0.8, min_width=0.25)),
    (["SYS"], dict(order=["U1"], width=0.4, full_width=0.8, min_width=0.2)),
    (["VBUS"], dict(order=["J4"], width=0.4, full_width=0.8, min_width=0.2)),
    (["5V_BOOST"], dict(order=["U6"], width=0.4, full_width=0.6, min_width=0.2)),
    (["+3V3"], dict(order=["U2"], width=0.3, full_width=0.5, min_width=0.15)),
    (["VP"], dict(order=["FB1"], width=0.3, full_width=0.5, min_width=0.15)),
    (["1V8_A"], dict(order=["U3"], width=0.25, full_width=0.4, min_width=0.15)),
    (["1V8_CP"], dict(order=["U4"], width=0.25, full_width=0.4, min_width=0.15)),
    (["1V8_D"], dict(order=["U5"], width=0.25, full_width=0.4, min_width=0.15)),
    (["GL_3V3"], dict(order=["U12"], width=0.25, full_width=0.4, min_width=0.15)),
]
SWITCHING = ["BB_L1", "BB_L2", "BST_SW", "EPD_SW"]   # no vias of their own on these: short loops
# Routed before any pin gets a via: the CS43131s' charge-pump flying capacitors, pin to capacitor.
# Their pins 23 and 24 sit between two pins that get vias (22 and 25, 0.4 mm away); with the
# vias in first, the 1.8 V pin's via walled FLYP_VCP in at its pin, and the board only finished
# when a later rip-up happened to free it (2026-11-11: at the right DAC it no longer did)
FIRST = ["DACL_FLYP_VCP", "DACR_FLYP_VCP", "DACL_FLYC_VCP", "DACR_FLYC_VCP",
         # and two lines that board v0.3 (2026-11-12) left unrouted when routed in their turn:
         # the 5 V boost's enable (U6 pin 2) and the I2C level shifter's VREF2/EN line to its
         # filter capacitor, 10 mm away (FIRST nets may be local or longer ones)
         "BOOST_EN", "I2C_VREF2"]
LOCAL_PIN_VIAS = True   # the short local nets' pins get vias too, where room is left
# A pin of a longer net that finds no room for its via has its neighbours' vias taken back as
# well, so both leave side by side on the top layer: at the left DAC the 1.8 V pin's via sat
# right in front of the VP pin (2026-11-11)
YIELD_ALL = True
# Parts whose pins all get stubs and vias like a fine-pitch chip's: the FPC connectors, and the
# ESP32 module, where most long lines start
STUB_PARTS = ["J2", "J3", "U8"]
# Every other net is routed too: those whose pins lie within LOCAL mm of each other first of
# all (a chip and its capacitors: the shortest loops matter most and block little), the longer
# ones last. Freerouting gets anything ours couldn't join; its track widths come from these
# KiCad net classes (name, width mm, net name patterns), others 0.15 mm.
LOCAL = 8.0
NETCLASSES = [("Power", 0.3, ["VBAT", "SYS", "VBUS", "5V_BOOST"]),
              ("Supply", 0.2, ["+3V3", "VP", "1V8_A", "1V8_CP", "1V8_D", "GL_3V3"])]
FREEROUTING = os.path.join(ROOT, "tools", "freerouting.nosync", "freerouting-2.5.0.jar")
FREEROUTING_PASSES = 4    # with all our tracks fixed it only has the last few connections to add
FREEROUTING_THREADS = 8                  # for its route optimizer, which runs after the passes
FREEROUTING_TIMEOUT = 3 * 3600           # s
FREEROUTING_LOG = os.path.join(ROOT, "tools", "freerouting.nosync", "last-run.log")   # watch progress here
# Copper: layers 2 and 5 solid ground planes, the top and bottom layers' reference; layers 3
# and 4 filled with ground around their tracks, and the bottom layer's free area with 3.3 V
PLANES = [(pcbnew.In1_Cu, "GND"), (pcbnew.In4_Cu, "GND")]   # in before Freerouting, as planes
FILLS = [(pcbnew.In2_Cu, "GND"), (pcbnew.In3_Cu, "GND"), (pcbnew.B_Cu, "+3V3")]   # after it
USB_NETS = ["USB_DP", "USB_DM", "GL_DP", "GL_DM", "ESP_USB_DP", "ESP_USB_DM"]
# The critical nets: the repair step leaves their tracks as they are
LOCKED_NETS = USB_NETS + ["USB_CC1", "USB_CC2", "MCLK_441", "MCLK_48", "MCLK", "OUT_LP", "OUT_RP", "OUT_LN",
                          "OUT_RN", "HP_GND", "BB_L1", "BB_L2", "BST_SW", "EPD_SW", "GND"]
USB_C_BRIDGE = ("USB_DM", ["J4:B7", "J4:A7"])   # the socket's two D- pins straddle a D+ pin
# The same strips are channels while routing: only these nets may use them
DAC_BUS = ["SCLK_1V8", "LRCK_1V8", "SDIN_1V8", "MCLK", "I2C_SCL_1V8", "I2C_SDA_1V8"]
CHANNELS = [("U17", DAC_TOP, ["OUT_LP", "OUT_LN", "HP_GND"]), ("U18", DAC_TOP, ["OUT_RP", "OUT_RN", "HP_GND"]),
            ("U17", DAC_BOTTOM, DAC_BUS), ("U18", DAC_BOTTOM, DAC_BUS)]

# ---- Footprints KiCad doesn't have, and simple 3D models
METAL, BLACK, GREY, GOLD, BEIGE = (0.58, 0.59, 0.62), (0.07, 0.07, 0.07), (0.45, 0.45, 0.45), \
    (0.85, 0.68, 0.3), (0.55, 0.38, 0.2)
# Footprints whose models KiCad doesn't ship: a model of the same package, or boxes in the
# footprint's frame (x0, x1, y0, y1, z0, z1, colour).
MODEL_SUBST = {
    "Oscillator_SMD_Abracon_ASE-4Pin_3.2x2.5mm": "Crystal.3dshapes/Crystal_SMD_3225-4Pin_3.2x2.5mm.step",
    "Texas_DRC0010J_ThermalVias": "Package_SON.3dshapes/VSON-10-1EP_3x3mm_P0.5mm_EP1.65x2.4mm.step",
    "VQFN-16-1EP_3x3mm_P0.5mm_EP1.6x1.6mm": "Package_DFN_QFN.3dshapes/TQFN-16-1EP_3x3mm_P0.5mm_EP1.6x1.6mm.step",
}
MODEL_BOXES = {
    "USB_C_Receptacle_HRO_TYPE-C-31-M-12": [("box", -4.47, 4.47, -3.65, 3.65, 0, 3.26, METAL),
                                            ("box", -3.6, 3.6, 3.62, 3.66, 0.45, 2.8, BLACK)],
    "SW_Push_1P1T-MP_NO_Horizontal_Alps_SKRTLAE010": [("box", -2.25, 2.25, -1.35, 1.35, 0, 3.3, METAL),
                                                      ("box", -1.0, 1.0, 1.35, 2.04, 1.0, 2.3, BLACK)],
    "Jushuo_AFC07-S24FCA-00_1x24-1MP_P0.50_Horizontal": [("box", -8.8, 8.8, -0.75, 2.6, 0, 2.0, BEIGE),
                                                         ("box", -8.4, 8.4, 2.6, 3.65, 0.3, 2.0, BLACK)],
    "Jushuo_AFC07-S06FCA-00_1x6-1MP_P0.50_Horizontal": [("box", -4.3, 4.3, -0.75, 2.6, 0, 2.0, BEIGE),
                                                       ("box", -3.9, 3.9, 2.6, 3.65, 0.3, 2.0, BLACK)],
    "Texas_X2QFN-12_1.6x1.6mm_P0.4mm": [("box", -0.8, 0.8, -0.8, 0.8, 0, 0.4, BLACK)],
}
BODY_ONLY = {"ESP32-S3-WROOM-1"}   # courtyard also covers the antenna keep-out (a rule area)
COVERS_NOTCH = {"J7"}              # the 4.4 mm jack's face overhangs its notch
THROUGH = {"J6", "J7"}             # back-side parts whose pins or pegs go through: top side kept clear too
# Smallest hole, mm: JLCPCB's 6-layer price covers 0.3 mm and up. KiCad's footprints have 0.2 mm
# thermal vias in their centre pads, which added ¥229 to the 5-board order (2026-10-31)
MIN_HOLE = 0.3

# JLCPCB's 6-layer limits (or near them); KiCad reads them from hardware/dap.kicad_dru
DRC_RULES = """(version 1)
# JLCPCB 6-layer board limits. Written by tools/make_pcb.py.
(rule "clearance" (constraint clearance (min 0.1mm)))
(rule "track width" (constraint track_width (min 0.1mm)))
(rule "hole size" (constraint hole_size (min 0.3mm)))
(rule "hole clearance" (constraint hole_clearance (min 0.2mm)))
(rule "edge clearance" (constraint edge_clearance (min 0.3mm)))
# The 4.4 mm jack's own pads beside its relief cut-out: JLCPCB's minimum for copper at a routed edge
(rule "jack cut-out" (condition "A.memberOfFootprint('J7')") (constraint edge_clearance (min 0.2mm)))
"""


def _meet(a0, a1, b0, b1):
    """Where the line through a0, a1 meets the line through b0, b1 (a1 if they are parallel)."""
    (x1, y1), (x2, y2), (x3, y3), (x4, y4) = a0, a1, b0, b1
    d = (x1 - x2) * (y3 - y4) - (y1 - y2) * (x3 - x4)
    if abs(d) < 1e-12:
        return a1
    t = ((x1 - x3) * (y3 - y4) - (y1 - y3) * (x3 - x4)) / d
    return x1 + t * (x2 - x1), y1 + t * (y2 - y1)


def _area(poly):
    return sum(a[0] * b[1] - b[0] * a[1] for a, b in zip(poly, poly[1:] + poly[:1])) / 2


def grown(poly, d):
    """The polygon moved d mm outwards on every side, corners mitred."""
    sgn = 1 if _area(poly) > 0 else -1
    lines = []
    for (x0, y0), (x1, y1) in zip(poly, poly[1:] + poly[:1]):
        length = math.hypot(x1 - x0, y1 - y0)
        nx, ny = sgn * (y1 - y0) / length, -sgn * (x1 - x0) / length
        lines.append(((x0 + nx * d, y0 + ny * d), (x1 + nx * d, y1 + ny * d)))
    return [_meet(*lines[i - 1], *lines[i]) for i in range(len(lines))]


def rounded(poly, r, steps=6):
    """The polygon with its convex corners rounded to radius r (a router bit can't cut them sharp);
    the concave ones stay sharp."""
    sgn = 1 if _area(poly) > 0 else -1
    out = []
    for i, p in enumerate(poly):
        a, b = poly[i - 1], poly[(i + 1) % len(poly)]
        u = ((p[0] - a[0]) / math.dist(a, p), (p[1] - a[1]) / math.dist(a, p))
        v = ((b[0] - p[0]) / math.dist(p, b), (b[1] - p[1]) / math.dist(p, b))
        if (u[0] * v[1] - u[1] * v[0]) * sgn <= 0:
            out.append(p)
            continue
        half = math.acos(max(-1.0, min(1.0, -(u[0] * v[0] + u[1] * v[1])))) / 2   # half the inside angle
        bis = (v[0] - u[0], v[1] - u[1])
        n = math.hypot(*bis)
        c = (p[0] + bis[0] / n * r / math.sin(half), p[1] + bis[1] / n * r / math.sin(half))
        t0 = (p[0] - u[0] * r / math.tan(half), p[1] - u[1] * r / math.tan(half))
        t1 = (p[0] + v[0] * r / math.tan(half), p[1] + v[1] * r / math.tan(half))
        a0, a1 = math.atan2(t0[1] - c[1], t0[0] - c[0]), math.atan2(t1[1] - c[1], t1[0] - c[0])
        da = (a1 - a0 + math.pi) % (2 * math.pi) - math.pi
        out += [(c[0] + r * math.cos(a0 + da * k / steps), c[1] + r * math.sin(a0 + da * k / steps))
                for k in range(steps + 1)]
    return [(round(x, 4), round(y, 4)) for x, y in out]


# The plug switch's relief cut-out under the 4.4 mm jack, from Kinghelm's drawing ("紫色区域开孔(避位孔)":
# 2.10 mm wide from 9.00 mm, widening to 2.95 mm from the axis between 13.25 and 14.80 mm, then a
# slanted edge to 1.50 mm at the top, 17.70 mm; footprint frame, x positive towards pins 1-5). Two edges
# stay back from the drawing so that pads 11 and 10 keep JLCPCB's 0.2 mm from the cut: the step at 2.89
# (drawn 2.95) and the slant's foot at 1.95 (drawn about 1.99). Until 2026-11-12 the cut-out was about 0.3 mm
# smaller than drawn on three sides, to keep this board's general 0.3 mm edge clearance.
KH44_CUT = [(1.05, 9.00), (1.05, 17.70), (-1.50, 17.70), (-1.95, 14.80), (-2.89, 14.80), (-2.89, 13.25),
            (-1.05, 13.25), (-1.05, 9.00)]


def kh44_footprint():
    """Kinghelm KH-PJ-44002-12DBAP-A, 4.4 mm balanced jack, from its drawing (LCSC C42396781).
    Origin on the jack's axis at its front face, nose towards -y, drawn as if on the top side
    (it is placed on the back). Legs are 0.55 mm slots; the drawing's relief cut-out for the
    plug switch (KH44_CUT, corners rounded 0.3 mm as drawn) is cut through the board, with a
    keep-out 0.25 mm around it for the routers."""
    legs = [("1", 1.75), ("2", 4.75), ("3", 7.75), ("4", 10.75)]
    tht = [(n, 2.725, y, 0.95, 2.15, 0.55, 1.75) for n, y in legs] + \
          [(str(int(n) + 5), -2.725, y, 0.95, 2.15, 0.55, 1.75) for n, y in legs] + \
          [("5", 2.525, 14.70, 0.95, 1.95, 0.55, 1.55), ("10", -2.525, 16.00, 0.95, 1.95, 0.55, 1.55),
           ("11", -3.575, 12.95, 0.95, 1.95, 0.55, 1.55), ("12", 0.0, 18.38, 1.95, 0.95, 1.55, 0.55)]
    cut = rounded(KH44_CUT, 0.3)
    keep = [(round(x, 4), round(y, 4)) for x, y in grown(KH44_CUT, 0.25)]
    return dict(name="Jack_4.4mm_KH-PJ-44002-12DBAP-A", attr="through_hole", tht=tht, cutout=cut, keepout=keep,
                descr="Kinghelm KH-PJ-44002-12DBAP-A 4.4 mm 5-pole jack, 12 pins: 1/6 ground, 2/7 R-, 3/8 R+, "
                      "4/9 L-, 5/10 L+, 11/12 plug switch; axis 2.5 mm above its seat, 2.8 mm nose",
                courtyard=(-4.3, 4.3, 0.0, 19.1), fab=(-3.25, 3.25, 0.0, 18.25),
                model=[("box", -3.25, 3.25, 0.0, 18.25, 0.0, 5.0, BLACK),
                       ("cyl", 0, 2.5, 3.0, -2.8, 0.0, METAL), ("cyl", 0, 2.5, 2.25, -2.85, -1.5, BLACK)])


FOOTPRINTS = [
    dict(name="Jack_3.5mm_PJ-342", attr="smd",
         descr="SHOU HAN PJ-342 3.5 mm jack, from its drawing (LCSC C668606; pads as in JLCPCB's EasyEDA "
               "library, https://easyeda.com). Origin on the axis at the front face, nose towards -y, drawn "
               "as if on the top side; axis 2.25 mm above its seat, 2 mm nose",
         pads=[("2", 3.6, 2.2, 2.0, 1.5), ("5", -3.6, 2.2, 2.0, 1.5), ("6", -3.6, 5.5, 2.0, 1.5),
               ("3", 3.6, 9.5, 2.0, 1.5), ("7", -3.6, 11.0, 2.0, 1.5), ("4", 3.3, 11.5, 2.6, 1.5)],
         holes=[(0.0, 2.4, 1.5), (0.0, 9.4, 1.5)],
         courtyard=(-4.85, 4.85, -0.25, 12.5), fab=(-4.25, 4.25, 0.0, 12.0),
         model=[("box", -4.25, 4.25, 0.0, 12.0, 0.0, 4.5, BLACK),
                ("cyl", 0, 2.25, 2.5, -2.0, 0.0, BLACK), ("cyl", 0, 2.25, 1.75, -2.05, -1.0, GREY)]),
    kh44_footprint(),
    dict(name="microSD_TF-01A", attr="smd",
         descr="Hroparts TF-01A push-push microSD socket (LCSC C91145; pads as in JLCPCB's EasyEDA library, "
               "https://easyeda.com). Card mouth towards +y; pad CD is the unused card-detect contact",
         pads=[(str(i + 1), 2.24 - 1.1 * i, -5.276, 0.6, 1.3) for i in range(8)] +
              [("CD", -6.56, -5.276, 0.6, 1.3), ("SH", -7.76, -4.426, 1.2, 1.4), ("SH", 6.92, -4.426, 1.2, 1.4),
               ("SH", -7.76, 5.276, 1.2, 2.0), ("SH", 7.76, 5.276, 1.2, 2.0)],
         holes=[(-4.95, 5.566, 1.0), (3.05, 5.566, 1.0)],
         courtyard=(-8.6, 8.6, -6.2, 9.9), fab=(-7.0, 7.0, -4.6, 9.675),
         model=[("box", -7.0, 7.0, -4.6, 9.675, 0.0, 1.8, METAL), ("box", -5.6, 5.6, 9.6, 9.7, 0.4, 1.4, BLACK)]),
    dict(name="Battery_Pads_1x03", attr="smd", descr="Solder pads for the battery's three wires: 1 +, 2 -, 3 NTC",
         pads=[(str(i + 1), 0, -2.5 + 2.5 * i, 3.0, 1.6) for i in range(3)],
         courtyard=(-1.8, 1.8, -3.6, 3.6), fab=(-1.5, 1.5, -3.3, 3.3), model=None,
         silk=[("+", -2.6, -2.5), ("-", -2.6, 0.0), ("T", -2.6, 2.5)]),
    dict(name="Reset_Pads_1x02", attr="smd",
         descr="Two bare pads 1 mm apart, 1 EN and 2 ground: bridge them for a moment to reset the ESP32",
         pads=[("1", -1.25, 0, 1.5, 1.5), ("2", 1.25, 0, 1.5, 1.5)],
         courtyard=(-2.3, 2.3, -1.05, 1.05), fab=(-2.0, 2.0, -0.75, 0.75), model=None,
         silk=[("RST", 0.0, 1.9)]),
]


def write_wrl(path, solids):
    """Simple VRML model. KiCad's VRML unit is 0.1 inch and its model y axis points the
    opposite way to the footprint's."""
    s = 1 / 2.54
    out = ["#VRML V2.0 utf8"]
    for solid in solids:
        if solid[0] == "box":
            _, x0, x1, y0, y1, z0, z1, rgb = solid
            ring = [(x0, y0), (x1, y0), (x1, y1), (x0, y1)]
            pts = [(x, -y, z) for z in (z0, z1) for x, y in ring]
        else:   # cylinder along the footprint's y axis
            _, cx, cz, r, y0, y1, rgb = solid
            ring = [(cx + r * math.cos(2 * math.pi * i / 24), cz + r * math.sin(2 * math.pi * i / 24))
                    for i in range(24)]
            pts = [(x, -y, z) for y in (y0, y1) for x, z in ring]
        n = len(pts) // 2
        faces = [list(range(n)), list(range(n, 2 * n))] + \
                [[i, (i + 1) % n, n + (i + 1) % n, n + i] for i in range(n)]
        # KiCad draws only the front of a face: turn every face outwards (the solids are convex)
        mid = [sum(p[k] for p in pts) / len(pts) for k in range(3)]
        for j, f in enumerate(faces):
            q = [pts[i] for i in f]
            normal = [sum((a[(k + 1) % 3] - b[(k + 1) % 3]) * (a[(k + 2) % 3] + b[(k + 2) % 3])
                          for a, b in zip(q, q[1:] + q[:1])) for k in range(3)]   # Newell's method
            centre = [sum(p[k] for p in q) / len(q) for k in range(3)]
            if sum(normal[k] * (centre[k] - mid[k]) for k in range(3)) < 0:
                faces[j] = f[::-1]
        out.append("Shape { appearance Appearance { material Material { diffuseColor %.3f %.3f %.3f "
                   "specularColor 0.25 0.25 0.25 shininess 0.4 } }" % rgb)
        out.append("  geometry IndexedFaceSet { creaseAngle 0.6 coord Coordinate { point [")
        out.append(",\n".join("    %.4f %.4f %.4f" % (x * s, y * s, z * s) for x, y, z in pts) + " ] }")
        out.append("  coordIndex [ " + ", ".join(", ".join(map(str, f)) + ", -1" for f in faces) + " ] } }")
    with open(path, "w") as f:
        f.write("\n".join(out) + "\n")


def write_footprints():
    os.makedirs(FP_LIB, exist_ok=True)
    os.makedirs(os.path.join(HW, "3d"), exist_ok=True)
    font = ["effects", ["font", ["size", 1, 1], ["thickness", 0.15]]]
    for old in os.listdir(FP_LIB):    # footprints and models of parts no longer used
        if old.endswith(".kicad_mod") and old[:-10] not in {s["name"] for s in FOOTPRINTS}:
            os.remove(os.path.join(FP_LIB, old))
    for spec in FOOTPRINTS:
        x0, x1, y0, y1 = spec["courtyard"]
        fx0, fx1, fy0, fy1 = spec["fab"]
        tree = ["footprint", K.Q(spec["name"]), ["version", 20240108], ["generator", K.Q("make_pcb")],
                ["layer", K.Q("F.Cu")], ["descr", K.Q(spec["descr"])],
                ["property", K.Q("Reference"), K.Q("REF**"), ["at", 0, y0 - 1.2, 0], ["layer", K.Q("F.SilkS")], font],
                ["property", K.Q("Value"), K.Q(spec["name"]), ["at", 0, y1 + 1.2, 0], ["layer", K.Q("F.Fab")], font],
                ["attr", spec["attr"]],
                ["fp_rect", ["start", x0, y0], ["end", x1, y1], ["stroke", ["width", 0.05], ["type", "solid"]],
                 ["fill", "no"], ["layer", K.Q("F.CrtYd")]],
                ["fp_rect", ["start", fx0, fy0], ["end", fx1, fy1], ["stroke", ["width", 0.1], ["type", "solid"]],
                 ["fill", "no"], ["layer", K.Q("F.Fab")]]]
        for text, tx, ty in spec.get("silk", []):
            tree.append(["fp_text", "user", K.Q(text), ["at", tx, ty, 0], ["layer", K.Q("F.SilkS")], font])
        for num, px, py, pw, ph in spec.get("pads", []):
            tree.append(["pad", K.Q(num), "smd", "roundrect", ["at", px, py], ["size", pw, ph],
                         ["layers", K.Q("F.Cu"), K.Q("F.Paste"), K.Q("F.Mask")], ["roundrect_rratio", 0.25]])
        for num, px, py, pw, ph, dw, dh in spec.get("tht", []):
            tree.append(["pad", K.Q(num), "thru_hole", "oval", ["at", px, py], ["size", pw, ph],
                         ["drill", "oval", dw, dh], ["layers", K.Q("*.Cu"), K.Q("*.Mask")]])
        for hx, hy, d in spec.get("holes", []):
            tree.append(["pad", K.Q(""), "np_thru_hole", "circle", ["at", hx, hy], ["size", d, d], ["drill", d],
                         ["layers", K.Q("*.Cu"), K.Q("*.Mask")]])
        if spec.get("cutout"):     # a hole through the board, and a keep-out around it for the routers
            tree.append(["fp_poly", ["pts"] + [["xy", x, y] for x, y in spec["cutout"]],
                         ["stroke", ["width", 0.05], ["type", "solid"]], ["fill", "no"], ["layer", K.Q("Edge.Cuts")]])
            tree.append(["zone", ["net", 0], ["net_name", K.Q("")],
                         ["layers"] + [K.Q(n) for n in ("F.Cu", "In1.Cu", "In2.Cu", "In3.Cu", "In4.Cu", "B.Cu")],
                         ["name", K.Q("cut-out keep-out")], ["hatch", "edge", 0.5],
                         ["connect_pads", ["clearance", 0]], ["min_thickness", 0.25], ["filled_areas_thickness", "no"],
                         ["keepout", ["tracks", "not_allowed"], ["vias", "not_allowed"], ["pads", "allowed"],
                          ["copperpour", "not_allowed"], ["footprints", "allowed"]],
                         ["fill", ["thermal_gap", 0.5], ["thermal_bridge_width", 0.5]],
                         ["polygon", ["pts"] + [["xy", x, y] for x, y in spec["keepout"]]]])
        if spec["model"]:
            wrl = f"{spec['name']}.wrl"
            write_wrl(os.path.join(HW, "3d", wrl), spec["model"])
            tree.append(["model", K.Q("${KIPRJMOD}/3d/" + wrl), ["offset", ["xyz", 0, 0, 0]],
                         ["scale", ["xyz", 1, 1, 1]], ["rotate", ["xyz", 0, 0, 0]]])
        with open(os.path.join(FP_LIB, spec["name"] + ".kicad_mod"), "w") as f:
            f.write(K.dump(tree) + "\n")
    used = {f"{s['name']}.wrl" for s in FOOTPRINTS if s["model"]} | {f"{n}.wrl" for n in MODEL_BOXES}
    for old in os.listdir(os.path.join(HW, "3d")):
        if old.endswith(".wrl") and old not in used:
            os.remove(os.path.join(HW, "3d", old))
    for name, boxes in MODEL_BOXES.items():
        write_wrl(os.path.join(HW, "3d", name + ".wrl"), boxes)


# ---- Netlist from the schematic

def read_netlist():
    sch = os.path.join(HW, "dap.kicad_sch")
    with tempfile.TemporaryDirectory() as tmp:
        path = os.path.join(tmp, "dap.net")
        subprocess.run([M.KICAD_CLI, "sch", "export", "netlist", "-o", path, sch], check=True,
                       capture_output=True)
        tree = K.parse(open(path, encoding="utf-8").read())[0]
    comps = {}
    for c in K.find(K.first(tree, "components"), "comp"):
        ref = str(K.first(c, "ref")[1])
        sheet = K.first(c, "sheetpath")
        comps[ref] = dict(fp=str(K.first(c, "footprint")[1]), value=str(K.first(c, "value")[1]),
                          path=str(K.first(sheet, "tstamps")[1]) + str(K.first(c, "tstamps")[1]),
                          sheet=str(K.first(sheet, "names")[1]).strip("/"))
    pins = {}
    for n in K.find(K.first(tree, "nets"), "net"):
        name = str(K.first(n, "name")[1])
        for node in K.find(n, "node"):
            pins[(str(K.first(node, "ref")[1]), str(K.first(node, "pin")[1]))] = name
    return comps, pins


# ---- Geometry helpers (case frame unless noted)

def mm(v):
    return pcbnew.FromMM(v)


def to_kicad(x, y):
    return pcbnew.VECTOR2I(mm(OX + x), mm(OY - y))


def to_case(p):
    return pcbnew.ToMM(p.x) - OX, OY - pcbnew.ToMM(p.y)


def local_box(fp):
    """Keep-clear box in the footprint's own frame (mm, y down), taken before it is moved:
    the courtyard's bounding box, or for BODY_ONLY parts the part of it within 1 mm of the
    body (their keep-out rule area is added separately, see zone_boxes)."""
    fp.BuildCourtyardCaches()
    poly = fp.GetCourtyard(pcbnew.F_CrtYd)
    bb = poly.BBox() if poly.OutlineCount() else fp.GetBoundingBox()
    box = (pcbnew.ToMM(bb.GetLeft()), pcbnew.ToMM(bb.GetRight()),
           pcbnew.ToMM(bb.GetTop()), pcbnew.ToMM(bb.GetBottom()))
    if fp.GetFPID().GetLibItemName().wx_str() in BODY_ONLY:
        shapes = [d for d in fp.GraphicalItems() if isinstance(d, pcbnew.PCB_SHAPE) and d.GetLayer() == pcbnew.F_Fab]
        xs = [pcbnew.ToMM(v) for d in shapes for v in (d.GetStart().x, d.GetEnd().x)]
        ys = [pcbnew.ToMM(v) for d in shapes for v in (d.GetStart().y, d.GetEnd().y)]
        box = (max(box[0], min(xs) - 1), min(box[1], max(xs) + 1),
               max(box[2], min(ys) - 1), min(box[3], max(ys) + 1))
    return box


def zone_boxes(fp):
    """Keep-out rule areas that ban footprints (the ESP32's antenna area), as case-frame
    boxes, once the footprint is in place."""
    out = []
    for z in fp.Zones():
        if z.GetIsRuleArea() and z.GetDoNotAllowFootprints():
            bb = z.GetBoundingBox()
            (x0, y1), (x1, y0) = to_case(bb.GetOrigin()), to_case(bb.GetEnd())
            out.append((x0, x1, y0, y1))
    return out


def turned(box, rot):
    """The local box after rotating by rot degrees, as offsets in the case frame."""
    c, s = round(math.cos(math.radians(rot))), round(math.sin(math.radians(rot)))
    x0, x1, y0, y1 = box
    pts = [(u * c + v * s, u * s - v * c) for u in (x0, x1) for v in (y0, y1)]
    return min(p[0] for p in pts), max(p[0] for p in pts), min(p[1] for p in pts), max(p[1] for p in pts)


def overlaps(a, b):
    return a[0] < b[1] - 1e-6 and b[0] < a[1] - 1e-6 and a[2] < b[3] - 1e-6 and b[2] < a[3] - 1e-6


def board_outline():
    """Outline points: rounded bottom corners, cut-outs at the top corners for the screw
    bosses, notches for the jacks."""
    r, pts = R_CORNER, []
    for cx, cy, a0 in ((-HX + r, -HY + r, 180), (HX - r, -HY + r, 270)):
        pts += [(cx + r * math.cos(math.radians(a0 + 15 * i)), cy + r * math.sin(math.radians(a0 + 15 * i)))
                for i in range(7)]
    bx, by = BOSS_NOTCH
    pts += [(HX, by), (bx, by), (bx, HY)]
    for x0, x1, y0 in sorted(NOTCHES, reverse=True):
        pts += [(x1, HY), (x1, y0), (x0, y0), (x0, HY)]
    return pts + [(-bx, HY), (-bx, by), (-HX, by)]


def keepouts():
    """Board areas nothing may cover: the notches and corner cut-outs, as boxes."""
    bx, by = BOSS_NOTCH
    return [(x0, x1, y0, HY + 5) for x0, x1, y0 in NOTCHES] + [(bx, HX + 5, by, HY + 5), (-HX - 5, -bx, by, HY + 5)]


# ---- Building the board

def build():
    write_footprints()
    comps, pins = read_netlist()
    sheets = [(n, f, fn()) for n, f, fn in M.SHEETS]
    M.assign_refs(sheets)
    groups = {parts[0].ref: [p.ref for p in parts] for _, _, gs in sheets for _, parts in gs}
    missing = set(comps) ^ {r for g in groups.values() for r in g}
    if missing:
        sys.exit(f"schematic and design table disagree on {sorted(missing)}: re-run make_schematic.py")

    board = pcbnew.CreateEmptyBoard()
    board.SetCopperLayerCount(6)
    for layer in (pcbnew.In1_Cu, pcbnew.In4_Cu):   # the ground planes; Freerouting leaves these alone
        board.SetLayerType(layer, pcbnew.LT_POWER)
    board.GetDesignSettings().SetBoardThickness(mm(PCB_T))
    nets = {}
    for name in sorted(set(pins.values())):
        nets[name] = pcbnew.NETINFO_ITEM(board, name)
        board.Add(nets[name])

    pts = [to_kicad(x, y) for x, y in board_outline()]
    for a, b in zip(pts, pts[1:] + pts[:1]):
        seg = pcbnew.PCB_SHAPE(board, pcbnew.SHAPE_T_SEGMENT)
        seg.SetStart(a)
        seg.SetEnd(b)
        seg.SetLayer(pcbnew.Edge_Cuts)
        seg.SetWidth(mm(0.1))
        board.Add(seg)

    fps, boxes, pad_local = {}, {}, {}
    for ref, c in sorted(comps.items()):
        lib, name = c["fp"].split(":")
        fp = pcbnew.FootprintLoad(FP_LIB if lib == "dap" else os.path.join(K.KICAD_FOOTPRINTS, lib + ".pretty"),
                                  name)
        if fp is None:
            sys.exit(f"{ref}: footprint {c['fp']} not found")
        fp.SetFPID(pcbnew.LIB_ID(lib, name))
        fp.SetReference(ref)
        fp.SetValue(c["value"])
        fp.SetPath(pcbnew.KIID_PATH(c["path"]))
        fp.SetSheetname(c["sheet"])
        fp.Reference().SetLayer(pcbnew.F_Fab)   # no reference text on the silkscreen: too dense
        for pad in fp.Pads():
            net = pins.get((ref, pad.GetNumber()))
            if net:
                pad.SetNet(nets[net])
            if 0 < pad.GetDrillSize().x < mm(MIN_HOLE):   # thermal vias: same pad, bigger hole
                pad.SetDrillSize(pcbnew.VECTOR2I(mm(MIN_HOLE), mm(MIN_HOLE)))
        if name in MODEL_SUBST or name in MODEL_BOXES:
            fp.Models().clear()
            model = pcbnew.FP_3DMODEL()
            model.m_Filename = ("${KICAD10_3DMODEL_DIR}/" + MODEL_SUBST[name] if name in MODEL_SUBST
                                else f"${{KIPRJMOD}}/3d/{name}.wrl")
            fp.Models().push_back(model)
        boxes[ref] = local_box(fp)
        pad_local[ref] = [(p.GetNetname(), pcbnew.ToMM(p.GetPosition().x), pcbnew.ToMM(p.GetPosition().y))
                          for p in fp.Pads()]   # still at the origin, unturned
        board.Add(fp)
        fps[ref] = fp

    taken = {"F": [("notch", b) for b in keepouts()], "B": []}
    problems = []

    def fine_pitch(ref):
        pts = [(u, v) for _, u, v in pad_local[ref]]
        if len(pts) < 8:
            return False
        return min(math.hypot(a[0] - b[0], a[1] - b[1]) for i, a in enumerate(pts) for b in pts[i + 1:]
                   if (a[0], a[1]) != (b[0], b[1])) <= 0.55

    def put(ref, x, y, rot, side="F"):
        fp = fps[ref]
        fp.SetPosition(to_kicad(x, y))
        fp.SetOrientationDegrees(rot)
        if side == "B":
            fp.Flip(fp.GetPosition(), pcbnew.FLIP_DIRECTION_LEFT_RIGHT)
        t = turned(boxes[ref], rot)
        box = (x + t[0], x + t[1], y + t[2], y + t[3])
        for other, b in taken[side]:
            if overlaps(box, b) and not (other == "notch" and ref in COVERS_NOTCH):
                problems.append(f"{ref} overlaps {other}")
        if box[0] < -HX - 0.01 or box[1] > HX + 0.01 or box[2] < -HY - 0.01:
            if ref not in ("U8", "J4", "J5"):
                problems.append(f"{ref} is off the board")
        taken[side].append((ref, box))
        if side == "B" and ref in THROUGH:
            taken["F"].append((ref, box))
        if fine_pitch(ref):   # room around it for the tracks fanning out of its pins
            f = FANOUT_BY_REF.get(ref, FANOUT)
            taken[side].append((f"{ref} fan-out", (box[0] - f, box[1] + f, box[2] - f, box[3] + f)))
        for z in zone_boxes(fp):
            taken["F"].append((f"{ref} keep-out", z))
            taken["B"].append((f"{ref} keep-out", z))

    for ref, spec in PLACE.items():
        put(ref, *spec)
    for ref, strips in KEEP_CLEAR.items():
        x, y = PLACE[ref][:2]
        taken["F"] += [(f"{ref} pins", (x + x0, x + x1, y + y0, y + y1)) for x0, y0, x1, y1 in strips]

    def goal(ref, targets):
        mine = {p.GetNetname() for p in fps[ref].Pads()} - {"GND", ""}
        pts = [to_case(p.GetPosition()) for t in targets for p in fps[t].Pads() if p.GetNetname() in mine]
        if not pts:
            pts = [to_case(fps[t].GetPosition()) for t in targets]
        return sum(p[0] for p in pts) / len(pts), sum(p[1] for p in pts) / len(pts)

    def pad_aims(ref, targets):
        """For each net of the part (not ground) that the targets share: where those pins are."""
        aims = {}
        for net, _, _ in pad_local[ref]:
            if net not in ("GND", "") and net not in aims:
                pts = [to_case(p.GetPosition()) for t in targets for p in fps[t].Pads() if p.GetNetname() == net]
                if pts:
                    aims[net] = (sum(p[0] for p in pts) / len(pts), sum(p[1] for p in pts) / len(pts))
        return aims

    def pad_cost(ref, x, y, rot, aims):
        """How far each pad sits from the pins of its own net: picks the way round a part
        faces, so that a capacitor between two neighbouring pins doesn't cross its tracks."""
        c, s_ = round(math.cos(math.radians(rot))), round(math.sin(math.radians(rot)))
        return sum(math.hypot(x + u * c + v * s_ - aims[net][0], y + u * s_ - v * c - aims[net][1])
                   for net, u, v in pad_local[ref] if net in aims)

    def area_of(b):
        return (b[1] - b[0]) * (b[3] - b[2])

    placed = set(PLACE)
    order = [g for g, _ in AREA] + [g for g in groups if g not in dict(AREA)]
    for g in order:
        rect = dict(AREA).get(g)
        # Parts between two pins of the placed parts (a chip's flying and filter capacitors)
        # first, so they sit right at their pins; then the rest, largest first
        joined = {n for t in placed for p in fps[t].Pads() for n in [p.GetNetname()] if n not in ("GND", "")}
        todo = sorted((r for r in groups[g] if r not in placed),
                      key=lambda r: (len({n for n, _, _ in pad_local[r]} & joined) < 2, -area_of(boxes[r])))
        for ref in todo:
            targets = TARGETS.get(g) or [r for r in groups[g] if r in placed]
            gx, gy = goal(ref, targets)
            wx0, wy0, wx1, wy1 = rect or (gx - 12, gy - 12, gx + 12, gy + 12)
            wx0, wy0, wx1, wy1 = max(wx0, -HX), max(wy0, -HY), min(wx1, HX), min(wy1, HY)
            near = [b for _, b in taken["F"] if overlaps(b, (wx0 - 1, wx1 + 1, wy0 - 1, wy1 + 1))]
            aims = pad_aims(ref, targets)
            best = None
            for rot in (0, 90, 180, 270):   # nearest free spot each way round; keep the way whose pads face their pins
                t = turned(boxes[ref], rot)
                xs = [wx0 - t[0] + STEP * i for i in range(int((wx1 - wx0 - t[1] + t[0]) / STEP) + 1)]
                ys = [wy0 - t[2] + STEP * i for i in range(int((wy1 - wy0 - t[3] + t[2]) / STEP) + 1)]
                cands = sorted(((x - gx) ** 2 + (y - gy) ** 2, x, y) for x in xs for y in ys)
                for d, x, y in cands:
                    box = (x + t[0], x + t[1], y + t[2], y + t[3])
                    if not any(overlaps(box, b) for b in near):
                        score = pad_cost(ref, x, y, rot, aims) + 0.5 * math.sqrt(d)
                        if best is None or score < best[0] - 1e-6:
                            best = (score, x, y, rot)
                        break
            if not best:
                sys.exit(f"no room for {ref} ({comps[ref]['value']}) in group {g}'s area")
            put(ref, best[1], best[2], best[3])
            placed.add(ref)

    title = pcbnew.PCB_TEXT(board)
    title.SetText("E-ink DAP  v0.3\n2026-11-12")
    title.SetLayer(pcbnew.B_SilkS)
    title.SetMirrored(True)
    title.SetTextSize(pcbnew.VECTOR2I(mm(1.6), mm(1.6)))
    title.SetTextThickness(mm(0.25))
    title.SetPosition(to_kicad(0, -20))
    board.Add(title)

    autorouted = route(board, nets) if ROUTE else False
    pcbnew.SaveBoard(BOARD_FILE, board, True)
    with open(os.path.join(HW, "dap.kicad_dru"), "w") as f:
        f.write(DRC_RULES)
    if autorouted:
        widened, removed = tidy(BOARD_FILE)
        print(f"autoroute: {widened} narrow track ends widened to 0.1 mm, {removed} dead-end tracks and vias removed")
        repair(BOARD_FILE)
    used = sum(1 for n in nets if not n.startswith("unconnected-"))
    print(f"pcb: {len(fps)} parts placed on {2 * HX:.1f} x {2 * HY:.1f} mm, {used} nets")
    for p in problems:
        print("   ", p)
    check()
    if RENDER:
        render()
    export_glb()


def other_nets(r, code):
    """Nets not in ROUTES or POWER_ROUTES, split into short local ones (a chip and its
    capacitors, a feedback divider) and longer lines, each list shortest first."""
    planned = {n for names, _ in ROUTES + POWER_ROUTES for n in names} | {"GND"}
    spans = []
    for name, c in code.items():
        if name in planned or name.startswith("unconnected-"):
            continue
        seen = {}
        for pad, _, _ in r.nets.get(c, []):
            seen[r._name(pad)] = r._centre(pad)
        if len(seen) < 2:
            continue
        xs, ys = [p[0] for p in seen.values()], [p[1] for p in seen.values()]
        spans.append((math.hypot(max(xs) - min(xs), max(ys) - min(ys)), name))
    spans.sort()
    local = [([n], dict(full_width=0.3)) for d, n in spans if d < LOCAL]
    far = [([n], dict(full_width=0.2)) for d, n in spans if d >= LOCAL]
    return local, far


def route(board, nets):
    """Ground vias, escape stubs and pins' own vias; every net whose pins lie within LOCAL of
    each other, then ROUTES, then POWER_ROUTES, then the other nets; Freerouting for what is
    left; then the copper fills (PLANES, FILLS)."""
    import pcb_router
    outline = [(OX + x, OY - y) for x, y in board_outline()]
    r = pcb_router.Router(board, outline, ROUTING_LAYERS)
    code = {name.split("/")[-1]: n.GetNetCode() for name, n in nets.items()}
    for ref, (x0, y0, x1, y1), names in CHANNELS:
        x, y = PLACE[ref][:2]
        r.reserve(OX + x + x0, OY - y - y1, OX + x + x1, OY - y - y0, [code[n] for n in names])
    gnd = code["GND"]
    pads = []
    for fp in board.GetFootprints():
        tht = {p.GetNumber() for p in fp.Pads() if p.GetAttribute() == pcbnew.PAD_ATTRIB_PTH}
        pads += [p for p in fp.Pads() if p.GetNetCode() == gnd and p.GetAttribute() == pcbnew.PAD_ATTRIB_SMD
                 and p.GetNumber() not in tht]   # pads with vias of their own (thermal pads) are skipped
    failed = r.fanout(gnd, pads)
    print(f"route: {len(pads) - len(failed)} of {len(pads)} ground pads joined to the planes")
    for p in failed:
        print(f"    no room for a via by {p.GetParentFootprint().GetReference()} pad {p.GetNumber()}")
    local, far = other_nets(r, code)
    plan = local + ROUTES + POWER_ROUTES + far
    ours = {code[n] for names, _ in plan for n in names}
    stubs = r.escape(sorted(ours), parts=STUB_PARTS)
    print(f"route: {stubs} fine-pitch pins given an escape stub")
    if not r.bridge(code[USB_C_BRIDGE[0]], USB_C_BRIDGE[1]):
        print("    no room to bridge the USB-C D- pins")
    first = [(code[n], dict(opts)) for names, opts in local + far for n in names if n in FIRST]
    stuck_first = sum(r.route_net(net, **opts) for net, opts in first)
    print(f"route: {len(first)} nets routed before the pin vias (FIRST), {stuck_first} connections not made")
    # A via for each stubbed pin (not on the USB pairs, which stay on the outer layers, nor the
    # switching nodes, nor the nets routed already): first the pins of nets that leave their
    # chip, then, where room is left, those of the short local nets (giving way where a pin next
    # to them found none); unused ones go again after routing
    no_room = [p for group, yield_ in ((ROUTES + POWER_ROUTES + far, YIELD_ALL), (local if LOCAL_PIN_VIAS else [], True))
               for p in r.via_out(sorted(code[n] for names, _ in group for n in names
                                         if n not in USB_NETS + SWITCHING + FIRST), yield_to_stuck=yield_)]
    print(f"route: {len(r.via_end)} chip pins given a via of their own; no room by "
          f"{', '.join(no_room) or 'none'}")
    jobs = []
    for names, opts in plan:
        opts = dict(opts)
        if "partner" in opts:
            opts["partner"] = code[opts["partner"]]
        jobs += [(code[name], opts) for name in names]
    stuck = r.route_all(jobs, done={net for net, _ in first})
    unused = r.drop_unused_vias(keep_nets=set(stuck))   # Freerouting may use those of nets left open
    r.drop_unused_stubs()
    pieces = list(board.GetTracks())
    vias = sum(1 for t in pieces if t.GetClass() == "PCB_VIA")
    print(f"route: {sum(len(n) for n, _ in plan)} nets, {len(pieces) - vias} track pieces, {vias} vias "
          f"({unused} unused pin vias taken away), {sum(len(v) for v in stuck.values())} connections not made")
    for net, pins in stuck.items():
        for name, _, why in pins:
            print(f"    could not join {name} ({board.FindNet(net).GetNetname() if hasattr(board, 'FindNet') else net}): {why}")
    for names, _ in ROUTES + POWER_ROUTES:
        print("    " + ", ".join(f"{n} {r.length.get(code[n], 0):.0f} mm" for n in names))
    for nets_, what in ((local, "short local nets"), (far, "other nets")):
        total = sum(r.length.get(code[n], 0) for names, _ in nets_ for n in names)
        print(f"    {len(nets_)} {what}, {total:.0f} mm")

    # The ground planes go in before Freerouting, which leaves them whole; the fills on
    # layers 3, 4 and 6 after it, so they fill around its tracks
    for layer, net in PLANES:
        add_zone(board, outline, layer, nets[net])
    pcbnew.ZONE_FILLER(board).Fill(board.Zones())
    set_netclasses(board)
    if stuck and FREEROUTE:
        autoroute(board, len(stuck))
    elif stuck:
        print(f"autoroute: {sum(len(v) for v in stuck.values())} connections left for the repair step "
              "(Freerouting only with --freerouting)")
    else:
        print("autoroute: nothing left for Freerouting")
    for layer, net in FILLS:
        add_zone(board, outline, layer, nets[net])
    pcbnew.ZONE_FILLER(board).Fill(board.Zones())
    return True   # tidied and repaired whether or not Freerouting ran or worked


def set_netclasses(board):
    """NETCLASSES as KiCad net classes, so the Specctra file gives Freerouting their widths."""
    ns = board.GetDesignSettings().m_NetSettings
    for name, width, patterns in NETCLASSES:
        nc = pcbnew.NETCLASS(name)
        nc.SetTrackWidth(mm(width))
        nc.SetClearance(mm(0.1))
        nc.SetViaDiameter(mm(0.5))
        nc.SetViaDrill(mm(0.3))
        ns.SetNetclass(name, nc)
        for pattern in patterns:
            ns.SetNetclassPatternAssignment(pattern, name)
    ns.RecomputeEffectiveNetclasses()
    board.SynchronizeNetsAndNetClasses(True)


def add_zone(board, outline, layer, net):
    zone = pcbnew.ZONE(board)
    zone.SetLayer(layer)
    zone.SetNet(net)
    zone.SetZoneName(f"{net.GetNetname()} {board.GetLayerName(layer)}")
    outline_poly = zone.Outline()
    outline_poly.NewOutline()
    for x, y in outline:
        outline_poly.Append(mm(x), mm(y))
    zone.SetMinThickness(mm(0.2))
    zone.SetLocalClearance(mm(0.2))
    zone.SetPadConnection(pcbnew.ZONE_CONNECTION_FULL)
    zone.SetIslandRemovalMode(pcbnew.ISLAND_REMOVAL_MODE_ALWAYS)
    board.Add(zone)


def autoroute(board, n_nets):
    """Hands every connection not routed yet to Freerouting (FREEROUTING, a Java program; run
    with its usage statistics off) in a Specctra file: all tracks so far as fixed wiring, so it
    only adds the missing ones, layers 2 and 5 as ground planes; Freerouting's session comes
    back in. Tracks 0.15 mm unless NETCLASSES says otherwise, clearance
    0.1 mm, vias 0.5/0.3 mm."""
    if not os.path.exists(FREEROUTING):
        print(f"autoroute: {os.path.relpath(FREEROUTING, ROOT)} not found, {n_nets} nets left unrouted")
        return False
    nc = board.GetDesignSettings().m_NetSettings.GetDefaultNetclass()
    nc.SetClearance(mm(0.1))
    nc.SetTrackWidth(mm(0.15))
    nc.SetViaDiameter(mm(0.5))
    nc.SetViaDrill(mm(0.3))
    for t in board.GetTracks():
        t.SetLocked(True)
    # Its input and output are kept next to the log (tools/freerouting.nosync/last-run.*), so
    # Freerouting can be tried again by hand; --ses=FILE imports such a session instead of running it.
    dsn, ses = FREEROUTING_LOG[:-4] + ".dsn", FREEROUTING_LOG[:-4] + ".ses"
    pcbnew.ExportSpecctraDSN(board, dsn)
    given = [a.split("=", 1)[1] for a in sys.argv if a.startswith("--ses=")]
    log = ""
    if given:
        ses = given[0]
        print(f"autoroute: importing {ses} instead of running Freerouting")
    else:
        with tempfile.TemporaryDirectory() as tmp:
            env = dict(os.environ, FREEROUTING__USAGE_AND_DIAGNOSTIC_DATA__DISABLE_ANALYTICS="true")
            if os.path.exists(ses):
                os.remove(ses)
            with open(FREEROUTING_LOG, "w") as log_file:   # streamed, so a long run can be followed
                run = subprocess.run(["java", "-jar", FREEROUTING, "-de", dsn, "-do", ses,
                                      "-mt", str(FREEROUTING_THREADS),
                                      f"--router.autorouter.max_passes={FREEROUTING_PASSES}",
                                      f"--router.optimizer.max_threads={FREEROUTING_THREADS}",
                                      "--router.automatic_neckdown=false", "--gui.enabled=false",
                                      "--usage_and_diagnostic_data.disable_analytics=true", f"--user_data_path={tmp}"],
                                     stdout=log_file, stderr=subprocess.STDOUT, text=True, env=env,
                                     timeout=FREEROUTING_TIMEOUT)
            log = open(FREEROUTING_LOG).read()
        if run.returncode or not os.path.exists(ses):
            print(f"autoroute: Freerouting failed ({run.returncode}): {log[-800:]}")
            return False
    before = len(board.GetTracks())
    pcbnew.ImportSpecctraSES(board, ses)
    print(f"autoroute: Freerouting routed {n_nets} nets; tracks and vias {before} -> {len(board.GetTracks())}")
    for line in log.splitlines():
        if "Auto-routing stage completed" in line:
            print("    " + line.split("] ", 1)[-1].strip()[:160])
    return True


def tidy(path):
    """After routing, on the saved board: widens neck-downs below 0.1 mm (the board's minimum;
    Freerouting makes them) to 0.1 mm, then removes tracks and vias that KiCad's own
    connectivity check finds leading nowhere, round after round until none are left (each
    removal can leave the next piece of a dead branch). Each removal is kept only if KiCad's
    count of unrouted connections doesn't go up: a track with one open end can still carry
    another that ends partway along it. Removed items stay referenced (see
    Router._remove). Returns (widened, removed)."""
    widened = removed = 0
    board = pcbnew.LoadBoard(path)
    for t in board.GetTracks():
        if t.GetClass() == "PCB_TRACK" and t.GetWidth() < mm(0.1):
            t.SetWidth(mm(0.1))
            widened += 1
    gone = []
    for _ in range(100):
        board.BuildConnectivity()
        conn = board.GetConnectivity()
        base = conn.GetUnconnectedCount(False)
        dead = [t for t in board.GetTracks() if conn.TestTrackEndpointDangling(t, True)]
        kept = 0
        for t in dead:
            board.Remove(t)
            board.BuildConnectivity()
            if board.GetConnectivity().GetUnconnectedCount(False) > base:
                board.Add(t)
            else:
                gone.append(t)
                kept += 1
        removed += kept
        if not kept:
            break
    pcbnew.ZONE_FILLER(board).Fill(board.Zones())
    pcbnew.SaveBoard(path, board, True)
    return widened, removed


def unconnected(path, both=False):
    """KiCad's unrouted connections: {net name: [(x, y) KiCad mm of one end of each]}; with
    both, [((x, y), layers, (x, y), layers) of both ends] instead (layer names)."""
    with tempfile.TemporaryDirectory() as tmp:
        out = os.path.join(tmp, "drc.json")
        subprocess.run([M.KICAD_CLI, "pcb", "drc", "--format", "json", "-o", out, path], capture_output=True)
        report = json.load(open(out))
    left = {}
    for u in report.get("unconnected_items", []):
        ends = [((i["pos"]["x"], i["pos"]["y"]), item_layers(i["description"])) for i in u["items"]]
        d = u["items"][0]["description"]
        if "[" in d and len(ends) == 2:
            left.setdefault(d[d.index("[") + 1:d.index("]")], []).append(
                (ends[0][0], ends[0][1], ends[1][0], ends[1][1]) if both else ends[0][0])
    return left


def item_layers(description):
    """The copper layers an item of KiCad's report is on: "... on F.Cu", "Via ... on F.Cu - B.Cu"
    (all of them), a through-hole pad (no layer named: all of them)."""
    names = ["F.Cu", "In1.Cu", "In2.Cu", "In3.Cu", "In4.Cu", "B.Cu"]
    found = [n for n in names if f" on {n}" in description]
    if " - " in description or not found:
        found = names
    return [pcbnew.F_Cu if n == "F.Cu" else pcbnew.B_Cu if n == "B.Cu" else getattr(pcbnew, n.replace(".", "_"))
            for n in found]


def repair(path, rounds=3):
    """After Freerouting, on the saved board: each net KiCad still finds unconnected gets a try
    with our router (Router.try_rip): it and the nets near its pins are taken up and routed
    again by ours, kept only if fewer connections are left unmade. Ground and LOCKED_NETS stay
    as they are. Saves the board with its fills redone if anything was kept."""
    import pcb_router
    left = unconnected(path)
    if not left:
        return
    board = pcbnew.LoadBoard(path)
    r = pcb_router.Router(board, [(OX + x, OY - y) for x, y in board_outline()], ROUTING_LAYERS)
    code = {board.FindNet(i).GetNetname().split("/")[-1]: i for i in range(1, board.GetNetCount())}
    local, far = other_nets(r, code)
    opts = {}
    for names, o in local + ROUTES + POWER_ROUTES + far:
        o = dict(o, **({"partner": code[o["partner"]]} if "partner" in o else {}))
        opts.update({code[n]: o for n in names})
    fixed = {code[n] for n in LOCKED_NETS}
    pins = {}   # fine-pitch pins by net: their stubs and own vias stay, or the pin is boxed in again
    for fp in board.GetFootprints():
        if fp.GetReference().startswith("U") or fp.GetReference() in STUB_PARTS:
            pts = [(p, pcbnew.ToMM(p.GetPosition().x), pcbnew.ToMM(p.GetPosition().y)) for p in fp.Pads()]
            for p, x, y in pts:
                if p.GetNetCode() and (fp.GetReference() in STUB_PARTS or min(
                        (math.hypot(x - u, y - v) for q, u, v in pts if q is not p), default=9) <= 0.66):
                    pins.setdefault(p.GetNetCode(), []).append((x, y))
    for t in board.GetTracks():
        c = t.GetNetCode()
        ends = [t.GetPosition()] if t.GetClass() == "PCB_VIA" else [t.GetStart(), t.GetEnd()]
        if c not in fixed and not any(math.hypot(pcbnew.ToMM(e.x) - x, pcbnew.ToMM(e.y) - y) < 1.5
                                      for e in ends for x, y in pins.get(c, [])):
            r.routed.setdefault(c, []).append(t)
    order = [c for c in opts if c not in fixed]
    for name, ends in left.items():
        c = board.FindNet(name).GetNetCode()
        r.failed[c] = [(f"{name} at {x:.1f},{y:.1f}", (x, y), "") for x, y in ends]

    def unrouted():   # KiCad's own count, so each try is judged as the check will judge it
        board.BuildConnectivity()
        return board.GetConnectivity().GetUnconnectedCount(False)
    before = unrouted()
    # First a direct track between the two ends KiCad names, kept if KiCad then counts fewer
    for name, pairs in unconnected(path, both=True).items():
        c = board.FindNet(name).GetNetCode()
        for a, on_a, b, on_b in pairs:
            now = unrouted()
            made = r.join_ends(c, a, b, on_a, on_b)
            if made and unrouted() >= now:
                for o in made:
                    r._remove(o)
                r._load()
    r.retry(opts, order, rounds, log=lambda m: print(m.replace("route: pass", "repair: round")), judge=unrouted)
    after = unrouted()
    print(f"repair: {before} unrouted connections on {len(left)} nets before, {after} after")
    if after < before:
        pcbnew.ZONE_FILLER(board).Fill(board.Zones())
        pcbnew.SaveBoard(path, board, True)
        widened, removed = tidy(path)
        print(f"repair: {removed} dead-end tracks and vias removed")


def check():
    """KiCad's DRC, leaving out what an unrouted board is bound to have."""
    with tempfile.TemporaryDirectory() as tmp:
        out = os.path.join(tmp, "drc.json")
        subprocess.run([M.KICAD_CLI, "pcb", "drc", "--format", "json", "--severity-all", "-o", out, BOARD_FILE],
                       capture_output=True)
        report = json.load(open(out))
    skip = {"unconnected_items", "lib_footprint_mismatch", "lib_footprint_issues"}
    found, silk, own = {}, 0, set()
    for v in report.get("violations", []):
        descs = [i["description"] for i in v.get("items", [])]
        refs = {d.rsplit(" of ", 1)[-1].split()[0] for d in descs if " of " in d}
        if v["type"].startswith("silk_"):
            silk += 1
        elif v["type"] == "hole_clearance" and len(refs) == 1 and all(" of " in d for d in descs):
            own.add(refs.pop())   # inside one library footprint: the maker's land pattern
        elif v["type"] not in skip:
            found.setdefault(v["type"], []).append(" / ".join(descs))
    unrouted = len(report.get("unconnected_items", []))
    print(f"check: DRC {sum(len(v) for v in found.values())} problems besides {unrouted} unrouted connections "
          f"and {silk} silkscreen warnings")
    if own:
        print(f"    (hole clearance inside the library footprints of {', '.join(sorted(own))} not counted)")
    for kind, items in sorted(found.items()):
        print(f"    {kind}: {len(items)}")
        for i in items[:6]:
            print("       ", i)


def export_glb():
    """The board as a 3D model for the case model (tools/make_case.py): case/pcb.glb."""
    path = os.path.join(ROOT, "case", "pcb.glb")
    r = subprocess.run([M.KICAD_CLI, "pcb", "export", "glb", "-f", "--subst-models", "--include-tracks",
                        "--include-pads", "--include-zones", "--include-silkscreen", "--include-soldermask",
                        f"--user-origin={OX}x{OY}mm", "-o", path, BOARD_FILE], capture_output=True, text=True)
    print(f"export: {os.path.relpath(path, ROOT)}" if r.returncode == 0 else f"export glb failed: {r.stderr}")


def render():
    out = os.path.join(HW, "renders")
    os.makedirs(out, exist_ok=True)
    views = [("pcb_top", ["--side", "top", "-w", "1300", "-h", "2100", "--zoom", "0.95"]),
             ("pcb_bottom", ["--side", "bottom", "-w", "1300", "-h", "2100", "--zoom", "0.95"]),
             ("pcb_angle", ["--side", "top", "--perspective", "--rotate", "-55,0,160", "-w", "2000", "-h", "1600",
                            "--zoom", "0.92"])]
    for name, args in views:
        path = os.path.join(out, name + ".png")
        r = subprocess.run([M.KICAD_CLI, "pcb", "render", "--quality", "high", "--background", "opaque",
                            "-o", path] + args + [BOARD_FILE], capture_output=True, text=True)
        print(f"render: {os.path.relpath(path, ROOT)}" if r.returncode == 0 else f"render {name} failed: {r.stderr}")


if __name__ == "__main__":
    if "--repair" in sys.argv:   # only the repair step, on the board as it is
        repair(BOARD_FILE)
        check()
        if RENDER:
            render()
        export_glb()
    else:
        build()
