HedgehogsGX/e-ink-dap/(commit log)

2026-10-16 Set up PlatformIO firmware with bare-board tests
    Project notes (PROJECT.md, AGENTS.md) with the screen and board revision
    settled: GDEY037T03-T02 touch e-paper on the ESP32-FTS02, DevKitC-1 v1.1.
    include/pins.h is the frozen pin map.
    PlatformIO on pioarduino 55.03.312-1 (Arduino core 3.3.12), using the
    board's native USB port with a watchdog reset after upload.
    Tested on the bare board:
    - selftest: chip/flash/PSRAM check, pull-only pin check, LED revision probe
    - i2s_clocks: MCK/BCK/LRCK measured on-chip at 44.1-96 kHz
    - decode_bench: dr_flac/dr_mp3 CPU cost per format (96/24 FLAC = 18% of a core)
    - player: two-core skeleton with serial and button control, underrun counter
    Built, waiting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
    [bench_16MB.csv]
2026-10-24 Note the FTS02 socket pin for each e-paper and touch GPIO
    The comments in include/pins.h give the matching pin on the FTS02's
    Raspberry Pi socket (schematic 20250819) and how the panel is powered,
    so the jumpers can be wired straight from the file.
2026-10-24 Rename the Lock key to Power: hold switches the player off
    The player keeps four keys, now on the sides of the case: Play, Vol+,
    Vol- and Power. Power replaces Lock: a short press locks or unlocks,
    holding it gives the new PowerOff command, also while locked. Home is
    reached by tapping the status bar only.
    PIN_BTN_LOCK is now PIN_BTN_POWER (still GPIO42). The bring-up, selftest
    and player programs use the new name; the player skeleton still only
    toggles the lock, as the bare board has nothing to switch off.
    [main.cpp, pins.h]
2026-10-24 Add a first 3D model of the case
    tools/make_case.py builds the Phase 2 case in Blender from the parts
    chosen so far and writes case/: the assembled model with dummy parts
    inside (dap_case.blend), STLs to print (front shell, back cover, volume
    key x2, power key, play key) and renders.
    The case is 65 x 110 x 15.2 mm. The 606090 battery sits behind the
    centred screen; the jacks and USB-C take the top 15 mm, where the
    battery isn't, which sets the length. Vol+/Vol- are on the left side,
    Power and Play/Pause on the right, microSD in the bottom edge. The back
    cover hooks in at the bottom and takes two M2 screws at the top.
    The script checks that every printed part is a closed mesh and that no
    tw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
    [back_cover.stl, dap_case.blend, front_shell.stl, play_key.stl, power_key.stl, volume_key.stl]
2026-10-27 Add a UI demo of the home screen, Reader and Settings
    lib/ui draws the home screen, the book shelf, a book page, the reader
    menu, contents and bookmarks, every Settings page and a Music
    placeholder into a 1-bit frame, driven by taps, swipes and the four
    side keys. It is plain C++, so the same code runs in two places:
    - ui_sim draws the screens on the Mac as PNGs (pio run -e ui_sim). Its
    built-in tour goes through every screen and checks the touch
    calibration with a rotated, rescaled touch panel.
    - ui_demo runs it on the board with only the screen and touch wired.
    tools/make_ui_demo.py builds the books and fonts with build_index.py
    and packs them into flash, so no SD card is needed.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
2026-10-27 Add a step-by-step assembly guide for the breadboard prototype
    docs/phase1_assembly.md walks through the Phase 1 build one subsystem
    at a time, testing each before the next: DevKitC and power, screen and
    touch, microSD, DAC, keys. Every wire names its pin on both ends, and
    the steps that can harm the hardware or ears carry a warning.
    The screen and touch wires go in together, because the FTS02's socket
    is on its back and the panel's ribbon is only 1 cm long; the two tests
    still run separately.
    docs/phase1_wiring.svg is drawn from include/pins.h by
    tools/make_wiring_diagram.py, so it follows any change to the pin map.
2026-10-27 Plan the player board and draw its schematic
    docs/pcb_plan.md is stage 1 of the Phase 2 board: block diagram, power
    tree, final pin map and parts list with JLCPCB numbers. It changes
    three things from the earlier notes: a BQ24073 charger (output held at
    4.4 V, inside the CS43131's VP limit), the CS43131s make the audio
    clocks with the ESP32 as I2S slave, and Play and Power move to GPIO0
    and GPIO1 so they can wake the player from deep sleep.
    Stage 2, the schematic, is generated by tools/make_schematic.py into
    hardware/ as a KiCad 10 project, one sheet per block, from the DESIGN
    table in the script (tools/kicad_sch.py does the drawing). Every pin is
    either connected or marked not connected. E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
    [audio.kicad_sch, dap.kicad_sch, display.kicad_sch, mcu.kicad_sch, power.kicad_sch, usb_storage.kicad_sch]
2026-10-27 Place and route the player board
    Stage 3 of the Phase 2 board. tools/make_pcb.py (run in KiCad's own
    Python) builds hardware/dap.kicad_pcb from the schematic's netlist: a
    4-layer, 1.2 mm board cut to the case's outline, all 158 parts placed,
    JLCPCB's 4-layer limits as design rules, stand-in footprints and 3D
    models for parts KiCad doesn't have, and renders in hardware/renders/.
    It also exports case/pcb.glb for the case model (not tracked).
    Routing: tools/pcb_router.py, a small grid router, does the ground vias
    to the planes on layers 2 and 3, the USB pair, the audio nets and the
    power rails as wide tracks plus a 3.3 V fill on the bottom layer.
    Freerouting (downloaded into tools/freerouting.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
    [dap.kicad_pcb]
2026-10-27 Write draft JLCPCB files for the player board
    tools/make_jlc.py writes hardware/jlcpcb/: Gerbers and drill files
    (zipped and unzipped), the BOM and placement files in JLCPCB's columns,
    and readiness.txt with the order settings and what still blocks an
    order.
    The files are a draft and named so: 28 connections are unrouted, the
    touch FPC, microSD and both jacks use stand-in footprints, 120 parts
    have no LCSC number yet, and a few datasheet points are unconfirmed.
    [dap-B_Cu.gbl, dap-B_Mask.gbs, dap-B_Paste.gbp, dap-B_Silkscreen.gbo, dap-Edge_Cuts.gm1, dap-F_Cu.gtl, dap-F_Mask.gts, dap-F_Paste.gtp]
2026-10-27 Put the real board into the case model
    tools/make_case.py now loads case/pcb.glb, written by make_pcb.py, in
    place of the dummy board, and checks whether any part under the panel
    reaches into the panel's layer. It adds a render with the panel taken
    out (case/renders/inside.png). Pass -- --dummy-board for the old boxes.
    The renders, the model and the front shell STL are regenerated. The
    case's USB-C hole still needs to move up about 3 mm for the top-mount
    USB-C on the board.
    [dap_case.blend, front_shell.stl]
2026-10-31 Use the chosen parts in the schematic, with their LCSC numbers
    The headphone jacks are now real parts. The 3.5 mm SHOU HAN PJ-342 is a
    3-pole stereo jack, per its drawing: tip 3, ring 6, sleeve 5 and 2, and a
    switch on tip and ring that touches them while no plug is in. Its tip
    switch drives the left DAC's HP_DETECT, so the firmware sets
    HPDETECT_INV. The 4.4 mm jack is the Kinghelm KH-PJ-44002-12DBAP-A: two
    pins per pole in Pentaconn order and a separate plug switch from DET_44
    to ground.
    Checked against the datasheets: the oscillators' OE is high or open =
    running and tri-state when low, so they can share MCLK; the GL823K's VDD
    and VDDA are both its own 3.3 V. The CS43131 FILT capacitors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
    [audio.kicad_sch, dap.kicad_sch, display.kicad_sch, mcu.kicad_sch, power.kicad_sch, usb_storage.kicad_sch]
2026-10-31 Lengthen the board and case, hang both jacks under the board
    The owner moved to a 5000 mAh 806090 cell (8 mm thick), and a 4.4 mm
    jack turned out to be about 21 mm deep, not 14. Both headphone jacks now
    hang from the back of the board into the top end, where the battery
    isn't: the case is 65 x 116 x 17.2 mm and the board 60.8 x 111.8 mm.
    Each port's hole is at its own part's height. The case check now also
    looks for parts under the board that reach the battery or the back.
    Footprints from the parts' drawings: the PJ-342 (SMD, two pegs), the
    Kinghelm 4.4 mm jack (12 plated slots, a 1.15 mm notch so its nose ends
    inside the case's face, and the cut-out its drawing asks for, with a
    keep-out fo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
    [back_cover.stl, dap.kicad_pcb, dap_case.blend, front_shell.stl, volume_key.stl]
2026-10-31 Update the JLCPCB files and the board plan
    make_jlc.py: the jacks on the back and the battery wires are soldered by
    hand; no stand-in footprints are left; the readiness notes say what to
    check before ordering (CS43131 out of stock at JLCPCB: pre-order 4; the
    touch ribbon's contact side; plug-detect polarity) and the order
    settings (5 boards, 2 assembled, plated slots and one cut-out). Old
    unpacked Gerber folders are removed too.
    The files stay a draft: the only blocker left is 32 unrouted
    connections. docs/pcb_plan.md records the parts, the datasheet checks,
    the new size and what the routing tries gave.
    [dap-B_Cu.gbl, dap-B_Mask.gbs, dap-B_Paste.gbp, dap-B_Silkscreen.gbo, dap-Edge_Cuts.gm1, dap-F_Cu.gtl, dap-F_Mask.gts, dap-F_Paste.gtp]
2026-10-31 Route the board on 6 layers
    The board is now top, ground, signal, signal, ground, bottom, and every
    net is routed with KiCad's DRC clean.
    - Our router routes every net. Its search is guided by the true distance
    through free space (Dijkstra over the window), so long connections no
    longer run out of steps.
    - Each fine-pitch pin, every FPC connector pin and every ESP32 pin gets an
    escape stub and a via of its own before routing, so nothing can wall it
    in. A pin with no room takes back its neighbours' vias.
    - Rip-up is a trial: kept only if fewer connections are left, otherwise
    put back exactly. It may also move neighbouring pins' vias.
    - DAC capacitors that sit between two pins of th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
    [dap.kicad_pcb]
2026-10-31 Update the JLCPCB files for the 6-layer board: ready to order
    [dap-cpl.csv]
2026-10-31 Put the routed 6-layer board into the case model
    [dap_case.blend]
2026-10-31 Describe the 6-layer board and how it was routed in the board plan
2026-10-31 Keep the WROOM-1 module and its PCB antenna for the first order
2026-10-31 Add 嘉立创 parts and placement files and its order steps
    [dap-bom-cn.csv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]
2026-10-31 Widen the thermal vias to 0.3 mm and note the 嘉立创 board form
    KiCad's footprints put 0.2 mm thermal vias in the centre pads of both
    CS43131s, the TPS63001 and the ESP32 module. On 嘉立创's 6-layer form a
    0.2 mm hole added ¥229 to the 5-board order (the hole size, plus a
    four-wire test and TG155 material it then requires). make_pcb.py now
    widens them to 0.3 mm (MIN_HOLE) with the pads unchanged, and the DRC
    rule's smallest hole is 0.3 mm. Applied to the routed board without
    rerouting: DRC still clean, nothing unrouted.
    The order notes follow what the form asks: the stackup JLC06121H-3313
    (free, 1.14 mm finished, 0.0994 mm outer prepreg, which the USB pairs
    are drawn for), the Gerber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
    [dap.kicad_pcb]
2026-11-11 Revise the board after review and fix the JLC placement rotations
    A review of the whole design before ordering found no wiring errors
    (the CS43131 and GL823K checked pin by pin against their datasheets,
    every chip against JLCPCB's own symbol for its LCSC number), but five
    things worth changing. Board v0.2:
    - Reset pads JP1 on the back, beside the battery pads: bridging them
    restarts the ESP32. The board has no power switch and the battery is
    soldered, so a hung ESP32 could only be reset by unsoldering it.
    - The ESP32's 10 µF and 100 nF move from about 20 mm away to its
    3.3 V pin (3 mm).
    - Both CS43131 XTO pins go to ground, as Cirrus draws it for an
    external master clock.
    - TPS6300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
    [audio.kicad_sch, dap-bom-cn.csv, dap-bom.csv, dap.kicad_pcb, dap.kicad_sch, dap_case.blend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]
2026-11-11 Fix the audit findings in board v0.3
    An independent check against the makers' datasheets and drawings found
    four things; all are fixed and the board is placed and routed again.
    - L2, the 5 V boost's 1 uH inductor, failed TI's worst-case check
    (about 2.16 A peak against 1.85 A saturation): now a Murata
    DFE252012F-1R0M=P2 (C435392, 4.7 A saturation), same size.
    - L3, the e-paper booster's 10 uH inductor, was rated 0.77 A where
    the panel's reference circuit asks for 1 A: now a Sunlord
    WPN4020H100MT (C98364, 2.0 A rated), 4 x 4 mm.
    - E-paper pin 4 is left open, as the GDEY037T03 spec says, and the
    e-paper nets carry the spec's names. The capacitors after the old
    C25 move down one nu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
    [audio.kicad_sch, dap-bom-cn.csv, dap-bom.csv, dap.kicad_pcb, dap.kicad_sch, dap_case.blend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]
2026-11-12 Correct two figures in the v0.3 audit notes and record the re-check
    A second, independent check of board v0.3 (everything rebuilt from the
    scripts in a separate copy, the makers' documents read afresh) found
    the board and the factory files right, and two figures in the notes off:
    - L3 (Sunlord WPN4020H100MT): 3.5 A is the typical saturation current;
    2.8 A is guaranteed. Its footprint is exactly Sunlord's land pattern.
    - L2's worst-case peak is about 2.3 A, not 2.16 A: the board's 47 k on
    the TPS2553 allows up to 0.62 A (0.57 A is the 49.9 k row).
    Neither changes a part or the board. The USB pair lengths in the board
    plan are now v0.3's (4.6 mm apart), and the plan lists what the
    re-che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
    [make_schematic.py]
